akshada-raghuvanshiii/Adaptive_Retail_Companion/docs/paper/latex/figs/fig5_b1_wheel.pdf

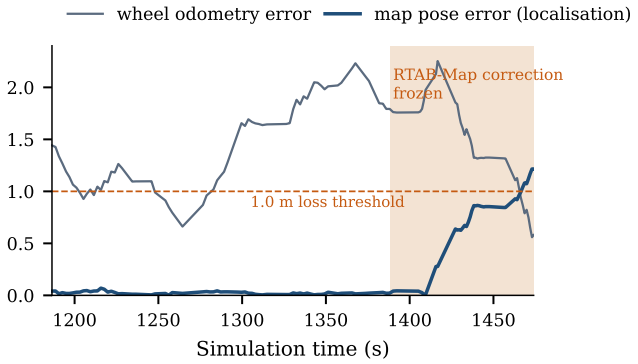
[picture p29: figure]
Simulation time (s); RTAB-Map correction frozen; 1.0 m loss threshold; wheel odometry error; map pose error (localisation)

### Error vs. truth (m)
