akshada-raghuvanshiii/Adaptive_Retail_Companion/docs/paper/latex/figs/fig2_localisation.pdf

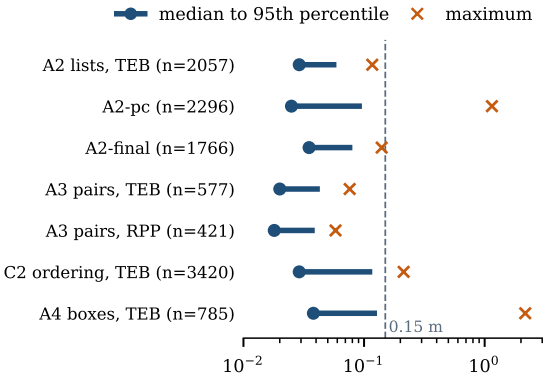
[picture p30: figure]
A4 boxes, TEB (n=785); C2 ordering, TEB (n=3420); A3 pairs, RPP (n=421); A3 pairs, TEB (n=577); A2-final (n=1766); A2 lists, TEB (n=2057); median to 95th percentile; maximum

Position error vs. truth (m, log)
