akshada-raghuvanshiii/Adaptive_Retail_Companion/docs/paper/latex/figs/fig4_c2_time.pdf

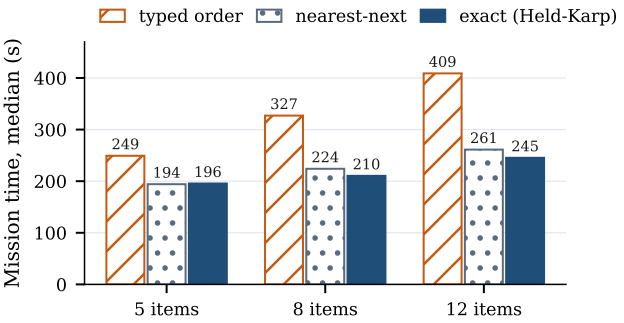
[picture p31: figure]
5 items; 8 items; 12 items; Mission time, median (s); typed order; nearest-next; exact (Held-Karp)
