akshada-raghuvanshiii/Adaptive_Retail_Companion/docs/paper/latex/figs/fig7_phase2_paired.pdf

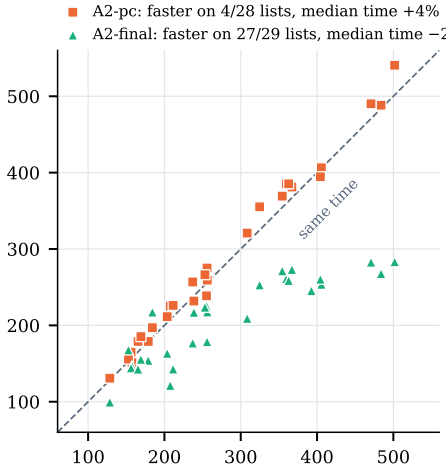
[picture p32: figure]
same time

## A2 mission time (s)

## Variant mission time (s)

points below the line were faster than A2 A2-pc: faster on 4/28 lists, median time +4% A2-final: faster on 27/29 lists, median time −23%
