akshada-raghuvanshiii/Adaptive_Retail_Companion/docs/paper/latex/figs/fig3_c1_ordering.pdf

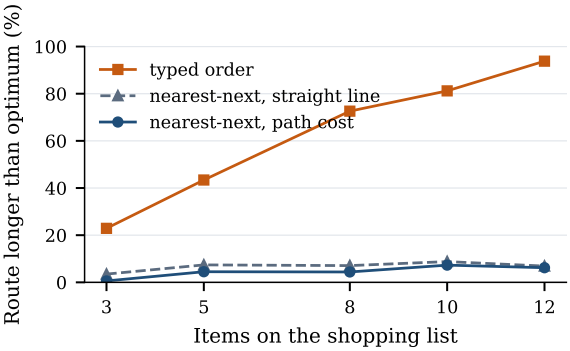
[picture p33: figure]
Items on the shopping list; Route longer than optimum (%); typed order nearest-next, straight line nearest-next, path cost
