akshada-raghuvanshiii/Adaptive_Retail_Companion/mechanical/cad/cart/motor.STEP

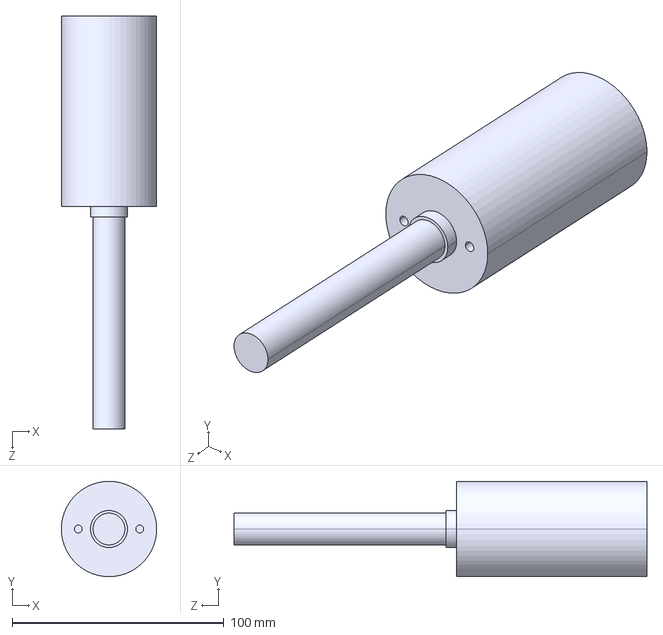
[picture p34: CAD file, 2026-10-20]
mechanical/cad/cart/motor.STEP
45.0 x 45.0 x 195.0 mm
