akshada-raghuvanshiii/Adaptive_Retail_Companion/mechanical/cad/cart/Part2.STEP

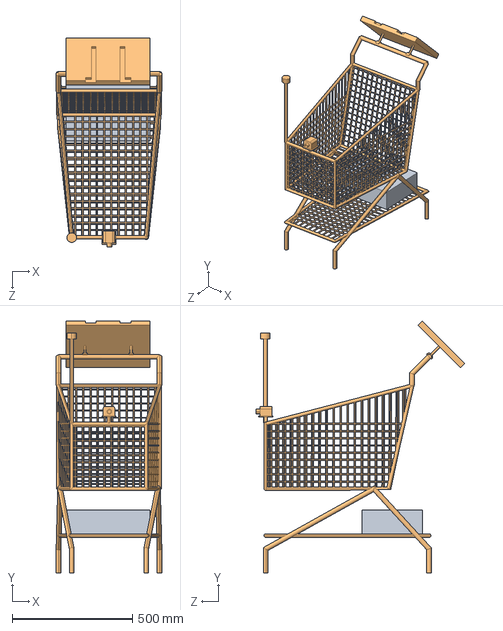
[picture p35: CAD file, 2026-10-20]
mechanical/cad/cart/Part2.STEP
440.0 x 1048.5 x 868.2 mm
