akshada-raghuvanshiii/Adaptive_Retail_Companion/mechanical/cad/cart/flange.STEP

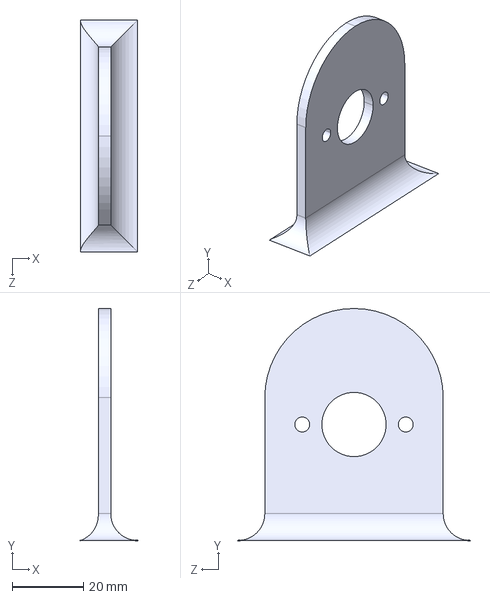
[picture p37: CAD file, 2026-10-20]
mechanical/cad/cart/flange.STEP
16.0 x 65.0 x 65.0 mm
