akshada-raghuvanshiii/Adaptive_Retail_Companion/mechanical/cad/cart/springs.STEP

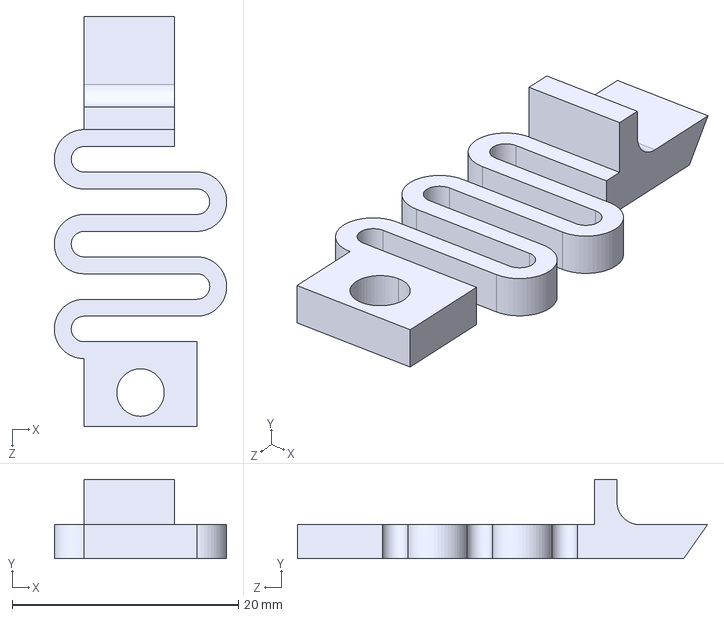
[picture p38: CAD file, 2026-10-20]
mechanical/cad/cart/springs.STEP
15.3 x 7.00 x 36.2 mm
