akshada-raghuvanshiii/Adaptive_Retail_Companion/mechanical/cad/cart/wheel mounts.STEP

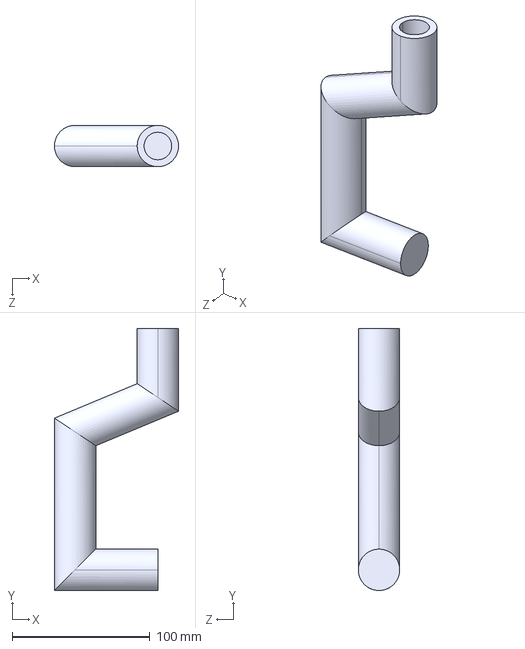
[picture p39: CAD file, 2026-10-20]
mechanical/cad/cart/wheel mounts.STEP
90.0 x 190.0 x 30.0 mm
