akshada-raghuvanshiii/Adaptive_Retail_Companion/mechanical/cad/cart/new sleeve.STEP

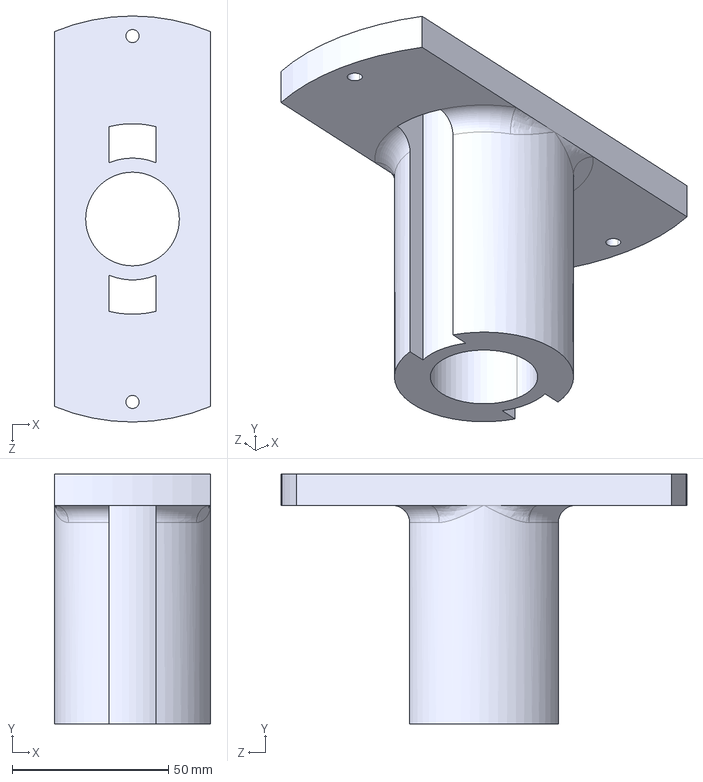
[picture p40: CAD file, 2026-10-20]
mechanical/cad/cart/new sleeve.STEP
50.0 x 80.0 x 130.0 mm
