akshada-raghuvanshiii/Adaptive_Retail_Companion/mechanical/cad/cart/extrude.STEP

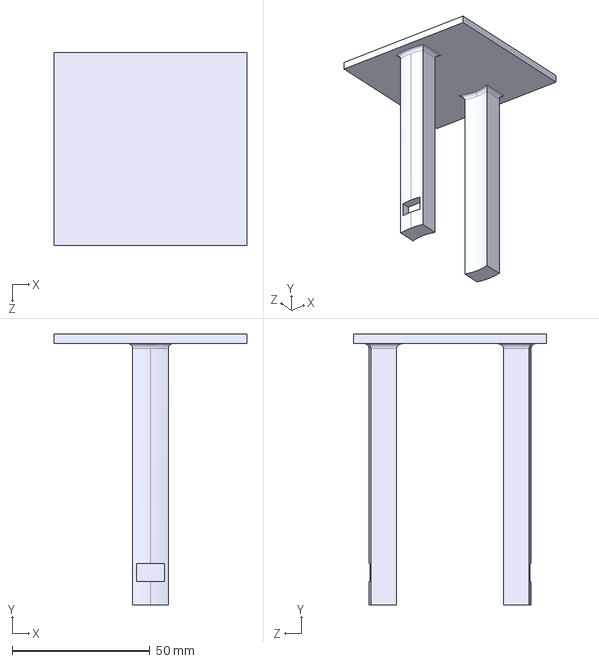
[picture p41: CAD file, 2026-10-20]
mechanical/cad/cart/extrude.STEP
70.0 x 98.5 x 70.0 mm
