akshada-raghuvanshiii/Adaptive_Retail_Companion/mechanical/cad/cart/wheel mounts for motor.STEP

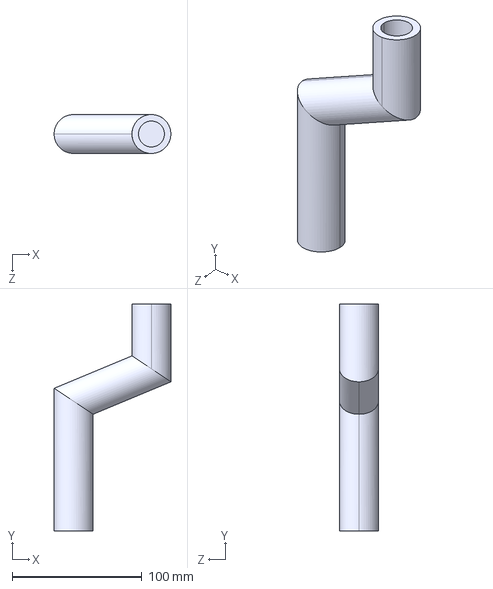
[picture p42: CAD file, 2026-10-20]
mechanical/cad/cart/wheel mounts for motor.STEP
90.0 x 175.0 x 30.0 mm
