akshada-raghuvanshiii/Adaptive_Retail_Companion/mechanical/cad/cart/wheels.STEP

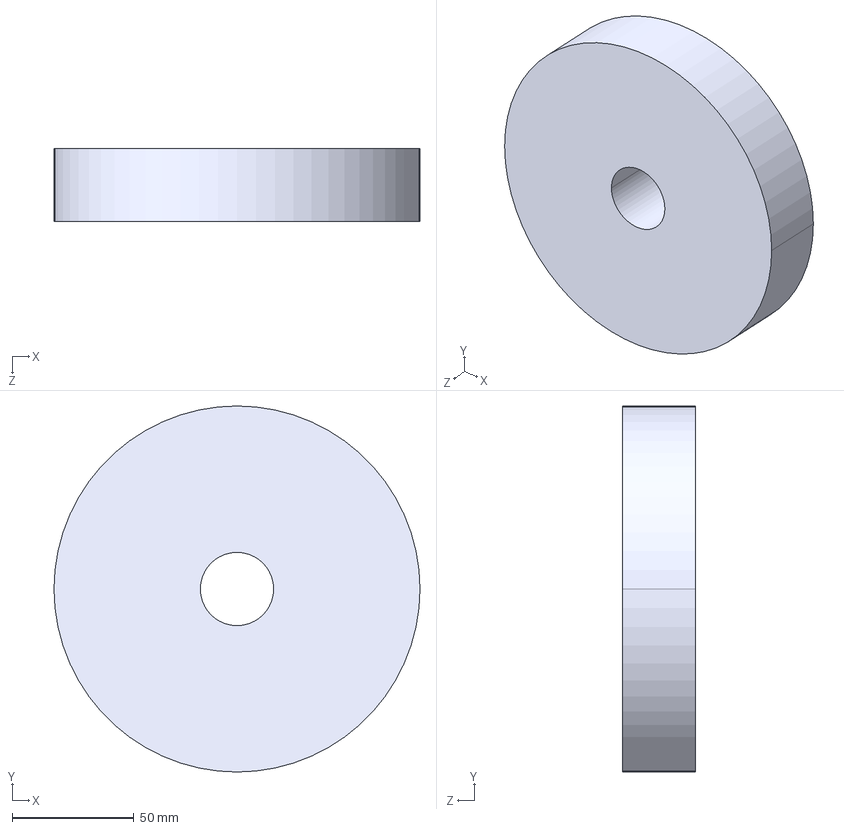
[picture p43: CAD file, 2026-10-20]
mechanical/cad/cart/wheels.STEP
150.0 x 150.0 x 30.0 mm
