akshada-raghuvanshiii/Adaptive_Retail_Companion/(list of files, cad)

Other CAD files:
mechanical/cad/Assem1.step
mechanical/cad/Assem1_v2.step
mechanical/cad/cart/Part5^modular assem.STEP
mechanical/cad/cart/Assem1.STEP
mechanical/cad/cart/Part2^Assem1.STEP
mechanical/cad/cart/Part8^modular assem.STEP
mechanical/cad/cart/Part3^Assem1.STEP
mechanical/cad/cart/Part6^modular assem.STEP
mechanical/cad/cart/Part7^modular assem.STEP
mechanical/cad/cart/Part10^modular assem.STEP
mechanical/cad/cart/modular assem.STEP
