akshada-raghuvanshiii/Adaptive_Retail_Companion/mechanical/simscale/assembly.png

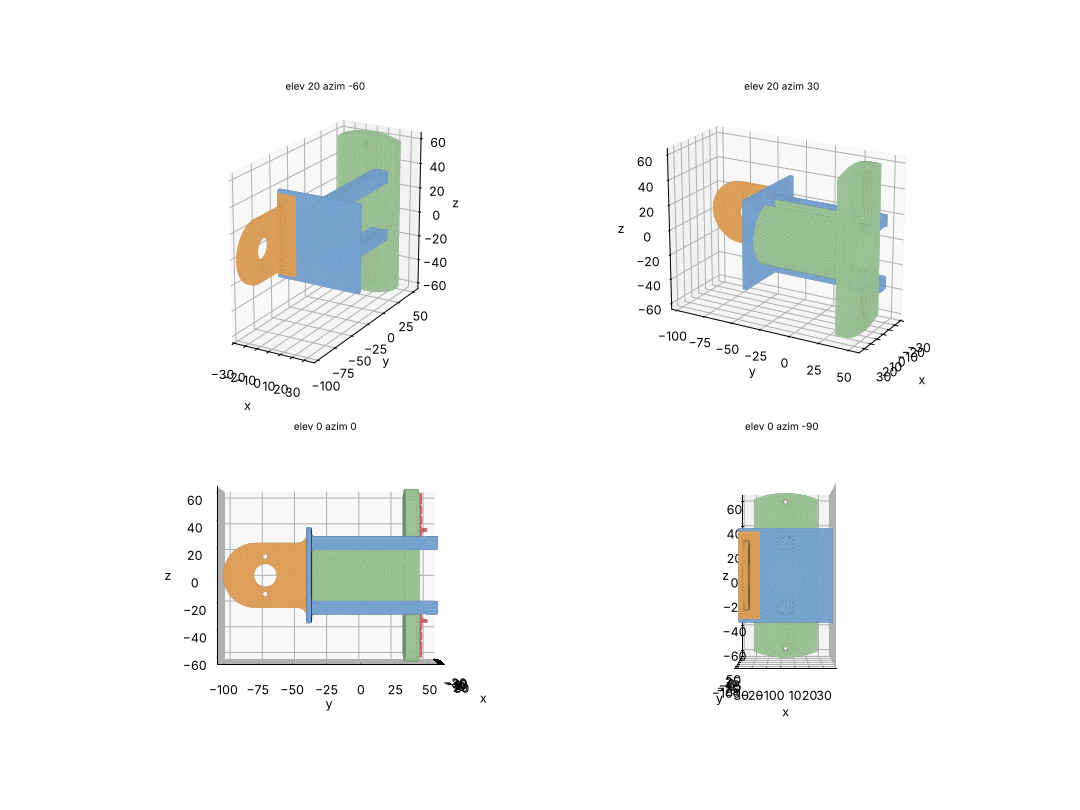
mechanical/simscale/assembly.png
