akshada-raghuvanshiii/Adaptive_Retail_Companion/mechanical/simscale/assembly_iso.png

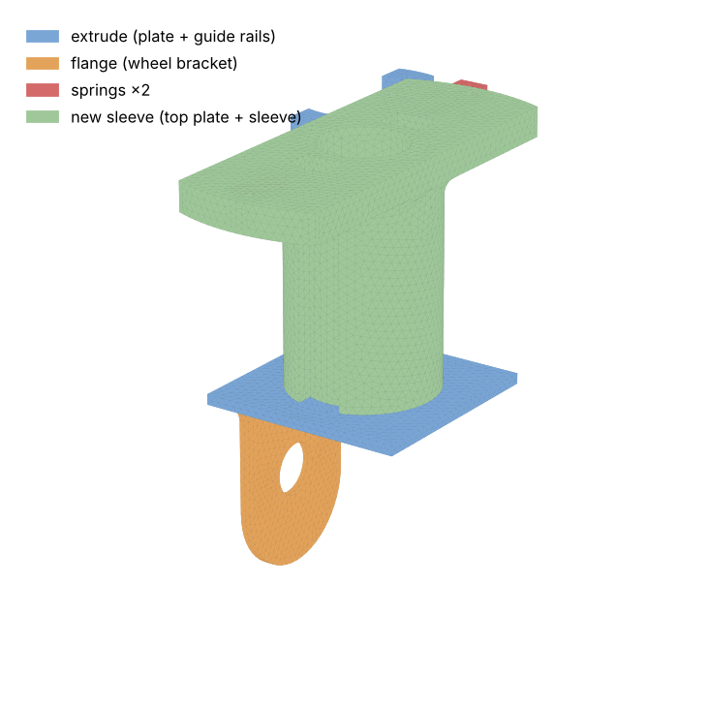
mechanical/simscale/assembly_iso.png
