akshada-raghuvanshiii/Adaptive_Retail_Companion/evaluation/results/events.csv

label | mission | leg | wall_t | sim_t | event | detail
smoke | smoke_s5_000 | -1 | 1792041810.787 | 437.140 | mission_start | pair00
smoke | smoke_s5_000 | -1 | 1792041810.789 | 437.140 | goal_sent | gondola_1_west_a (0.15, -0.40)
smoke | smoke_s5_000 | -1 | 1792041811.685 | 438.112 | path_received | 0.5328 m
smoke | smoke_s5_000 | -1 | 1792041822.475 | 448.128 | controller_aborted
smoke | smoke_s5_000 | -1 | 1792041823.480 | 449.016 | goal_resent | after controller abort
smoke | smoke_s5_000 | -1 | 1792041830.612 | 455.720 | goal_reached_msg
smoke | smoke_s5_000 | 0 | 1792041832.617 | 457.464 | goal_sent | gondola_3_a+gondola_2_east_a (3.48, -0.40)
smoke | smoke_s5_000 | 0 | 1792041837.050 | 461.688 | path_received | 4.3849 m
smoke | smoke_s5_000 | 0 | 1792041888.760 | 509.672 | goal_reached_msg
smoke | smoke_s5_000 | -1 | 1792041890.761 | 511.576 | mission_end | 1/1 legs
teb_icp | teb_icp_s7_000 | -1 | 1792041927.908 | 532.372 | mission_start | s7_r00_n8
teb_icp | teb_icp_s7_000 | -1 | 1792041927.911 | 532.372 | goal_sent | home (0.00, 0.00)
teb_icp | teb_icp_s7_000 | -1 | 1792041927.931 | 547.736 | path_received | 0 m
teb_icp | teb_icp_s7_000 | -1 | 1792041927.942 | 547.744 | goal_reached_msg
teb_icp | teb_icp_s7_000 | 0 | 1792041929.943 | 549.600 | goal_sent | gondola_1_west_a (0.15, -0.40)
teb_icp | teb_icp_s7_000 | 0 | 1792041930.265 | 549.812 | path_received | 4.8971 m
teb_icp | teb_icp_s7_000 | 0 | 1792041991.269 | 607.920 | goal_reached_msg
teb_icp | teb_icp_s7_000 | 1 | 1792041993.276 | 609.812 | goal_sent | dairy (-2.20, 2.75)
teb_icp | teb_icp_s7_000 | 1 | 1792041995.977 | 612.512 | path_received | 3.8663 m
teb_icp | teb_icp_s7_000 | 1 | 1792042044.981 | 659.236 | goal_reached_msg
teb_icp | teb_icp_s7_000 | 2 | 1792042046.987 | 661.112 | goal_sent | gondola_3_b+gondola_2_east_b (3.48, 1.40)
teb_icp | teb_icp_s7_000 | 2 | 1792042050.925 | 664.940 | path_received | 6.4556 m
teb_icp | teb_icp_s7_000 | 2 | 1792042120.431 | 730.072 | goal_reached_msg
teb_icp | teb_icp_s7_000 | 3 | 1792042122.441 | 731.888 | goal_sent | gondola_2_west_a+gondola_1_east_a (1.80, -0.40)
teb_icp | teb_icp_s7_000 | 3 | 1792042124.682 | 733.964 | path_received | 4.4763 m
teb_icp | teb_icp_s7_000 | 3 | 1792042183.106 | 788.892 | goal_reached_msg
teb_icp | teb_icp_s7_000 | -1 | 1792042185.115 | 790.800 | mission_end | 4/4 legs
teb_icp | teb_icp_s7_001 | -1 | 1792042185.115 | 790.800 | mission_start | s7_r01_n12
teb_icp | teb_icp_s7_001 | -1 | 1792042185.115 | 790.800 | goal_sent | home (0.00, 0.00)
teb_icp | teb_icp_s7_001 | -1 | 1792042188.017 | 793.452 | path_received | 3.1678 m
teb_icp | teb_icp_s7_001 | -1 | 1792042230.220 | 832.924 | controller_aborted
teb_icp | teb_icp_s7_001 | -1 | 1792042231.220 | 833.840 | goal_resent | after controller abort
teb_icp | teb_icp_s7_001 | -1 | 1792042233.209 | 835.720 | goal_reached_msg
teb_icp | teb_icp_s7_001 | 0 | 1792042235.214 | 837.628 | goal_sent | gondola_3_b+gondola_2_east_b (3.48, 1.40)
teb_icp | teb_icp_s7_001 | 0 | 1792042239.683 | 841.740 | path_received | 5.8471 m
teb_icp | teb_icp_s7_001 | 0 | 1792042304.395 | 902.880 | goal_reached_msg
teb_icp | teb_icp_s7_001 | 1 | 1792042306.405 | 904.684 | goal_sent | dairy (-2.20, 2.75)
teb_icp | teb_icp_s7_001 | 1 | 1792042311.574 | 909.484 | path_received | 6.3849 m
teb_icp | teb_icp_s7_001 | 1 | 1792042386.284 | 980.712 | goal_reached_msg
teb_icp | teb_icp_s7_001 | 2 | 1792042388.285 | 982.520 | goal_sent | gondola_3_a+gondola_2_east_a (3.48, -0.40)
teb_icp | teb_icp_s7_001 | 2 | 1792042394.295 | 988.156 | goal_resent_no_path
teb_icp | teb_icp_s7_001 | 2 | 1792042394.699 | 988.460 | path_received | 8.1849 m
teb_icp | teb_icp_s7_001 | 2 | 1792042483.102 | 1072.324 | goal_reached_msg
teb_icp | teb_icp_s7_001 | 3 | 1792042485.104 | 1074.232 | goal_sent | tea_coffee (-2.45, 0.40)
teb_icp | teb_icp_s7_001 | 3 | 1792042490.372 | 1079.252 | path_received | 7.1113 m
teb_icp | teb_icp_s7_001 | 3 | 1792042571.382 | 1156.920 | goal_reached_msg
teb_icp | teb_icp_s7_001 | 4 | 1792042573.405 | 1158.752 | goal_sent | gondola_1_west_a (0.15, -0.40)
teb_icp | teb_icp_s7_001 | 4 | 1792042576.323 | 1161.560 | path_received | 2.9314 m
teb_icp | teb_icp_s7_001 | 4 | 1792042614.219 | 1197.352 | controller_aborted
teb_icp | teb_icp_s7_001 | 4 | 1792042615.219 | 1198.360 | goal_resent | after controller abort
teb_icp | teb_icp_s7_001 | 4 | 1792042617.978 | 1201.112 | goal_reached_msg
teb_icp | teb_icp_s7_001 | 5 | 1792042619.982 | 1203.088 | goal_sent | produce (-1.40, 0.05)
teb_icp | teb_icp_s7_001 | 5 | 1792042621.995 | 1204.888 | path_received | 1.7364 m
teb_icp | teb_icp_s7_001 | 5 | 1792042649.604 | 1230.912 | goal_reached_msg
teb_icp | teb_icp_s7_001 | 6 | 1792042651.609 | 1232.824 | goal_sent | gondola_2_west_b+gondola_1_east_b (1.80, 1.40)
teb_icp | teb_icp_s7_001 | 6 | 1792042655.498 | 1236.684 | path_received | 4.7148 m
teb_icp | teb_icp_s7_001 | 6 | 1792042710.905 | 1288.912 | controller_aborted
teb_icp | teb_icp_s7_001 | 6 | 1792042711.910 | 1289.912 | goal_resent | after controller abort
teb_icp | teb_icp_s7_001 | 6 | 1792042717.114 | 1294.692 | goal_reached_msg
teb_icp | teb_icp_s7_001 | -1 | 1792042719.115 | 1296.584 | mission_end | 7/7 legs
teb_icp | teb_icp_s7_002 | -1 | 1792042719.116 | 1296.584 | mission_start | s7_r02_n3
teb_icp | teb_icp_s7_002 | -1 | 1792042719.116 | 1296.584 | goal_sent | home (0.00, 0.00)
teb_icp | teb_icp_s7_002 | -1 | 1792042723.412 | 1300.568 | path_received | 4.0678 m
teb_icp | teb_icp_s7_002 | -1 | 1792042776.116 | 1350.548 | controller_aborted
teb_icp | teb_icp_s7_002 | -1 | 1792042777.117 | 1351.452 | goal_resent | after controller abort
teb_icp | teb_icp_s7_002 | -1 | 1792042779.788 | 1353.900 | goal_reached_msg
teb_icp | teb_icp_s7_002 | 0 | 1792042781.794 | 1355.788 | goal_sent | gondola_3_b+gondola_2_east_b (3.48, 1.40)
teb_icp | teb_icp_s7_002 | 0 | 1792042786.770 | 1360.416 | path_received | 5.8471 m
teb_icp | teb_icp_s7_002 | 0 | 1792042851.272 | 1420.632 | goal_reached_msg
teb_icp | teb_icp_s7_002 | 1 | 1792042853.278 | 1422.448 | goal_sent | gondola_3_a+gondola_2_east_a (3.48, -0.40)
teb_icp | teb_icp_s7_002 | 1 | 1792042855.375 | 1424.448 | path_received | 1.8 m
teb_icp | teb_icp_s7_002 | 1 | 1792042885.390 | 1452.644 | controller_aborted
teb_icp | teb_icp_s7_002 | 1 | 1792042886.394 | 1453.508 | goal_resent | after controller abort
teb_icp | teb_icp_s7_002 | 1 | 1792042890.297 | 1457.104 | goal_reached_msg
teb_icp | teb_icp_s7_002 | 2 | 1792042892.303 | 1459.008 | goal_sent | gondola_2_west_a+gondola_1_east_a (1.80, -0.40)
teb_icp | teb_icp_s7_002 | 2 | 1792042894.123 | 1460.772 | path_received | 2.7056 m
teb_icp | teb_icp_s7_002 | 2 | 1792042937.228 | 1501.036 | goal_reached_msg
teb_icp | teb_icp_s7_002 | -1 | 1792042939.233 | 1502.848 | mission_end | 3/3 legs
teb_icp | teb_icp_s7_003 | -1 | 1792042939.233 | 1502.848 | mission_start | s7_r03_n6
teb_icp | teb_icp_s7_003 | -1 | 1792042939.233 | 1502.848 | goal_sent | home (0.00, 0.00)
teb_icp | teb_icp_s7_003 | -1 | 1792042942.076 | 1505.480 | path_received | 3.1678 m
teb_icp | teb_icp_s7_003 | -1 | 1792042983.485 | 1544.740 | controller_aborted
teb_icp | teb_icp_s7_003 | -1 | 1792042984.492 | 1545.620 | goal_resent | after controller abort
teb_icp | teb_icp_s7_003 | -1 | 1792042987.593 | 1548.500 | goal_reached_msg
teb_icp | teb_icp_s7_003 | 0 | 1792042989.598 | 1550.404 | goal_sent | gondola_3_b+gondola_2_east_b (3.48, 1.40)
teb_icp | teb_icp_s7_003 | 0 | 1792042995.599 | 1555.948 | goal_resent_no_path
teb_icp | teb_icp_s7_003 | 0 | 1792042996.103 | 1556.432 | path_received | 5.8471 m
teb_icp | teb_icp_s7_003 | 0 | 1792043062.208 | 1618.312 | goal_reached_msg
teb_icp | teb_icp_s7_003 | 1 | 1792043064.214 | 1620.316 | goal_sent | tea_coffee (-2.45, 0.40)
teb_icp | teb_icp_s7_003 | 1 | 1792043070.215 | 1625.852 | goal_resent_no_path
teb_icp | teb_icp_s7_003 | 1 | 1792043070.541 | 1626.176 | path_received | 7.4406 m
teb_icp | teb_icp_s7_003 | 1 | 1792043157.054 | 1707.652 | goal_reached_msg
teb_icp | teb_icp_s7_003 | 2 | 1792043159.060 | 1709.660 | goal_sent | gondola_3_a+gondola_2_east_a (3.48, -0.40)
teb_icp | teb_icp_s7_003 | 2 | 1792043162.695 | 1713.260 | path_received | 7.1113 m
teb_icp | teb_icp_s7_003 | 2 | 1792043219.068 | 1766.936 | sim_link_lost | no Gazebo pose for 15 s
teb_icp | teb_icp_s7_003 | 2 | 1792043219.068 | 1766.936 | leg_failed | sim_link_lost
teb_icp | teb_icp_s7_003 | 2 | 1792043219.080 | 1766.948 | runner_cancelled_follow_path
teb_icp | teb_icp_s7_003 | -1 | 1792043221.083 | 1768.848 | mission_end | 2/4 legs
teb_icp | teb_icp_s7_003 | -1 | 1792043712.068 | 2234.884 | mission_start | s7_r03_n6
teb_icp | teb_icp_s7_003 | -1 | 1792043712.070 | 2234.884 | goal_sent | home (0.00, 0.00)
teb_icp | teb_icp_s7_003 | -1 | 1792043715.212 | 2252.172 | path_received | 4.8471 m
teb_icp | teb_icp_s7_003 | -1 | 1792043777.485 | 2310.268 | goal_reached_msg
teb_icp | teb_icp_s7_003 | 0 | 1792043779.496 | 2312.040 | goal_sent | gondola_3_b+gondola_2_east_b (3.48, 1.40)
teb_icp | teb_icp_s7_003 | 0 | 1792043785.502 | 2317.704 | goal_resent_no_path
teb_icp | teb_icp_s7_003 | 0 | 1792043786.022 | 2318.128 | path_received | 5.8471 m
teb_icp | teb_icp_s7_003 | 0 | 1792043850.038 | 2379.236 | goal_reached_msg
teb_icp | teb_icp_s7_003 | 1 | 1792043852.042 | 2381.136 | goal_sent | tea_coffee (-2.45, 0.40)
teb_icp | teb_icp_s7_003 | 1 | 1792043857.284 | 2386.004 | path_received | 7.4406 m
teb_icp | teb_icp_s7_003 | 1 | 1792043943.291 | 2467.504 | goal_reached_msg
teb_icp | teb_icp_s7_003 | 2 | 1792043945.293 | 2469.380 | goal_sent | gondola_3_a+gondola_2_east_a (3.48, -0.40)
teb_icp | teb_icp_s7_003 | 2 | 1792043949.794 | 2473.756 | path_received | 7.1113 m
teb_icp | teb_icp_s7_003 | 2 | 1792044023.696 | 2544.688 | goal_reached_msg
teb_icp | teb_icp_s7_003 | 3 | 1792044025.707 | 2546.576 | goal_sent | gondola_2_west_b+gondola_1_east_b (1.80, 1.40)
teb_icp | teb_icp_s7_003 | 3 | 1792044028.848 | 2549.696 | path_received | 4.4763 m
teb_icp | teb_icp_s7_003 | 3 | 1792044085.951 | 2604.224 | goal_reached_msg
teb_icp | teb_icp_s7_003 | -1 | 1792044087.956 | 2606.032 | mission_end | 4/4 legs
teb_icp | teb_icp_s7_004 | -1 | 1792044087.956 | 2606.032 | mission_start | s7_r04_n9
teb_icp | teb_icp_s7_004 | -1 | 1792044087.957 | 2606.032 | goal_sent | home (0.00, 0.00)
teb_icp | teb_icp_s7_004 | -1 | 1792044092.054 | 2610.092 | path_received | 4.0678 m
teb_icp | teb_icp_s7_004 | -1 | 1792044144.156 | 2660.180 | controller_aborted
teb_icp | teb_icp_s7_004 | -1 | 1792044145.160 | 2661.156 | goal_resent | after controller abort
teb_icp | teb_icp_s7_004 | -1 | 1792044148.223 | 2664.108 | goal_reached_msg
teb_icp | teb_icp_s7_004 | 0 | 1792044150.225 | 2665.924 | goal_sent | gondola_3_b+gondola_2_east_b (3.48, 1.40)
teb_icp | teb_icp_s7_004 | 0 | 1792044155.052 | 2670.372 | path_received | 5.8471 m
teb_icp | teb_icp_s7_004 | 0 | 1792044228.156 | 2739.732 | controller_aborted
teb_icp | teb_icp_s7_004 | 0 | 1792044229.160 | 2740.596 | goal_resent | after controller abort
teb_icp | teb_icp_s7_004 | 0 | 1792044232.358 | 2743.692 | goal_reached_msg
teb_icp | teb_icp_s7_004 | 1 | 1792044234.363 | 2745.700 | goal_sent | gondola_3_a+gondola_2_east_a (3.48, -0.40)
teb_icp | teb_icp_s7_004 | 1 | 1792044235.023 | 2746.340 | path_received | 1.8 m
teb_icp | teb_icp_s7_004 | 1 | 1792044264.122 | 2774.688 | controller_aborted
teb_icp | teb_icp_s7_004 | 1 | 1792044265.124 | 2775.688 | goal_resent | after controller abort
teb_icp | teb_icp_s7_004 | 1 | 1792044267.549 | 2778.112 | goal_reached_msg
teb_icp | teb_icp_s7_004 | 2 | 1792044269.552 | 2780.092 | goal_sent | tea_coffee (-2.45, 0.40)
teb_icp | teb_icp_s7_004 | 2 | 1792044275.453 | 2785.780 | path_received | 7.1113 m
teb_icp | teb_icp_s7_004 | 2 | 1792044357.155 | 2863.316 | goal_reached_msg
teb_icp | teb_icp_s7_004 | 3 | 1792044359.157 | 2865.200 | goal_sent | gondola_1_west_a (0.15, -0.40)
teb_icp | teb_icp_s7_004 | 3 | 1792044361.481 | 2867.300 | path_received | 2.9314 m
teb_icp | teb_icp_s7_004 | 3 | 1792044398.976 | 2902.868 | controller_aborted
teb_icp | teb_icp_s7_004 | 3 | 1792044399.981 | 2903.852 | goal_resent | after controller abort
teb_icp | teb_icp_s7_004 | 3 | 1792044405.035 | 2908.472 | goal_reached_msg
teb_icp | teb_icp_s7_004 | 4 | 1792044407.039 | 2910.384 | goal_sent | gondola_2_west_b+gondola_1_east_b (1.80, 1.40)
teb_icp | teb_icp_s7_004 | 4 | 1792044412.341 | 2915.304 | path_received | 4.4056 m
teb_icp | teb_icp_s7_004 | 4 | 1792044469.544 | 2968.948 | controller_aborted
teb_icp | teb_icp_s7_004 | 4 | 1792044470.549 | 2969.948 | goal_resent | after controller abort
teb_icp | teb_icp_s7_004 | 4 | 1792044475.214 | 2974.276 | goal_reached_msg
teb_icp | teb_icp_s7_004 | 5 | 1792044477.218 | 2976.280 | goal_sent | produce (-1.40, 0.05)
teb_icp | teb_icp_s7_004 | 5 | 1792044481.771 | 2980.808 | path_received | 4.7148 m
teb_icp | teb_icp_s7_004 | 5 | 1792044538.776 | 3035.752 | controller_aborted
teb_icp | teb_icp_s7_004 | 5 | 1792044539.799 | 3036.676 | goal_resent | after controller abort
teb_icp | teb_icp_s7_004 | 5 | 1792044540.835 | 3037.664 | goal_reached_msg
teb_icp | teb_icp_s7_004 | -1 | 1792044542.841 | 3039.460 | mission_end | 6/6 legs
teb_icp | teb_icp_s7_005 | -1 | 1792044542.841 | 3039.460 | mission_start | s7_r05_n4
teb_icp | teb_icp_s7_005 | -1 | 1792044542.842 | 3039.460 | goal_sent | home (0.00, 0.00)
teb_icp | teb_icp_s7_005 | -1 | 1792044544.092 | 3040.696 | path_received | 1.4207 m
teb_icp | teb_icp_s7_005 | -1 | 1792044556.591 | 3052.648 | goal_reached_msg
teb_icp | teb_icp_s7_005 | 0 | 1792044558.592 | 3054.552 | goal_sent | gondola_3_a+gondola_2_east_a (3.48, -0.40)
teb_icp | teb_icp_s7_005 | 0 | 1792044564.602 | 3060.108 | goal_resent_no_path
teb_icp | teb_icp_s7_005 | 0 | 1792044564.785 | 3060.288 | path_received | 5.0006 m
teb_icp | teb_icp_s7_005 | 0 | 1792044618.188 | 3111.900 | goal_reached_msg
teb_icp | teb_icp_s7_005 | 1 | 1792044620.193 | 3113.804 | goal_sent | gondola_2_west_b+gondola_1_east_b (1.80, 1.40)
teb_icp | teb_icp_s7_005 | 1 | 1792044622.385 | 3115.864 | path_received | 4.4763 m
teb_icp | teb_icp_s7_005 | 1 | 1792044679.599 | 3170.312 | goal_reached_msg
teb_icp | teb_icp_s7_005 | 2 | 1792044681.605 | 3172.316 | goal_sent | gondola_3_b+gondola_2_east_b (3.48, 1.40)
teb_icp | teb_icp_s7_005 | 2 | 1792044684.964 | 3175.440 | path_received | 2.6763 m
teb_icp | teb_icp_s7_005 | 2 | 1792044712.868 | 3202.712 | goal_reached_msg
teb_icp | teb_icp_s7_005 | -1 | 1792044714.871 | 3204.608 | mission_end | 3/3 legs
teb_icp | teb_icp_s7_006 | -1 | 1792044714.871 | 3204.608 | mission_start | s7_r06_n5
teb_icp | teb_icp_s7_006 | -1 | 1792044714.871 | 3204.608 | goal_sent | home (0.00, 0.00)
teb_icp | teb_icp_s7_006 | -1 | 1792044719.222 | 3208.820 | path_received | 5.8471 m
teb_icp | teb_icp_s7_006 | -1 | 1792044790.833 | 3277.448 | goal_reached_msg
teb_icp | teb_icp_s7_006 | 0 | 1792044792.837 | 3279.360 | goal_sent | gondola_2_west_a+gondola_1_east_a (1.80, -0.40)
teb_icp | teb_icp_s7_006 | 0 | 1792044795.290 | 3281.768 | path_received | 3.1678 m
teb_icp | teb_icp_s7_006 | 0 | 1792044831.794 | 3316.256 | goal_reached_msg
teb_icp | teb_icp_s7_006 | 1 | 1792044833.796 | 3318.260 | goal_sent | gondola_3_a+gondola_2_east_a (3.48, -0.40)
teb_icp | teb_icp_s7_006 | 1 | 1792044836.547 | 3320.980 | path_received | 2.7056 m
teb_icp | teb_icp_s7_006 | 1 | 1792044867.154 | 3349.864 | goal_reached_msg
teb_icp | teb_icp_s7_006 | 2 | 1792044869.159 | 3351.868 | goal_sent | gondola_3_b+gondola_2_east_b (3.48, 1.40)
teb_icp | teb_icp_s7_006 | 2 | 1792044869.646 | 3352.352 | path_received | 1.8 m
teb_icp | teb_icp_s7_006 | 2 | 1792044895.354 | 3377.104 | goal_reached_msg
teb_icp | teb_icp_s7_006 | 3 | 1792044897.355 | 3378.996 | goal_sent | dairy (-2.20, 2.75)
teb_icp | teb_icp_s7_006 | 3 | 1792044902.083 | 3383.340 | path_received | 6.3349 m
teb_icp | teb_icp_s7_006 | 3 | 1792044975.092 | 3453.516 | goal_reached_msg
teb_icp | teb_icp_s7_006 | -1 | 1792044977.093 | 3455.424 | mission_end | 4/4 legs
teb_icp | teb_icp_s7_007 | -1 | 1792044977.094 | 3455.424 | mission_start | s7_r07_n4
teb_icp | teb_icp_s7_007 | -1 | 1792044977.094 | 3455.424 | goal_sent | home (0.00, 0.00)
teb_icp | teb_icp_s7_007 | -1 | 1792044979.633 | 3457.752 | path_received | 3.8663 m
teb_icp | teb_icp_s7_007 | -1 | 1792045021.862 | 3498.068 | goal_reached_msg
teb_icp | teb_icp_s7_007 | 0 | 1792045023.864 | 3499.952 | goal_sent | gondola_3_b+gondola_2_east_b (3.48, 1.40)
teb_icp | teb_icp_s7_007 | 0 | 1792045027.621 | 3503.696 | path_received | 5.8471 m
teb_icp | teb_icp_s7_007 | 0 | 1792045093.226 | 3566.464 | goal_reached_msg
teb_icp | teb_icp_s7_007 | 1 | 1792045095.228 | 3568.468 | goal_sent | gondola_1_west_a (0.15, -0.40)
teb_icp | teb_icp_s7_007 | 1 | 1792045099.922 | 3572.876 | path_received | 6.1849 m
teb_icp | teb_icp_s7_007 | 1 | 1792045172.726 | 3641.924 | controller_aborted
teb_icp | teb_icp_s7_007 | 1 | 1792045173.727 | 3642.820 | goal_resent | after controller abort
teb_icp | teb_icp_s7_007 | 1 | 1792045177.224 | 3646.080 | goal_reached_msg
teb_icp | teb_icp_s7_007 | 2 | 1792045179.226 | 3647.972 | goal_sent | gondola_3_a+gondola_2_east_a (3.48, -0.40)
teb_icp | teb_icp_s7_007 | 2 | 1792045182.864 | 3651.364 | path_received | 4.3849 m
teb_icp | teb_icp_s7_007 | 2 | 1792045198.957 | 3667.288 | truth_gap | no Gazebo pose for 15 s (gz service); A1 samples blank
teb_icp | teb_icp_s7_007 | 2 | 1792045221.746 | 3689.616 | truth_gap | no Gazebo pose for 15 s (gz service); A1 samples blank
teb_icp | teb_icp_s7_007 | 2 | 1792045229.467 | 3697.056 | goal_reached_msg
teb_icp | teb_icp_s7_007 | -1 | 1792045231.474 | 3698.944 | mission_end | 3/3 legs
teb_icp | teb_icp_s7_008 | -1 | 1792045231.474 | 3698.944 | mission_start | s7_r08_n3
teb_icp | teb_icp_s7_008 | -1 | 1792045231.474 | 3698.944 | goal_sent | home (0.00, 0.00)
teb_icp | teb_icp_s7_008 | -1 | 1792045234.701 | 3702.076 | path_received | 4.8471 m
teb_icp | teb_icp_s7_008 | -1 | 1792045295.104 | 3760.024 | goal_reached_msg
teb_icp | teb_icp_s7_008 | 0 | 1792045297.108 | 3762.028 | goal_sent | gondola_2_west_a+gondola_1_east_a (1.80, -0.40)
teb_icp | teb_icp_s7_008 | 0 | 1792045301.317 | 3765.996 | path_received | 3.1678 m
teb_icp | teb_icp_s7_008 | 0 | 1792045341.315 | 3804.324 | controller_aborted
teb_icp | teb_icp_s7_008 | 0 | 1792045342.315 | 3805.332 | goal_resent | after controller abort
teb_icp | teb_icp_s7_008 | 0 | 1792045349.317 | 3811.868 | goal_reached_msg
teb_icp | teb_icp_s7_008 | 1 | 1792045351.322 | 3813.672 | goal_sent | gondola_3_a+gondola_2_east_a (3.48, -0.40)
teb_icp | teb_icp_s7_008 | 1 | 1792045353.095 | 3815.324 | path_received | 2.7056 m
teb_icp | teb_icp_s7_008 | 1 | 1792045382.202 | 3843.488 | goal_reached_msg
teb_icp | teb_icp_s7_008 | 2 | 1792045384.210 | 3845.500 | goal_sent | tea_coffee (-2.45, 0.40)
teb_icp | teb_icp_s7_008 | 2 | 1792045390.218 | 3850.980 | goal_resent_no_path
teb_icp | teb_icp_s7_008 | 2 | 1792045390.290 | 3851.048 | path_received | 7.1113 m
teb_icp | teb_icp_s7_008 | 2 | 1792045473.904 | 3928.940 | goal_reached_msg
teb_icp | teb_icp_s7_008 | -1 | 1792045475.911 | 3930.920 | mission_end | 3/3 legs
teb_icp | teb_icp_s7_009 | -1 | 1792045475.911 | 3930.920 | mission_start | s7_r09_n11
teb_icp | teb_icp_s7_009 | -1 | 1792045475.911 | 3930.920 | goal_sent | home (0.00, 0.00)
teb_icp | teb_icp_s7_009 | -1 | 1792045478.648 | 3933.628 | path_received | 2.6157 m
teb_icp | teb_icp_s7_009 | -1 | 1792045517.153 | 3969.564 | controller_aborted
teb_icp | teb_icp_s7_009 | -1 | 1792045518.165 | 3970.576 | goal_resent | after controller abort
teb_icp | teb_icp_s7_009 | -1 | 1792045521.610 | 3973.756 | goal_reached_msg
teb_icp | teb_icp_s7_009 | 0 | 1792045523.614 | 3975.580 | goal_sent | produce (-1.40, 0.05)
teb_icp | teb_icp_s7_009 | 0 | 1792045524.687 | 3976.652 | path_received | 1.4207 m
teb_icp | teb_icp_s7_009 | 0 | 1792045535.196 | 3986.748 | controller_aborted
teb_icp | teb_icp_s7_009 | 0 | 1792045536.201 | 3987.692 | goal_resent | after controller abort
teb_icp | teb_icp_s7_009 | 0 | 1792045552.520 | 4003.524 | goal_reached_msg
teb_icp | teb_icp_s7_009 | 1 | 1792045554.526 | 4005.408 | goal_sent | gondola_2_west_b+gondola_1_east_b (1.80, 1.40)
teb_icp | teb_icp_s7_009 | 1 | 1792045560.181 | 4010.552 | path_received | 4.7148 m
teb_icp | teb_icp_s7_009 | 1 | 1792045615.218 | 4062.752 | controller_aborted
teb_icp | teb_icp_s7_009 | 1 | 1792045616.223 | 4063.756 | goal_resent | after controller abort
teb_icp | teb_icp_s7_009 | 1 | 1792045622.388 | 4069.656 | goal_reached_msg
teb_icp | teb_icp_s7_009 | 2 | 1792045624.398 | 4071.552 | goal_sent | gondola_3_a+gondola_2_east_a (3.48, -0.40)
teb_icp | teb_icp_s7_009 | 2 | 1792045629.328 | 4076.020 | path_received | 4.4763 m
teb_icp | teb_icp_s7_009 | 2 | 1792045679.123 | 4122.300 | goal_reached_msg
teb_icp | teb_icp_s7_009 | 3 | 1792045681.135 | 4124.196 | goal_sent | gondola_1_west_b (0.15, 1.40)
teb_icp | teb_icp_s7_009 | 3 | 1792045687.138 | 4130.016 | goal_resent_no_path
teb_icp | teb_icp_s7_009 | 3 | 1792045687.408 | 4130.268 | path_received | 6.1849 m
teb_icp | teb_icp_s7_009 | 3 | 1792045762.409 | 4200.468 | controller_aborted
teb_icp | teb_icp_s7_009 | 3 | 1792045763.410 | 4201.480 | goal_resent | after controller abort
teb_icp | teb_icp_s7_009 | 3 | 1792045768.561 | 4206.504 | goal_reached_msg
teb_icp | teb_icp_s7_009 | 4 | 1792045770.567 | 4208.512 | goal_sent | tea_coffee (-2.45, 0.40)
teb_icp | teb_icp_s7_009 | 4 | 1792045774.975 | 4212.656 | path_received | 3.0556 m
teb_icp | teb_icp_s7_009 | 4 | 1792045816.173 | 4252.036 | goal_reached_msg
teb_icp | teb_icp_s7_009 | 5 | 1792045818.183 | 4254.028 | goal_sent | dairy (-2.20, 2.75)
teb_icp | teb_icp_s7_009 | 5 | 1792045821.537 | 4257.236 | path_received | 2.4536 m
teb_icp | teb_icp_s7_009 | 5 | 1792045851.442 | 4285.672 | goal_reached_msg
teb_icp | teb_icp_s7_009 | 6 | 1792045853.449 | 4287.580 | goal_sent | gondola_3_b+gondola_2_east_b (3.48, 1.40)
teb_icp | teb_icp_s7_009 | 6 | 1792045858.599 | 4292.168 | path_received | 6.3849 m
teb_icp | teb_icp_s7_009 | 6 | 1792045927.306 | 4357.260 | goal_reached_msg
teb_icp | teb_icp_s7_009 | -1 | 1792045929.319 | 4359.252 | mission_end | 7/7 legs
teb_icp | teb_icp_s7_010 | -1 | 1792045929.319 | 4359.252 | mission_start | s7_r10_n4
teb_icp | teb_icp_s7_010 | -1 | 1792045929.319 | 4359.252 | goal_sent | home (0.00, 0.00)
teb_icp | teb_icp_s7_010 | -1 | 1792045933.860 | 4363.664 | path_received | 5.8471 m
teb_icp | teb_icp_s7_010 | -1 | 1792045978.662 | 4406.132 | truth_gap | no Gazebo pose for 15 s (gz service); A1 samples blank
teb_icp | teb_icp_s7_010 | -1 | 1792046006.471 | 4432.640 | goal_reached_msg
teb_icp | teb_icp_s7_010 | 0 | 1792046008.501 | 4434.652 | goal_sent | gondola_3_a+gondola_2_east_a (3.48, -0.40)
teb_icp | teb_icp_s7_010 | 0 | 1792046014.502 | 4440.176 | goal_resent_no_path
teb_icp | teb_icp_s7_010 | 0 | 1792046015.730 | 4441.276 | path_received | 4.8471 m
teb_icp | teb_icp_s7_010 | 0 | 1792046070.040 | 4492.924 | goal_reached_msg
teb_icp | teb_icp_s7_010 | 1 | 1792046072.046 | 4494.916 | goal_sent | gondola_2_west_b+gondola_1_east_b (1.80, 1.40)
teb_icp | teb_icp_s7_010 | 1 | 1792046076.071 | 4498.668 | path_received | 4.4763 m
teb_icp | teb_icp_s7_010 | 1 | 1792046133.973 | 4552.916 | goal_reached_msg
teb_icp | teb_icp_s7_010 | 2 | 1792046135.982 | 4554.748 | goal_sent | dairy (-2.20, 2.75)
teb_icp | teb_icp_s7_010 | 2 | 1792046141.816 | 4560.352 | path_received | 4.6263 m
teb_icp | teb_icp_s7_010 | 2 | 1792046199.721 | 4614.952 | controller_aborted
teb_icp | teb_icp_s7_010 | 2 | 1792046200.721 | 4615.912 | goal_resent | after controller abort
teb_icp | teb_icp_s7_010 | 2 | 1792046200.851 | 4616.000 | goal_reached_msg
teb_icp | teb_icp_s7_010 | 3 | 1792046202.859 | 4618.032 | goal_sent | tea_coffee (-2.45, 0.40)
teb_icp | teb_icp_s7_010 | 3 | 1792046205.848 | 4620.956 | path_received | 2.4828 m
teb_icp | teb_icp_s7_010 | 3 | 1792046240.955 | 4653.888 | controller_aborted
teb_icp | teb_icp_s7_010 | 3 | 1792046241.963 | 4654.800 | goal_resent | after controller abort
teb_icp | teb_icp_s7_010 | 3 | 1792046245.105 | 4657.716 | goal_reached_msg
teb_icp | teb_icp_s7_010 | -1 | 1792046247.115 | 4659.704 | mission_end | 4/4 legs
teb_icp | teb_icp_s7_011 | -1 | 1792046247.115 | 4659.704 | mission_start | s7_r11_n8
teb_icp | teb_icp_s7_011 | -1 | 1792046247.115 | 4659.704 | goal_sent | home (0.00, 0.00)
teb_icp | teb_icp_s7_011 | -1 | 1792046248.899 | 4661.392 | path_received | 2.6157 m
teb_icp | teb_icp_s7_011 | -1 | 1792046286.699 | 4697.196 | controller_aborted
teb_icp | teb_icp_s7_011 | -1 | 1792046287.708 | 4698.196 | goal_resent | after controller abort
teb_icp | teb_icp_s7_011 | -1 | 1792046291.784 | 4701.916 | goal_reached_msg
teb_icp | teb_icp_s7_011 | 0 | 1792046293.788 | 4703.816 | goal_sent | gondola_3_a+gondola_2_east_a (3.48, -0.40)
teb_icp | teb_icp_s7_011 | 0 | 1792046299.467 | 4709.344 | path_received | 4.8471 m
teb_icp | teb_icp_s7_011 | 0 | 1792046354.179 | 4760.276 | goal_reached_msg
teb_icp | teb_icp_s7_011 | 1 | 1792046356.184 | 4762.268 | goal_sent | gondola_1_west_b (0.15, 1.40)
teb_icp | teb_icp_s7_011 | 1 | 1792046362.191 | 4767.860 | goal_resent_no_path
teb_icp | teb_icp_s7_011 | 1 | 1792046362.405 | 4768.060 | path_received | 6.1849 m
teb_icp | teb_icp_s7_011 | 1 | 1792046437.015 | 4838.532 | controller_aborted
teb_icp | teb_icp_s7_011 | 1 | 1792046438.016 | 4839.460 | goal_resent | after controller abort
teb_icp | teb_icp_s7_011 | 1 | 1792046439.894 | 4841.308 | goal_reached_msg
teb_icp | teb_icp_s7_011 | 2 | 1792046441.897 | 4843.304 | goal_sent | gondola_2_west_b+gondola_1_east_b (1.80, 1.40)
teb_icp | teb_icp_s7_011 | 2 | 1792046445.089 | 4846.136 | path_received | 2.6056 m
teb_icp | teb_icp_s7_011 | 2 | 1792046479.189 | 4878.132 | controller_aborted
teb_icp | teb_icp_s7_011 | 2 | 1792046480.198 | 4879.068 | goal_resent | after controller abort
teb_icp | teb_icp_s7_011 | 2 | 1792046482.429 | 4881.168 | truth_gap | no Gazebo pose for 15 s (gz service); A1 samples blank
teb_icp | teb_icp_s7_011 | 2 | 1792046488.294 | 4886.672 | goal_reached_msg
teb_icp | teb_icp_s7_011 | 3 | 1792046490.299 | 4888.688 | goal_sent | gondola_2_west_a+gondola_1_east_a (1.80, -0.40)
teb_icp | teb_icp_s7_011 | 3 | 1792046492.343 | 4890.696 | path_received | 1.85 m
teb_icp | teb_icp_s7_011 | 3 | 1792046522.448 | 4919.000 | controller_aborted
teb_icp | teb_icp_s7_011 | 3 | 1792046523.449 | 4919.984 | goal_resent | after controller abort
teb_icp | teb_icp_s7_011 | 3 | 1792046527.103 | 4923.500 | goal_reached_msg
teb_icp | teb_icp_s7_011 | 4 | 1792046529.105 | 4925.340 | goal_sent | gondola_1_west_a (0.15, -0.40)
teb_icp | teb_icp_s7_011 | 4 | 1792046531.752 | 4927.932 | path_received | 2.7056 m
teb_icp | teb_icp_s7_011 | 4 | 1792046567.661 | 4961.688 | controller_aborted
teb_icp | teb_icp_s7_011 | 4 | 1792046568.670 | 4962.688 | goal_resent | after controller abort
teb_icp | teb_icp_s7_011 | 4 | 1792046574.738 | 4968.480 | goal_reached_msg
teb_icp | teb_icp_s7_011 | 5 | 1792046576.745 | 4970.448 | goal_sent | dairy (-2.20, 2.75)
teb_icp | teb_icp_s7_011 | 5 | 1792046582.751 | 4975.972 | goal_resent_no_path
teb_icp | teb_icp_s7_011 | 5 | 1792046583.613 | 4976.800 | path_received | 4.3284 m
teb_icp | teb_icp_s7_011 | 5 | 1792046611.969 | 5003.972 | truth_gap | no Gazebo pose for 15 s (gz service); A1 samples blank
teb_icp | teb_icp_s7_011 | 5 | 1792046635.529 | 5026.672 | goal_reached_msg
teb_icp | teb_icp_s7_011 | 6 | 1792046637.540 | 5028.676 | goal_sent | produce (-1.40, 0.05)
teb_icp | teb_icp_s7_011 | 6 | 1792046640.817 | 5031.608 | path_received | 3.1778 m
teb_icp | teb_icp_s7_011 | 6 | 1792046687.316 | 5075.544 | controller_aborted
teb_icp | teb_icp_s7_011 | 6 | 1792046688.319 | 5076.504 | goal_resent | after controller abort
teb_icp | teb_icp_s7_011 | 6 | 1792046696.176 | 5083.876 | goal_reached_msg
teb_icp | teb_icp_s7_011 | -1 | 1792046698.180 | 5085.868 | mission_end | 7/7 legs
teb_icp | teb_icp_s7_012 | -1 | 1792046698.181 | 5085.868 | mission_start | s7_r12_n5
teb_icp | teb_icp_s7_012 | -1 | 1792046698.181 | 5085.868 | goal_sent | home (0.00, 0.00)
teb_icp | teb_icp_s7_012 | -1 | 1792046699.051 | 5086.732 | path_received | 1.4207 m
teb_icp | teb_icp_s7_012 | -1 | 1792046711.364 | 5098.704 | goal_reached_msg
teb_icp | teb_icp_s7_012 | 0 | 1792046713.366 | 5100.704 | goal_sent | gondola_2_west_b+gondola_1_east_b (1.80, 1.40)
teb_icp | teb_icp_s7_012 | 0 | 1792046718.482 | 5105.356 | path_received | 4.1006 m
teb_icp | teb_icp_s7_012 | 0 | 1792046768.686 | 5153.560 | controller_aborted
teb_icp | teb_icp_s7_012 | 0 | 1792046769.687 | 5154.564 | goal_resent | after controller abort
teb_icp | teb_icp_s7_012 | 0 | 1792046777.542 | 5162.272 | goal_reached_msg
teb_icp | teb_icp_s7_012 | 1 | 1792046779.545 | 5164.168 | goal_sent | gondola_3_a+gondola_2_east_a (3.48, -0.40)
teb_icp | teb_icp_s7_012 | 1 | 1792046784.659 | 5168.936 | path_received | 4.4763 m
teb_icp | teb_icp_s7_012 | 1 | 1792046832.348 | 5215.228 | goal_reached_msg
teb_icp | teb_icp_s7_012 | 2 | 1792046834.352 | 5217.232 | goal_sent | gondola_1_west_a (0.15, -0.40)
teb_icp | teb_icp_s7_012 | 2 | 1792046837.752 | 5220.420 | path_received | 4.3849 m
teb_icp | teb_icp_s7_012 | 2 | 1792046893.557 | 5273.712 | goal_reached_msg
teb_icp | teb_icp_s7_012 | 3 | 1792046895.559 | 5275.684 | goal_sent | tea_coffee (-2.45, 0.40)
teb_icp | teb_icp_s7_012 | 3 | 1792046897.458 | 5277.576 | path_received | 2.9314 m
teb_icp | teb_icp_s7_012 | 3 | 1792046907.766 | 5287.620 | controller_aborted
teb_icp | teb_icp_s7_012 | 3 | 1792046908.776 | 5288.624 | goal_resent | after controller abort
teb_icp | teb_icp_s7_012 | 3 | 1792046928.914 | 5308.464 | truth_gap | no Gazebo pose for 15 s (gz service); A1 samples blank
teb_icp | teb_icp_s7_012 | 3 | 1792046940.614 | 5319.736 | goal_reached_msg
teb_icp | teb_icp_s7_012 | 4 | 1792046942.616 | 5321.600 | goal_sent | produce (-1.40, 0.05)
teb_icp | teb_icp_s7_012 | 4 | 1792046943.266 | 5322.248 | path_received | 1.195 m
teb_icp | teb_icp_s7_012 | 4 | 1792046964.079 | 5342.648 | controller_aborted
teb_icp | teb_icp_s7_012 | 4 | 1792046965.082 | 5343.652 | goal_resent | after controller abort
teb_icp | teb_icp_s7_012 | 4 | 1792046967.535 | 5346.108 | goal_reached_msg
teb_icp | teb_icp_s7_012 | -1 | 1792046969.543 | 5347.984 | mission_end | 5/5 legs
teb_icp | teb_icp_s7_013 | -1 | 1792046969.543 | 5347.984 | mission_start | s7_r13_n3
teb_icp | teb_icp_s7_013 | -1 | 1792046969.544 | 5347.984 | goal_sent | home (0.00, 0.00)
teb_icp | teb_icp_s7_013 | -1 | 1792046970.097 | 5348.536 | path_received | 1.4207 m
teb_icp | teb_icp_s7_013 | -1 | 1792046982.203 | 5360.480 | goal_reached_msg
teb_icp | teb_icp_s7_013 | 0 | 1792046984.204 | 5362.320 | goal_sent | gondola_2_west_b+gondola_1_east_b (1.80, 1.40)
teb_icp | teb_icp_s7_013 | 0 | 1792046989.203 | 5366.916 | path_received | 4.1006 m
teb_icp | teb_icp_s7_013 | 0 | 1792047039.399 | 5415.268 | controller_aborted
teb_icp | teb_icp_s7_013 | 0 | 1792047040.401 | 5416.268 | goal_resent | after controller abort
teb_icp | teb_icp_s7_013 | 0 | 1792047050.346 | 5425.852 | goal_reached_msg
teb_icp | teb_icp_s7_013 | 1 | 1792047052.352 | 5427.708 | goal_sent | gondola_1_west_a (0.15, -0.40)
teb_icp | teb_icp_s7_013 | 1 | 1792047055.137 | 5430.484 | path_received | 4.3349 m
teb_icp | teb_icp_s7_013 | 1 | 1792047110.656 | 5483.908 | goal_reached_msg
teb_icp | teb_icp_s7_013 | -1 | 1792047112.657 | 5485.688 | mission_end | 2/2 legs
teb_icp | teb_icp_s7_014 | -1 | 1792047112.658 | 5485.688 | mission_start | s7_r14_n11
teb_icp | teb_icp_s7_014 | -1 | 1792047112.658 | 5485.688 | goal_sent | home (0.00, 0.00)
teb_icp | teb_icp_s7_014 | -1 | 1792047113.057 | 5486.076 | path_received | 0.4621 m
teb_icp | teb_icp_s7_014 | -1 | 1792047123.454 | 5496.140 | controller_aborted
teb_icp | teb_icp_s7_014 | -1 | 1792047124.462 | 5497.148 | goal_resent | after controller abort
teb_icp | teb_icp_s7_014 | -1 | 1792047126.223 | 5498.888 | goal_reached_msg
teb_icp | teb_icp_s7_014 | 0 | 1792047128.229 | 5500.888 | goal_sent | gondola_3_a+gondola_2_east_a (3.48, -0.40)
teb_icp | teb_icp_s7_014 | 0 | 1792047133.366 | 5505.768 | path_received | 4.8471 m
teb_icp | teb_icp_s7_014 | 0 | 1792047186.681 | 5556.908 | goal_reached_msg
teb_icp | teb_icp_s7_014 | 1 | 1792047188.686 | 5558.772 | goal_sent | tea_coffee (-2.45, 0.40)
teb_icp | teb_icp_s7_014 | 1 | 1792047193.261 | 5563.340 | path_received | 7.1113 m
teb_icp | teb_icp_s7_014 | 1 | 1792047274.563 | 5640.848 | goal_reached_msg
teb_icp | teb_icp_s7_014 | 2 | 1792047276.570 | 5642.752 | goal_sent | gondola_3_b+gondola_2_east_b (3.48, 1.40)
teb_icp | teb_icp_s7_014 | 2 | 1792047281.441 | 5647.584 | path_received | 7.4406 m
teb_icp | teb_icp_s7_014 | 2 | 1792047359.849 | 5721.860 | goal_reached_msg
teb_icp | teb_icp_s7_014 | 3 | 1792047361.853 | 5723.836 | goal_sent | produce (-1.40, 0.05)
teb_icp | teb_icp_s7_014 | 3 | 1792047364.990 | 5726.968 | path_received | 6.4941 m
teb_icp | teb_icp_s7_014 | 3 | 1792047440.600 | 5800.692 | goal_reached_msg
teb_icp | teb_icp_s7_014 | 4 | 1792047442.601 | 5802.664 | goal_sent | dairy (-2.20, 2.75)
teb_icp | teb_icp_s7_014 | 4 | 1792047445.653 | 5805.708 | path_received | 3.1778 m
teb_icp | teb_icp_s7_014 | 4 | 1792047487.749 | 5845.920 | controller_aborted
teb_icp | teb_icp_s7_014 | 4 | 1792047488.751 | 5846.920 | goal_resent | after controller abort
teb_icp | teb_icp_s7_014 | 4 | 1792047493.946 | 5852.084 | goal_reached_msg
teb_icp | teb_icp_s7_014 | 5 | 1792047495.947 | 5853.888 | goal_sent | gondola_2_west_a+gondola_1_east_a (1.80, -0.40)
teb_icp | teb_icp_s7_014 | 5 | 1792047499.485 | 5857.244 | path_received | 6.4471 m
teb_icp | teb_icp_s7_014 | 5 | 1792047568.189 | 5923.256 | goal_reached_msg
teb_icp | teb_icp_s7_014 | 6 | 1792047570.191 | 5925.260 | goal_sent | gondola_1_west_b (0.15, 1.40)
teb_icp | teb_icp_s7_014 | 6 | 1792047573.629 | 5928.656 | path_received | 4.4056 m
teb_icp | teb_icp_s7_014 | 6 | 1792047627.929 | 5981.284 | goal_reached_msg
teb_icp | teb_icp_s7_014 | -1 | 1792047629.930 | 5983.288 | mission_end | 7/7 legs
teb_icp | teb_icp_s7_015 | -1 | 1792047629.930 | 5983.288 | mission_start | s7_r15_n4
teb_icp | teb_icp_s7_015 | -1 | 1792047629.930 | 5983.288 | goal_sent | home (0.00, 0.00)
teb_icp | teb_icp_s7_015 | -1 | 1792047631.026 | 5984.380 | path_received | 1.4621 m
teb_icp | teb_icp_s7_015 | -1 | 1792047652.025 | 6004.308 | goal_reached_msg
teb_icp | teb_icp_s7_015 | 0 | 1792047654.027 | 6006.316 | goal_sent | gondola_3_b+gondola_2_east_b (3.48, 1.40)
teb_icp | teb_icp_s7_015 | 0 | 1792047659.489 | 6011.748 | path_received | 5.8471 m
teb_icp | teb_icp_s7_015 | 0 | 1792047722.590 | 6072.908 | goal_reached_msg
teb_icp | teb_icp_s7_015 | 1 | 1792047724.592 | 6074.776 | goal_sent | gondola_1_west_a (0.15, -0.40)
teb_icp | teb_icp_s7_015 | 1 | 1792047728.850 | 6078.832 | path_received | 6.1849 m
teb_icp | teb_icp_s7_015 | 1 | 1792047744.148 | 6093.932 | truth_gap | no Gazebo pose for 15 s (gz service); A1 samples blank
teb_icp | teb_icp_s7_015 | 1 | 1792047799.732 | 6147.680 | truth_gap | no Gazebo pose for 15 s (gz service); A1 samples blank
teb_icp | teb_icp_s7_015 | 1 | 1792047800.162 | 6148.104 | controller_aborted
teb_icp | teb_icp_s7_015 | 1 | 1792047801.169 | 6149.008 | goal_resent | after controller abort
teb_icp | teb_icp_s7_015 | 1 | 1792047804.673 | 6152.284 | goal_reached_msg
teb_icp | teb_icp_s7_015 | 2 | 1792047806.675 | 6154.176 | goal_sent | dairy (-2.20, 2.75)
teb_icp | teb_icp_s7_015 | 2 | 1792047811.970 | 6159.200 | path_received | 4.3284 m
teb_icp | teb_icp_s7_015 | 2 | 1792047848.359 | 6194.556 | truth_gap | no Gazebo pose for 15 s (gz service); A1 samples blank
teb_icp | teb_icp_s7_015 | 2 | 1792047865.080 | 6210.508 | goal_reached_msg
teb_icp | teb_icp_s7_015 | 3 | 1792047867.093 | 6212.256 | goal_sent | tea_coffee (-2.45, 0.40)
teb_icp | teb_icp_s7_015 | 3 | 1792047869.501 | 6214.672 | path_received | 2.4828 m
teb_icp | teb_icp_s7_015 | 3 | 1792047903.708 | 6247.500 | controller_aborted
teb_icp | teb_icp_s7_015 | 3 | 1792047904.709 | 6248.484 | goal_resent | after controller abort
teb_icp | teb_icp_s7_015 | 3 | 1792047907.925 | 6251.692 | goal_reached_msg
teb_icp | teb_icp_s7_015 | -1 | 1792047909.926 | 6253.584 | mission_end | 4/4 legs
teb_icp | teb_icp_s7_016 | -1 | 1792047909.926 | 6253.584 | mission_start | s7_r16_n4
teb_icp | teb_icp_s7_016 | -1 | 1792047909.926 | 6253.584 | goal_sent | home (0.00, 0.00)
teb_icp | teb_icp_s7_016 | -1 | 1792047911.845 | 6255.372 | path_received | 2.6157 m
teb_icp | teb_icp_s7_016 | -1 | 1792047949.418 | 6291.312 | controller_aborted
teb_icp | teb_icp_s7_016 | -1 | 1792047950.420 | 6292.220 | goal_resent | after controller abort
teb_icp | teb_icp_s7_016 | -1 | 1792047953.519 | 6295.112 | goal_reached_msg
teb_icp | teb_icp_s7_016 | 0 | 1792047955.525 | 6297.000 | goal_sent | gondola_3_b+gondola_2_east_b (3.48, 1.40)
teb_icp | teb_icp_s7_016 | 0 | 1792047961.030 | 6302.272 | path_received | 5.8471 m
teb_icp | teb_icp_s7_016 | 0 | 1792047982.443 | 6323.384 | truth_gap | no Gazebo pose for 15 s (gz service); A1 samples blank
teb_icp | teb_icp_s7_016 | 0 | 1792048002.041 | 6342.620 | truth_gap | no Gazebo pose for 15 s (gz service); A1 samples blank
teb_icp | teb_icp_s7_016 | 0 | 1792048022.934 | 6363.036 | goal_reached_msg
teb_icp | teb_icp_s7_016 | 1 | 1792048024.942 | 6364.920 | goal_sent | gondola_3_a+gondola_2_east_a (3.48, -0.40)
teb_icp | teb_icp_s7_016 | 1 | 1792048026.585 | 6366.452 | path_received | 1.8 m
teb_icp | teb_icp_s7_016 | 1 | 1792048056.501 | 6394.880 | controller_aborted
teb_icp | teb_icp_s7_016 | 1 | 1792048057.508 | 6395.792 | goal_resent | after controller abort
teb_icp | teb_icp_s7_016 | 1 | 1792048059.930 | 6398.068 | goal_reached_msg
teb_icp | teb_icp_s7_016 | 2 | 1792048061.938 | 6399.972 | goal_sent | gondola_2_west_b+gondola_1_east_b (1.80, 1.40)
teb_icp | teb_icp_s7_016 | 2 | 1792048063.819 | 6401.852 | path_received | 4.4763 m
teb_icp | teb_icp_s7_016 | 2 | 1792048097.069 | 6434.608 | truth_gap | no Gazebo pose for 15 s (gz service); A1 samples blank
teb_icp | teb_icp_s7_016 | 2 | 1792048116.187 | 6453.532 | truth_gap | no Gazebo pose for 15 s (gz service); A1 samples blank
teb_icp | teb_icp_s7_016 | 2 | 1792048118.920 | 6456.240 | goal_reached_msg
teb_icp | teb_icp_s7_016 | -1 | 1792048120.933 | 6458.232 | mission_end | 3/3 legs
teb_icp | teb_icp_s7_017 | -1 | 1792048120.933 | 6458.232 | mission_start | s7_r17_n12
teb_icp | teb_icp_s7_017 | -1 | 1792048120.933 | 6458.232 | goal_sent | home (0.00, 0.00)
teb_icp | teb_icp_s7_017 | -1 | 1792048124.852 | 6462.152 | path_received | 4.0471 m
teb_icp | teb_icp_s7_017 | -1 | 1792048173.858 | 6509.836 | goal_reached_msg
teb_icp | teb_icp_s7_017 | 0 | 1792048175.861 | 6511.720 | goal_sent | gondola_2_west_b+gondola_1_east_b (1.80, 1.40)
teb_icp | teb_icp_s7_017 | 0 | 1792048179.606 | 6515.332 | path_received | 4.0678 m
teb_icp | teb_icp_s7_017 | 0 | 1792048229.299 | 6563.744 | controller_aborted
teb_icp | teb_icp_s7_017 | 0 | 1792048230.304 | 6564.748 | goal_resent | after controller abort
teb_icp | teb_icp_s7_017 | 0 | 1792048239.079 | 6573.288 | goal_reached_msg
teb_icp | teb_icp_s7_017 | 1 | 1792048241.085 | 6575.260 | goal_sent | gondola_3_b+gondola_2_east_b (3.48, 1.40)
teb_icp | teb_icp_s7_017 | 1 | 1792048242.896 | 6577.068 | path_received | 2.6471 m
teb_icp | teb_icp_s7_017 | 1 | 1792048271.211 | 6604.524 | goal_reached_msg
teb_icp | teb_icp_s7_017 | 2 | 1792048273.213 | 6606.332 | goal_sent | gondola_1_west_b (0.15, 1.40)
teb_icp | teb_icp_s7_017 | 2 | 1792048276.592 | 6609.684 | path_received | 4.3849 m
teb_icp | teb_icp_s7_017 | 2 | 1792048329.901 | 6660.640 | goal_reached_msg
teb_icp | teb_icp_s7_017 | 3 | 1792048331.907 | 6662.644 | goal_sent | dairy (-2.20, 2.75)
teb_icp | teb_icp_s7_017 | 3 | 1792048334.811 | 6665.544 | path_received | 2.9092 m
teb_icp | teb_icp_s7_017 | 3 | 1792048345.115 | 6675.580 | controller_aborted
teb_icp | teb_icp_s7_017 | 3 | 1792048346.119 | 6676.580 | goal_resent | after controller abort
teb_icp | teb_icp_s7_017 | 3 | 1792048377.891 | 6707.224 | goal_reached_msg
teb_icp | teb_icp_s7_017 | 4 | 1792048379.899 | 6709.228 | goal_sent | tea_coffee (-2.45, 0.40)
teb_icp | teb_icp_s7_017 | 4 | 1792048381.361 | 6710.588 | path_received | 2.4828 m
teb_icp | teb_icp_s7_017 | 4 | 1792048415.162 | 6743.736 | controller_aborted
teb_icp | teb_icp_s7_017 | 4 | 1792048416.162 | 6744.740 | goal_resent | after controller abort
teb_icp | teb_icp_s7_017 | 4 | 1792048419.145 | 6747.696 | goal_reached_msg
teb_icp | teb_icp_s7_017 | 5 | 1792048421.151 | 6749.700 | goal_sent | gondola_2_west_a+gondola_1_east_a (1.80, -0.40)
teb_icp | teb_icp_s7_017 | 5 | 1792048424.075 | 6752.600 | path_received | 5.432 m
teb_icp | teb_icp_s7_017 | 5 | 1792048480.189 | 6806.864 | goal_reached_msg
teb_icp | teb_icp_s7_017 | 6 | 1792048482.195 | 6808.872 | goal_sent | produce (-1.40, 0.05)
teb_icp | teb_icp_s7_017 | 6 | 1792048486.386 | 6812.800 | path_received | 4.237 m
teb_icp | teb_icp_s7_017 | 6 | 1792048519.066 | 6844.224 | truth_gap | no Gazebo pose for 15 s (gz service); A1 samples blank
teb_icp | teb_icp_s7_017 | 6 | 1792048540.897 | 6865.476 | goal_reached_msg
teb_icp | teb_icp_s7_017 | -1 | 1792048542.898 | 6867.288 | mission_end | 7/7 legs
teb_icp | teb_icp_s7_018 | -1 | 1792048542.898 | 6867.288 | mission_start | s7_r18_n12
teb_icp | teb_icp_s7_018 | -1 | 1792048542.899 | 6867.288 | goal_sent | home (0.00, 0.00)
teb_icp | teb_icp_s7_018 | -1 | 1792048544.136 | 6868.520 | path_received | 1.4207 m
teb_icp | teb_icp_s7_018 | -1 | 1792048555.836 | 6880.056 | goal_reached_msg
teb_icp | teb_icp_s7_018 | 0 | 1792048557.839 | 6882.064 | goal_sent | gondola_2_west_a+gondola_1_east_a (1.80, -0.40)
teb_icp | teb_icp_s7_018 | 0 | 1792048561.780 | 6885.864 | path_received | 3.3213 m
teb_icp | teb_icp_s7_018 | 0 | 1792048598.285 | 6920.648 | goal_reached_msg
teb_icp | teb_icp_s7_018 | 1 | 1792048600.286 | 6922.652 | goal_sent | tea_coffee (-2.45, 0.40)
teb_icp | teb_icp_s7_018 | 1 | 1792048605.017 | 6927.340 | path_received | 5.432 m
teb_icp | teb_icp_s7_018 | 1 | 1792048620.037 | 6942.208 | truth_gap | no Gazebo pose for 15 s (gz service); A1 samples blank
teb_icp | teb_icp_s7_018 | 1 | 1792048667.818 | 6988.248 | goal_reached_msg
teb_icp | teb_icp_s7_018 | 2 | 1792048669.827 | 6990.140 | goal_sent | gondola_3_b+gondola_2_east_b (3.48, 1.40)
teb_icp | teb_icp_s7_018 | 2 | 1792048675.318 | 6995.600 | path_received | 7.4406 m
teb_icp | teb_icp_s7_018 | 2 | 1792048726.450 | 7045.540 | truth_gap | no Gazebo pose for 15 s (gz service); A1 samples blank
teb_icp | teb_icp_s7_018 | 2 | 1792048751.524 | 7070.056 | goal_reached_msg
teb_icp | teb_icp_s7_018 | 3 | 1792048753.530 | 7072.064 | goal_sent | gondola_3_a+gondola_2_east_a (3.48, -0.40)
teb_icp | teb_icp_s7_018 | 3 | 1792048755.840 | 7074.272 | path_received | 1.8 m
teb_icp | teb_icp_s7_018 | 3 | 1792048784.835 | 7102.276 | controller_aborted
teb_icp | teb_icp_s7_018 | 3 | 1792048785.842 | 7103.136 | goal_resent | after controller abort
teb_icp | teb_icp_s7_018 | 3 | 1792048789.019 | 7106.112 | goal_reached_msg
teb_icp | teb_icp_s7_018 | 4 | 1792048791.024 | 7108.112 | goal_sent | gondola_2_west_b+gondola_1_east_b (1.80, 1.40)
teb_icp | teb_icp_s7_018 | 4 | 1792048794.703 | 7111.756 | path_received | 4.4763 m
teb_icp | teb_icp_s7_018 | 4 | 1792048851.708 | 7166.452 | goal_reached_msg
teb_icp | teb_icp_s7_018 | 5 | 1792048853.710 | 7168.264 | goal_sent | gondola_1_west_a (0.15, -0.40)
teb_icp | teb_icp_s7_018 | 5 | 1792048858.868 | 7173.040 | path_received | 4.3849 m
teb_icp | teb_icp_s7_018 | 5 | 1792048914.474 | 7226.864 | goal_reached_msg
teb_icp | teb_icp_s7_018 | 6 | 1792048916.480 | 7228.716 | goal_sent | dairy (-2.20, 2.75)
teb_icp | teb_icp_s7_018 | 6 | 1792048921.366 | 7233.292 | path_received | 4.3284 m
teb_icp | teb_icp_s7_018 | 6 | 1792048972.280 | 7282.652 | goal_reached_msg
teb_icp | teb_icp_s7_018 | 7 | 1792048974.285 | 7284.552 | goal_sent | produce (-1.40, 0.05)
teb_icp | teb_icp_s7_018 | 7 | 1792048976.954 | 7287.112 | path_received | 3.1778 m
teb_icp | teb_icp_s7_018 | 7 | 1792049022.359 | 7331.160 | controller_aborted
teb_icp | teb_icp_s7_018 | 7 | 1792049023.363 | 7332.168 | goal_resent | after controller abort
teb_icp | teb_icp_s7_018 | 7 | 1792049025.190 | 7333.856 | truth_gap | no Gazebo pose for 15 s (gz service); A1 samples blank
teb_icp | teb_icp_s7_018 | 7 | 1792049026.543 | 7335.104 | goal_reached_msg
teb_icp | teb_icp_s7_018 | -1 | 1792049028.553 | 7337.012 | mission_end | 8/8 legs
teb_icp | teb_icp_s7_019 | -1 | 1792049028.553 | 7337.012 | mission_start | s7_r19_n5
teb_icp | teb_icp_s7_019 | -1 | 1792049028.553 | 7337.012 | goal_sent | home (0.00, 0.00)
teb_icp | teb_icp_s7_019 | -1 | 1792049030.216 | 7338.564 | path_received | 1.4207 m
teb_icp | teb_icp_s7_019 | -1 | 1792049042.314 | 7350.476 | goal_reached_msg
teb_icp | teb_icp_s7_019 | 0 | 1792049044.322 | 7352.376 | goal_sent | gondola_1_west_b (0.15, 1.40)
teb_icp | teb_icp_s7_019 | 0 | 1792049046.463 | 7354.488 | path_received | 1.5157 m
teb_icp | teb_icp_s7_019 | 0 | 1792049065.273 | 7372.880 | goal_reached_msg
teb_icp | teb_icp_s7_019 | 1 | 1792049067.276 | 7374.656 | goal_sent | dairy (-2.20, 2.75)
teb_icp | teb_icp_s7_019 | 1 | 1792049070.822 | 7378.092 | path_received | 2.8592 m
teb_icp | teb_icp_s7_019 | 1 | 1792049086.710 | 7393.788 | truth_gap | no Gazebo pose for 15 s (gz service); A1 samples blank
teb_icp | teb_icp_s7_019 | 1 | 1792049112.625 | 7418.768 | controller_aborted
teb_icp | teb_icp_s7_019 | 1 | 1792049113.631 | 7419.752 | goal_resent | after controller abort
teb_icp | teb_icp_s7_019 | 1 | 1792049113.896 | 7420.016 | goal_reached_msg
teb_icp | teb_icp_s7_019 | 2 | 1792049115.896 | 7422.020 | goal_sent | gondola_3_b+gondola_2_east_b (3.48, 1.40)
teb_icp | teb_icp_s7_019 | 2 | 1792049120.886 | 7426.968 | path_received | 6.3849 m
teb_icp | teb_icp_s7_019 | 2 | 1792049188.585 | 7492.912 | goal_reached_msg
teb_icp | teb_icp_s7_019 | 3 | 1792049190.587 | 7494.912 | goal_sent | tea_coffee (-2.45, 0.40)
teb_icp | teb_icp_s7_019 | 3 | 1792049195.169 | 7499.452 | path_received | 7.4406 m
teb_icp | teb_icp_s7_019 | 3 | 1792049279.385 | 7580.912 | goal_reached_msg
teb_icp | teb_icp_s7_019 | -1 | 1792049281.390 | 7582.820 | mission_end | 4/4 legs
teb_icp | teb_icp_s7_020 | -1 | 1792049281.391 | 7582.820 | mission_start | s7_r20_n5
teb_icp | teb_icp_s7_020 | -1 | 1792049281.391 | 7582.820 | goal_sent | home (0.00, 0.00)
teb_icp | teb_icp_s7_020 | -1 | 1792049283.805 | 7585.012 | path_received | 2.6157 m
teb_icp | teb_icp_s7_020 | -1 | 1792049320.319 | 7620.484 | controller_aborted
teb_icp | teb_icp_s7_020 | -1 | 1792049321.320 | 7621.492 | goal_resent | after controller abort
teb_icp | teb_icp_s7_020 | -1 | 1792049324.349 | 7624.484 | goal_reached_msg
teb_icp | teb_icp_s7_020 | 0 | 1792049326.350 | 7626.492 | goal_sent | gondola_3_b+gondola_2_east_b (3.48, 1.40)
teb_icp | teb_icp_s7_020 | 0 | 1792049332.082 | 7631.944 | path_received | 5.8471 m
teb_icp | teb_icp_s7_020 | 0 | 1792049394.884 | 7692.420 | goal_reached_msg
teb_icp | teb_icp_s7_020 | 1 | 1792049396.885 | 7694.324 | goal_sent | produce (-1.40, 0.05)
teb_icp | teb_icp_s7_020 | 1 | 1792049402.020 | 7699.176 | path_received | 6.4941 m
teb_icp | teb_icp_s7_020 | 1 | 1792049424.821 | 7721.648 | truth_gap | no Gazebo pose for 15 s (gz service); A1 samples blank
teb_icp | teb_icp_s7_020 | 1 | 1792049471.663 | 7767.532 | truth_gap | no Gazebo pose for 15 s (gz service); A1 samples blank
teb_icp | teb_icp_s7_020 | 1 | 1792049476.949 | 7772.656 | goal_reached_msg
teb_icp | teb_icp_s7_020 | 2 | 1792049478.950 | 7774.668 | goal_sent | dairy (-2.20, 2.75)
teb_icp | teb_icp_s7_020 | 2 | 1792049482.843 | 7778.268 | path_received | 3.1778 m
teb_icp | teb_icp_s7_020 | 2 | 1792049502.583 | 7797.616 | truth_gap | no Gazebo pose for 15 s (gz service); A1 samples blank
teb_icp | teb_icp_s7_020 | 2 | 1792049527.938 | 7821.904 | goal_reached_msg
teb_icp | teb_icp_s7_020 | -1 | 1792049529.939 | 7823.788 | mission_end | 3/3 legs
teb_icp | teb_icp_s7_021 | -1 | 1792049529.939 | 7823.788 | mission_start | s7_r21_n9
teb_icp | teb_icp_s7_021 | -1 | 1792049529.939 | 7823.788 | goal_sent | home (0.00, 0.00)
teb_icp | teb_icp_s7_021 | -1 | 1792049531.680 | 7825.520 | path_received | 3.8663 m
teb_icp | teb_icp_s7_021 | -1 | 1792049571.873 | 7864.864 | goal_reached_msg
teb_icp | teb_icp_s7_021 | 0 | 1792049573.896 | 7866.868 | goal_sent | dairy (-2.20, 2.75)
teb_icp | teb_icp_s7_021 | 0 | 1792049577.756 | 7870.708 | path_received | 3.8663 m
teb_icp | teb_icp_s7_021 | 0 | 1792049626.358 | 7918.228 | goal_reached_msg
teb_icp | teb_icp_s7_021 | 1 | 1792049628.361 | 7920.232 | goal_sent | gondola_2_west_b+gondola_1_east_b (1.80, 1.40)
teb_icp | teb_icp_s7_021 | 1 | 1792049632.230 | 7924.064 | path_received | 4.6471 m
teb_icp | teb_icp_s7_021 | 1 | 1792049690.832 | 7980.628 | controller_aborted
teb_icp | teb_icp_s7_021 | 1 | 1792049691.836 | 7981.632 | goal_resent | after controller abort
teb_icp | teb_icp_s7_021 | 1 | 1792049702.411 | 7992.060 | controller_aborted
teb_icp | teb_icp_s7_021 | 1 | 1792049702.411 | 7992.060 | leg_failed | controller_aborted
teb_icp | teb_icp_s7_021 | 2 | 1792049704.414 | 7993.816 | goal_sent | gondola_3_a+gondola_2_east_a (3.48, -0.40)
teb_icp | teb_icp_s7_021 | 2 | 1792049708.010 | 7997.276 | path_received | 4.4763 m
teb_icp | teb_icp_s7_021 | 2 | 1792049758.315 | 8046.088 | goal_reached_msg
teb_icp | teb_icp_s7_021 | 3 | 1792049760.316 | 8047.944 | goal_sent | gondola_1_west_a (0.15, -0.40)
teb_icp | teb_icp_s7_021 | 3 | 1792049762.146 | 8049.760 | path_received | 4.3849 m
teb_icp | teb_icp_s7_021 | 3 | 1792049793.791 | 8080.784 | truth_gap | no Gazebo pose for 15 s (gz service); A1 samples blank
teb_icp | teb_icp_s7_021 | 3 | 1792049817.143 | 8103.464 | goal_reached_msg
teb_icp | teb_icp_s7_021 | 4 | 1792049819.144 | 8105.264 | goal_sent | gondola_1_west_b (0.15, 1.40)
teb_icp | teb_icp_s7_021 | 4 | 1792049820.856 | 8106.800 | path_received | 1.8 m
teb_icp | teb_icp_s7_021 | 4 | 1792049849.745 | 8134.704 | goal_reached_msg
teb_icp | teb_icp_s7_021 | 5 | 1792049851.748 | 8136.600 | goal_sent | tea_coffee (-2.45, 0.40)
teb_icp | teb_icp_s7_021 | 5 | 1792049854.895 | 8139.696 | path_received | 3.0556 m
teb_icp | teb_icp_s7_021 | 5 | 1792049893.428 | 8177.772 | truth_gap | no Gazebo pose for 15 s (gz service); A1 samples blank
teb_icp | teb_icp_s7_021 | 5 | 1792049895.091 | 8179.292 | goal_reached_msg
teb_icp | teb_icp_s7_021 | -1 | 1792049897.098 | 8181.200 | mission_end | 5/6 legs
teb_icp | teb_icp_s7_022 | -1 | 1792049897.099 | 8181.200 | mission_start | s7_r22_n6
teb_icp | teb_icp_s7_022 | -1 | 1792049897.099 | 8181.200 | goal_sent | home (0.00, 0.00)
teb_icp | teb_icp_s7_022 | -1 | 1792049898.982 | 8183.080 | path_received | 2.6157 m
teb_icp | teb_icp_s7_022 | -1 | 1792049935.888 | 8218.924 | controller_aborted
teb_icp | teb_icp_s7_022 | -1 | 1792049936.889 | 8219.924 | goal_resent | after controller abort
teb_icp | teb_icp_s7_022 | -1 | 1792049938.087 | 8221.116 | goal_reached_msg
teb_icp | teb_icp_s7_022 | 0 | 1792049940.092 | 8223.132 | goal_sent | gondola_2_west_a+gondola_1_east_a (1.80, -0.40)
teb_icp | teb_icp_s7_022 | 0 | 1792049942.905 | 8225.780 | path_received | 3.1678 m
teb_icp | teb_icp_s7_022 | 0 | 1792049978.404 | 8260.128 | goal_reached_msg
teb_icp | teb_icp_s7_022 | 1 | 1792049980.413 | 8262.028 | goal_sent | tea_coffee (-2.45, 0.40)
teb_icp | teb_icp_s7_022 | 1 | 1792049986.418 | 8267.672 | goal_resent_no_path
teb_icp | teb_icp_s7_022 | 1 | 1792049986.807 | 8268.056 | path_received | 5.432 m
teb_icp | teb_icp_s7_022 | 1 | 1792050049.912 | 8329.708 | goal_reached_msg
teb_icp | teb_icp_s7_022 | 2 | 1792050051.916 | 8331.476 | goal_sent | gondola_3_b+gondola_2_east_b (3.48, 1.40)
teb_icp | teb_icp_s7_022 | 2 | 1792050056.301 | 8335.856 | path_received | 7.4406 m
teb_icp | teb_icp_s7_022 | 2 | 1792050132.402 | 8409.840 | goal_reached_msg
teb_icp | teb_icp_s7_022 | 3 | 1792050134.406 | 8411.844 | goal_sent | gondola_3_a+gondola_2_east_a (3.48, -0.40)
teb_icp | teb_icp_s7_022 | 3 | 1792050134.930 | 8412.356 | path_received | 1.8 m
teb_icp | teb_icp_s7_022 | 3 | 1792050159.323 | 8436.188 | truth_gap | no Gazebo pose for 15 s (gz service); A1 samples blank
teb_icp | teb_icp_s7_022 | 3 | 1792050163.837 | 8440.692 | controller_aborted
teb_icp | teb_icp_s7_022 | 3 | 1792050164.838 | 8441.692 | goal_resent | after controller abort
teb_icp | teb_icp_s7_022 | 3 | 1792050167.657 | 8444.484 | goal_reached_msg
teb_icp | teb_icp_s7_022 | 4 | 1792050169.665 | 8446.488 | goal_sent | gondola_1_west_b (0.15, 1.40)
teb_icp | teb_icp_s7_022 | 4 | 1792050174.094 | 8450.876 | path_received | 6.1849 m
teb_icp | teb_icp_s7_022 | 4 | 1792050216.870 | 8492.876 | truth_gap | no Gazebo pose for 15 s (gz service); A1 samples blank
teb_icp | teb_icp_s7_022 | 4 | 1792050246.394 | 8521.500 | controller_aborted
teb_icp | teb_icp_s7_022 | 4 | 1792050247.395 | 8522.484 | goal_resent | after controller abort
teb_icp | teb_icp_s7_022 | 4 | 1792050250.026 | 8525.116 | goal_reached_msg
teb_icp | teb_icp_s7_022 | 5 | 1792050252.034 | 8527.120 | goal_sent | dairy (-2.20, 2.75)
teb_icp | teb_icp_s7_022 | 5 | 1792050254.535 | 8529.464 | path_received | 2.8885 m
teb_icp | teb_icp_s7_022 | 5 | 1792050295.841 | 8570.064 | controller_aborted
teb_icp | teb_icp_s7_022 | 5 | 1792050296.842 | 8571.064 | goal_resent | after controller abort
teb_icp | teb_icp_s7_022 | 5 | 1792050297.796 | 8572.016 | goal_reached_msg
teb_icp | teb_icp_s7_022 | -1 | 1792050299.800 | 8574.012 | mission_end | 6/6 legs
teb_icp | teb_icp_s7_023 | -1 | 1792050299.800 | 8574.012 | mission_start | s7_r23_n7
teb_icp | teb_icp_s7_023 | -1 | 1792050299.800 | 8574.012 | goal_sent | home (0.00, 0.00)
teb_icp | teb_icp_s7_023 | -1 | 1792050303.553 | 8577.744 | path_received | 3.8663 m
teb_icp | teb_icp_s7_023 | -1 | 1792050344.057 | 8617.284 | goal_reached_msg
teb_icp | teb_icp_s7_023 | 0 | 1792050346.061 | 8619.288 | goal_sent | gondola_2_west_a+gondola_1_east_a (1.80, -0.40)
teb_icp | teb_icp_s7_023 | 0 | 1792050348.814 | 8622.008 | path_received | 3.1678 m
teb_icp | teb_icp_s7_023 | 0 | 1792050363.893 | 8637.012 | truth_gap | no Gazebo pose for 15 s (gz service); A1 samples blank
teb_icp | teb_icp_s7_023 | 0 | 1792050383.119 | 8655.900 | goal_reached_msg
teb_icp | teb_icp_s7_023 | 1 | 1792050385.123 | 8657.900 | goal_sent | gondola_1_west_a (0.15, -0.40)
teb_icp | teb_icp_s7_023 | 1 | 1792050386.452 | 8659.232 | path_received | 2.7056 m
teb_icp | teb_icp_s7_023 | 1 | 1792050401.569 | 8674.248 | truth_gap | no Gazebo pose for 15 s (gz service); A1 samples blank
teb_icp | teb_icp_s7_023 | 1 | 1792050420.851 | 8693.348 | controller_aborted
teb_icp | teb_icp_s7_023 | 1 | 1792050421.852 | 8694.352 | goal_resent | after controller abort
teb_icp | teb_icp_s7_023 | 1 | 1792050426.217 | 8698.708 | goal_reached_msg
teb_icp | teb_icp_s7_023 | 2 | 1792050428.221 | 8700.688 | goal_sent | produce (-1.40, 0.05)
teb_icp | teb_icp_s7_023 | 2 | 1792050430.765 | 8703.128 | path_received | 1.7364 m
teb_icp | teb_icp_s7_023 | 2 | 1792050440.870 | 8713.172 | controller_aborted
teb_icp | teb_icp_s7_023 | 2 | 1792050441.877 | 8714.168 | goal_resent | after controller abort
teb_icp | teb_icp_s7_023 | 2 | 1792050459.001 | 8730.436 | goal_reached_msg
teb_icp | teb_icp_s7_023 | 3 | 1792050461.007 | 8732.436 | goal_sent | gondola_3_b+gondola_2_east_b (3.48, 1.40)
teb_icp | teb_icp_s7_023 | 3 | 1792050466.839 | 8738.136 | path_received | 6.4941 m
teb_icp | teb_icp_s7_023 | 3 | 1792050487.852 | 8758.720 | truth_gap | no Gazebo pose for 15 s (gz service); A1 samples blank
teb_icp | teb_icp_s7_023 | 3 | 1792050533.744 | 8803.108 | goal_reached_msg
teb_icp | teb_icp_s7_023 | 4 | 1792050535.745 | 8804.908 | goal_sent | dairy (-2.20, 2.75)
teb_icp | teb_icp_s7_023 | 4 | 1792050540.469 | 8809.476 | path_received | 6.3849 m
teb_icp | teb_icp_s7_023 | 4 | 1792050575.940 | 8844.352 | truth_gap | no Gazebo pose for 15 s (gz service); A1 samples blank
teb_icp | teb_icp_s7_023 | 4 | 1792050596.936 | 8865.000 | truth_gap | no Gazebo pose for 15 s (gz service); A1 samples blank
teb_icp | teb_icp_s7_023 | 4 | 1792050613.082 | 8880.664 | goal_reached_msg
teb_icp | teb_icp_s7_023 | 5 | 1792050615.087 | 8882.544 | goal_sent | gondola_3_a+gondola_2_east_a (3.48, -0.40)
teb_icp | teb_icp_s7_023 | 5 | 1792050621.095 | 8888.200 | goal_resent_no_path
teb_icp | teb_icp_s7_023 | 5 | 1792050621.255 | 8888.352 | path_received | 8.1849 m
teb_icp | teb_icp_s7_023 | 5 | 1792050677.495 | 8943.208 | truth_gap | no Gazebo pose for 15 s (gz service); A1 samples blank
teb_icp | teb_icp_s7_023 | 5 | 1792050706.852 | 8971.868 | goal_reached_msg
teb_icp | teb_icp_s7_023 | -1 | 1792050708.860 | 8973.776 | mission_end | 6/6 legs
teb_icp | teb_icp_s7_024 | -1 | 1792050708.860 | 8973.776 | mission_start | s7_r24_n8
teb_icp | teb_icp_s7_024 | -1 | 1792050708.860 | 8973.776 | goal_sent | home (0.00, 0.00)
teb_icp | teb_icp_s7_024 | -1 | 1792050711.292 | 8976.112 | path_received | 4.8471 m
teb_icp | teb_icp_s7_024 | -1 | 1792050727.382 | 8991.980 | truth_gap | no Gazebo pose for 15 s (gz service); A1 samples blank
teb_icp | teb_icp_s7_024 | -1 | 1792050770.992 | 9034.116 | goal_reached_msg
teb_icp | teb_icp_s7_024 | 0 | 1792050772.997 | 9036.108 | goal_sent | gondola_1_west_a (0.15, -0.40)
teb_icp | teb_icp_s7_024 | 0 | 1792050775.035 | 9038.124 | path_received | 0.4621 m
teb_icp | teb_icp_s7_024 | 0 | 1792050785.136 | 9048.196 | controller_aborted
teb_icp | teb_icp_s7_024 | 0 | 1792050786.141 | 9049.100 | goal_resent | after controller abort
teb_icp | teb_icp_s7_024 | 0 | 1792050791.997 | 9054.512 | goal_reached_msg
teb_icp | teb_icp_s7_024 | 1 | 1792050794.003 | 9056.472 | goal_sent | gondola_3_b+gondola_2_east_b (3.48, 1.40)
teb_icp | teb_icp_s7_024 | 1 | 1792050799.489 | 9061.968 | path_received | 6.1849 m
teb_icp | teb_icp_s7_024 | 1 | 1792050865.390 | 9125.908 | goal_reached_msg
teb_icp | teb_icp_s7_024 | 2 | 1792050867.391 | 9127.816 | goal_sent | dairy (-2.20, 2.75)
teb_icp | teb_icp_s7_024 | 2 | 1792050870.565 | 9130.932 | path_received | 6.3849 m
teb_icp | teb_icp_s7_024 | 2 | 1792050930.056 | 9188.840 | truth_gap | no Gazebo pose for 15 s (gz service); A1 samples blank
teb_icp | teb_icp_s7_024 | 2 | 1792050942.764 | 9201.488 | goal_reached_msg
teb_icp | teb_icp_s7_024 | 3 | 1792050944.765 | 9203.492 | goal_sent | gondola_2_west_a+gondola_1_east_a (1.80, -0.40)
teb_icp | teb_icp_s7_024 | 3 | 1792050948.550 | 9207.152 | path_received | 6.4471 m
teb_icp | teb_icp_s7_024 | 3 | 1792050964.015 | 9222.400 | truth_gap | no Gazebo pose for 15 s (gz service); A1 samples blank
teb_icp | teb_icp_s7_024 | 3 | 1792051017.363 | 9273.680 | goal_reached_msg
teb_icp | teb_icp_s7_024 | 4 | 1792051019.366 | 9275.664 | goal_sent | gondola_2_west_b+gondola_1_east_b (1.80, 1.40)
teb_icp | teb_icp_s7_024 | 4 | 1792051020.115 | 9276.408 | path_received | 1.8 m
teb_icp | teb_icp_s7_024 | 4 | 1792051049.426 | 9304.964 | controller_aborted
teb_icp | teb_icp_s7_024 | 4 | 1792051050.432 | 9305.972 | goal_resent | after controller abort
teb_icp | teb_icp_s7_024 | 4 | 1792051051.977 | 9307.488 | goal_reached_msg
teb_icp | teb_icp_s7_024 | 5 | 1792051053.981 | 9309.492 | goal_sent | gondola_1_west_b (0.15, 1.40)
teb_icp | teb_icp_s7_024 | 5 | 1792051055.639 | 9311.036 | path_received | 2.6056 m
teb_icp | teb_icp_s7_024 | 5 | 1792051091.340 | 9345.552 | controller_aborted
teb_icp | teb_icp_s7_024 | 5 | 1792051092.342 | 9346.536 | goal_resent | after controller abort
teb_icp | teb_icp_s7_024 | 5 | 1792051095.743 | 9349.920 | goal_reached_msg
teb_icp | teb_icp_s7_024 | -1 | 1792051097.747 | 9351.920 | mission_end | 6/6 legs
teb_icp | teb_icp_s7_025 | -1 | 1792051097.747 | 9351.920 | mission_start | s7_r25_n11
teb_icp | teb_icp_s7_025 | -1 | 1792051097.747 | 9351.920 | goal_sent | home (0.00, 0.00)
teb_icp | teb_icp_s7_025 | -1 | 1792051098.233 | 9352.400 | path_received | 1.4621 m
teb_icp | teb_icp_s7_025 | -1 | 1792051118.947 | 9372.636 | goal_reached_msg
teb_icp | teb_icp_s7_025 | 0 | 1792051120.948 | 9374.508 | goal_sent | dairy (-2.20, 2.75)
teb_icp | teb_icp_s7_025 | 0 | 1792051125.104 | 9378.664 | path_received | 3.8663 m
teb_icp | teb_icp_s7_025 | 0 | 1792051171.905 | 9424.088 | goal_reached_msg
teb_icp | teb_icp_s7_025 | 1 | 1792051173.909 | 9426.064 | goal_sent | tea_coffee (-2.45, 0.40)
teb_icp | teb_icp_s7_025 | 1 | 1792051176.547 | 9428.696 | path_received | 2.5036 m
teb_icp | teb_icp_s7_025 | 1 | 1792051191.584 | 9443.672 | truth_gap | no Gazebo pose for 15 s (gz service); A1 samples blank
teb_icp | teb_icp_s7_025 | 1 | 1792051210.149 | 9461.544 | controller_aborted
teb_icp | teb_icp_s7_025 | 1 | 1792051211.151 | 9462.548 | goal_resent | after controller abort
teb_icp | teb_icp_s7_025 | 1 | 1792051214.512 | 9465.880 | goal_reached_msg
teb_icp | teb_icp_s7_025 | 2 | 1792051216.513 | 9467.884 | goal_sent | produce (-1.40, 0.05)
teb_icp | teb_icp_s7_025 | 2 | 1792051216.882 | 9468.244 | path_received | 1.195 m
teb_icp | teb_icp_s7_025 | 2 | 1792051237.878 | 9488.752 | controller_aborted
teb_icp | teb_icp_s7_025 | 2 | 1792051238.881 | 9489.752 | goal_resent | after controller abort
teb_icp | teb_icp_s7_025 | 2 | 1792051241.444 | 9492.280 | goal_reached_msg
teb_icp | teb_icp_s7_025 | 3 | 1792051243.445 | 9494.280 | goal_sent | gondola_3_b+gondola_2_east_b (3.48, 1.40)
teb_icp | teb_icp_s7_025 | 3 | 1792051249.086 | 9499.768 | path_received | 6.4941 m
teb_icp | teb_icp_s7_025 | 3 | 1792051316.390 | 9564.676 | goal_reached_msg
teb_icp | teb_icp_s7_025 | 4 | 1792051318.396 | 9566.684 | goal_sent | gondola_2_west_a+gondola_1_east_a (1.80, -0.40)
teb_icp | teb_icp_s7_025 | 4 | 1792051321.531 | 9569.812 | path_received | 4.4763 m
teb_icp | teb_icp_s7_025 | 4 | 1792051367.944 | 9615.516 | truth_gap | no Gazebo pose for 15 s (gz service); A1 samples blank
teb_icp | teb_icp_s7_025 | 4 | 1792051377.931 | 9625.092 | goal_reached_msg
teb_icp | teb_icp_s7_025 | 5 | 1792051379.933 | 9627.100 | goal_sent | gondola_3_a+gondola_2_east_a (3.48, -0.40)
teb_icp | teb_icp_s7_025 | 5 | 1792051381.947 | 9629.104 | path_received | 2.7056 m
teb_icp | teb_icp_s7_025 | 5 | 1792051407.693 | 9654.372 | truth_gap | no Gazebo pose for 15 s (gz service); A1 samples blank
teb_icp | teb_icp_s7_025 | 5 | 1792051413.161 | 9659.480 | goal_reached_msg
teb_icp | teb_icp_s7_025 | 6 | 1792051415.165 | 9661.384 | goal_sent | gondola_1_west_a (0.15, -0.40)
teb_icp | teb_icp_s7_025 | 6 | 1792051418.030 | 9663.988 | path_received | 4.4349 m
teb_icp | teb_icp_s7_025 | 6 | 1792051461.221 | 9706.268 | truth_gap | no Gazebo pose for 15 s (gz service); A1 samples blank
teb_icp | teb_icp_s7_025 | 6 | 1792051473.337 | 9718.116 | goal_reached_msg
teb_icp | teb_icp_s7_025 | -1 | 1792051475.356 | 9720.124 | mission_end | 7/7 legs
teb_icp | teb_icp_s7_026 | -1 | 1792051475.356 | 9720.124 | mission_start | s7_r26_n6
teb_icp | teb_icp_s7_026 | -1 | 1792051475.356 | 9720.124 | goal_sent | home (0.00, 0.00)
teb_icp | teb_icp_s7_026 | -1 | 1792051477.292 | 9722.072 | path_received | 0.4621 m
teb_icp | teb_icp_s7_026 | -1 | 1792051487.502 | 9732.112 | controller_aborted
teb_icp | teb_icp_s7_026 | -1 | 1792051488.506 | 9733.120 | goal_resent | after controller abort
teb_icp | teb_icp_s7_026 | -1 | 1792051496.509 | 9741.088 | goal_reached_msg
teb_icp | teb_icp_s7_026 | 0 | 1792051498.511 | 9742.960 | goal_sent | gondola_1_west_b (0.15, 1.40)
teb_icp | teb_icp_s7_026 | 0 | 1792051500.268 | 9744.596 | path_received | 1.4621 m
teb_icp | teb_icp_s7_026 | 0 | 1792051520.673 | 9764.284 | goal_reached_msg
teb_icp | teb_icp_s7_026 | 1 | 1792051522.673 | 9766.092 | goal_sent | gondola_2_west_a+gondola_1_east_a (1.80, -0.40)
teb_icp | teb_icp_s7_026 | 1 | 1792051527.697 | 9771.068 | path_received | 4.4056 m
teb_icp | teb_icp_s7_026 | 1 | 1792051582.500 | 9824.516 | controller_aborted
teb_icp | teb_icp_s7_026 | 1 | 1792051583.507 | 9825.524 | goal_resent | after controller abort
teb_icp | teb_icp_s7_026 | 1 | 1792051587.696 | 9829.676 | goal_reached_msg
teb_icp | teb_icp_s7_026 | 2 | 1792051589.701 | 9831.576 | goal_sent | gondola_3_a+gondola_2_east_a (3.48, -0.40)
teb_icp | teb_icp_s7_026 | 2 | 1792051591.455 | 9833.208 | path_received | 2.7056 m
teb_icp | teb_icp_s7_026 | 2 | 1792051611.191 | 9852.636 | truth_gap | no Gazebo pose for 15 s (gz service); A1 samples blank
teb_icp | teb_icp_s7_026 | 2 | 1792051620.458 | 9861.832 | goal_reached_msg
teb_icp | teb_icp_s7_026 | 3 | 1792051622.467 | 9863.836 | goal_sent | gondola_3_b+gondola_2_east_b (3.48, 1.40)
teb_icp | teb_icp_s7_026 | 3 | 1792051623.021 | 9864.388 | path_received | 1.8 m
teb_icp | teb_icp_s7_026 | 3 | 1792051649.354 | 9889.428 | goal_reached_msg
teb_icp | teb_icp_s7_026 | -1 | 1792051651.364 | 9891.360 | mission_end | 4/4 legs
teb_icp | teb_icp_s7_027 | -1 | 1792051651.364 | 9891.360 | mission_start | s7_r27_n4
teb_icp | teb_icp_s7_027 | -1 | 1792051651.365 | 9891.360 | goal_sent | home (0.00, 0.00)
teb_icp | teb_icp_s7_027 | -1 | 1792051654.590 | 9894.540 | path_received | 5.8471 m
teb_icp | teb_icp_s7_027 | -1 | 1792051715.741 | 9954.192 | truth_gap | no Gazebo pose for 15 s (gz service); A1 samples blank
teb_icp | teb_icp_s7_027 | -1 | 1792051721.990 | 9960.320 | controller_aborted
teb_icp | teb_icp_s7_027 | -1 | 1792051722.993 | 9961.312 | goal_resent | after controller abort
teb_icp | teb_icp_s7_027 | -1 | 1792051726.592 | 9964.916 | goal_reached_msg
teb_icp | teb_icp_s7_027 | 0 | 1792051728.593 | 9966.896 | goal_sent | gondola_2_west_a+gondola_1_east_a (1.80, -0.40)
teb_icp | teb_icp_s7_027 | 0 | 1792051732.047 | 9970.088 | path_received | 3.1678 m
teb_icp | teb_icp_s7_027 | 0 | 1792051767.548 | 10004.496 | goal_reached_msg
teb_icp | teb_icp_s7_027 | 1 | 1792051769.553 | 10006.388 | goal_sent | gondola_3_a+gondola_2_east_a (3.48, -0.40)
teb_icp | teb_icp_s7_027 | 1 | 1792051772.715 | 10009.308 | path_received | 2.7056 m
teb_icp | teb_icp_s7_027 | 1 | 1792051789.440 | 10025.852 | truth_gap | no Gazebo pose for 15 s (gz service); A1 samples blank
teb_icp | teb_icp_s7_027 | 1 | 1792051801.710 | 10038.028 | goal_reached_msg
teb_icp | teb_icp_s7_027 | 2 | 1792051803.714 | 10040.020 | goal_sent | gondola_1_west_a (0.15, -0.40)
teb_icp | teb_icp_s7_027 | 2 | 1792051807.502 | 10043.800 | path_received | 4.3849 m
teb_icp | teb_icp_s7_027 | 2 | 1792051862.708 | 10097.688 | goal_reached_msg
teb_icp | teb_icp_s7_027 | 3 | 1792051864.714 | 10099.664 | goal_sent | gondola_3_b+gondola_2_east_b (3.48, 1.40)
teb_icp | teb_icp_s7_027 | 3 | 1792051868.984 | 10103.932 | path_received | 6.1849 m
teb_icp | teb_icp_s7_027 | 3 | 1792051924.472 | 10157.948 | truth_gap | no Gazebo pose for 15 s (gz service); A1 samples blank
teb_icp | teb_icp_s7_027 | 3 | 1792051937.993 | 10171.268 | goal_reached_msg
teb_icp | teb_icp_s7_027 | -1 | 1792051939.994 | 10173.048 | mission_end | 4/4 legs
teb_icp | teb_icp_s7_028 | -1 | 1792051939.994 | 10173.048 | mission_start | s7_r28_n4
teb_icp | teb_icp_s7_028 | -1 | 1792051939.994 | 10173.048 | goal_sent | home (0.00, 0.00)
teb_icp | teb_icp_s7_028 | -1 | 1792051943.625 | 10176.668 | path_received | 5.8471 m
teb_icp | teb_icp_s7_028 | -1 | 1792051987.394 | 10219.664 | truth_gap | no Gazebo pose for 15 s (gz service); A1 samples blank
teb_icp | teb_icp_s7_028 | -1 | 1792052013.731 | 10245.680 | goal_reached_msg
teb_icp | teb_icp_s7_028 | 0 | 1792052015.734 | 10247.680 | goal_sent | dairy (-2.20, 2.75)
teb_icp | teb_icp_s7_028 | 0 | 1792052018.734 | 10250.648 | path_received | 3.8663 m
teb_icp | teb_icp_s7_028 | 0 | 1792052033.797 | 10265.520 | truth_gap | no Gazebo pose for 15 s (gz service); A1 samples blank
teb_icp | teb_icp_s7_028 | 0 | 1792052068.239 | 10298.896 | goal_reached_msg
teb_icp | teb_icp_s7_028 | 1 | 1792052070.243 | 10300.796 | goal_sent | gondola_2_west_a+gondola_1_east_a (1.80, -0.40)
teb_icp | teb_icp_s7_028 | 1 | 1792052074.535 | 10305.044 | path_received | 6.4471 m
teb_icp | teb_icp_s7_028 | 1 | 1792052093.926 | 10324.200 | truth_gap | no Gazebo pose for 15 s (gz service); A1 samples blank
teb_icp | teb_icp_s7_028 | 1 | 1792052142.443 | 10371.636 | goal_reached_msg
teb_icp | teb_icp_s7_028 | 2 | 1792052144.447 | 10373.544 | goal_sent | gondola_1_west_a (0.15, -0.40)
teb_icp | teb_icp_s7_028 | 2 | 1792052146.052 | 10375.144 | path_received | 2.7056 m
teb_icp | teb_icp_s7_028 | 2 | 1792052180.951 | 10408.916 | controller_aborted
teb_icp | teb_icp_s7_028 | 2 | 1792052181.955 | 10409.784 | goal_resent | after controller abort
teb_icp | teb_icp_s7_028 | 2 | 1792052182.904 | 10410.708 | goal_reached_msg
teb_icp | teb_icp_s7_028 | -1 | 1792052184.905 | 10412.512 | mission_end | 3/3 legs
teb_icp | teb_icp_s7_029 | -1 | 1792052184.905 | 10412.512 | mission_start | s7_r29_n6
teb_icp | teb_icp_s7_029 | -1 | 1792052184.906 | 10412.512 | goal_sent | home (0.00, 0.00)
teb_icp | teb_icp_s7_029 | -1 | 1792052186.595 | 10414.088 | path_received | 0.4621 m
teb_icp | teb_icp_s7_029 | -1 | 1792052196.789 | 10424.092 | controller_aborted
teb_icp | teb_icp_s7_029 | -1 | 1792052197.790 | 10425.092 | goal_resent | after controller abort
teb_icp | teb_icp_s7_029 | -1 | 1792052204.010 | 10431.280 | goal_reached_msg
teb_icp | teb_icp_s7_029 | 0 | 1792052206.015 | 10433.284 | goal_sent | gondola_2_west_a+gondola_1_east_a (1.80, -0.40)
teb_icp | teb_icp_s7_029 | 0 | 1792052208.580 | 10435.816 | path_received | 3.1678 m
teb_icp | teb_icp_s7_029 | 0 | 1792052228.590 | 10455.516 | truth_gap | no Gazebo pose for 15 s (gz service); A1 samples blank
teb_icp | teb_icp_s7_029 | 0 | 1792052243.083 | 10469.460 | goal_reached_msg
teb_icp | teb_icp_s7_029 | 1 | 1792052245.084 | 10471.468 | goal_sent | dairy (-2.20, 2.75)
teb_icp | teb_icp_s7_029 | 1 | 1792052249.420 | 10475.752 | path_received | 6.4471 m
teb_icp | teb_icp_s7_029 | 1 | 1792052287.757 | 10513.328 | truth_gap | no Gazebo pose for 15 s (gz service); A1 samples blank
teb_icp | teb_icp_s7_029 | 1 | 1792052322.425 | 10547.304 | goal_reached_msg
teb_icp | teb_icp_s7_029 | 2 | 1792052324.432 | 10549.284 | goal_sent | gondola_1_west_a (0.15, -0.40)
teb_icp | teb_icp_s7_029 | 2 | 1792052327.155 | 10551.996 | path_received | 4.3284 m
teb_icp | teb_icp_s7_029 | 2 | 1792052350.768 | 10575.248 | truth_gap | no Gazebo pose for 15 s (gz service); A1 samples blank
teb_icp | teb_icp_s7_029 | 2 | 1792052380.046 | 10603.740 | controller_aborted
teb_icp | teb_icp_s7_029 | 2 | 1792052381.050 | 10604.744 | goal_resent | after controller abort
teb_icp | teb_icp_s7_029 | 2 | 1792052383.017 | 10606.664 | goal_reached_msg
teb_icp | teb_icp_s7_029 | 3 | 1792052385.032 | 10608.460 | goal_sent | gondola_3_b+gondola_2_east_b (3.48, 1.40)
teb_icp | teb_icp_s7_029 | 3 | 1792052390.506 | 10613.904 | path_received | 6.1849 m
teb_icp | teb_icp_s7_029 | 3 | 1792052457.121 | 10678.024 | goal_reached_msg
teb_icp | teb_icp_s7_029 | -1 | 1792052459.122 | 10680.000 | mission_end | 4/4 legs
teb_icp_pairs | teb_icp_pairs_s5_000 | -1 | 1792064900.924 | 22954.708 | mission_start | pair00
teb_icp_pairs | teb_icp_pairs_s5_000 | -1 | 1792064900.927 | 22954.708 | goal_sent | gondola_1_west_a (0.15, -0.40)
teb_icp_pairs | teb_icp_pairs_s5_000 | -1 | 1792064905.418 | 22963.072 | path_received | 6.1849 m
teb_icp_pairs | teb_icp_pairs_s5_000 | -1 | 1792064920.538 | 22978.024 | truth_gap | no Gazebo pose for 15 s (gz service); A1 samples blank
teb_icp_pairs | teb_icp_pairs_s5_000 | -1 | 1792064976.418 | 23032.652 | controller_aborted
teb_icp_pairs | teb_icp_pairs_s5_000 | -1 | 1792064977.425 | 23033.644 | goal_resent | after controller abort
teb_icp_pairs | teb_icp_pairs_s5_000 | -1 | 1792064981.497 | 23037.296 | goal_reached_msg
teb_icp_pairs | teb_icp_pairs_s5_000 | 0 | 1792064983.498 | 23039.208 | goal_sent | gondola_3_a+gondola_2_east_a (3.48, -0.40)
teb_icp_pairs | teb_icp_pairs_s5_000 | 0 | 1792064988.108 | 23043.632 | path_received | 4.3849 m
teb_icp_pairs | teb_icp_pairs_s5_000 | 0 | 1792065035.218 | 23089.052 | goal_reached_msg
teb_icp_pairs | teb_icp_pairs_s5_000 | -1 | 1792065037.224 | 23091.060 | mission_end | 1/1 legs
teb_icp_pairs | teb_icp_pairs_s5_001 | -1 | 1792065037.224 | 23091.060 | mission_start | pair01
teb_icp_pairs | teb_icp_pairs_s5_001 | -1 | 1792065037.225 | 23091.060 | goal_sent | tea_coffee (-2.45, 0.40)
teb_icp_pairs | teb_icp_pairs_s5_001 | -1 | 1792065042.368 | 23096.036 | path_received | 7.1113 m
teb_icp_pairs | teb_icp_pairs_s5_001 | -1 | 1792065063.325 | 23116.732 | truth_gap | no Gazebo pose for 15 s (gz service); A1 samples blank
teb_icp_pairs | teb_icp_pairs_s5_001 | -1 | 1792065093.687 | 23146.512 | truth_gap | no Gazebo pose for 15 s (gz service); A1 samples blank
teb_icp_pairs | teb_icp_pairs_s5_001 | -1 | 1792065121.664 | 23173.660 | goal_reached_msg
teb_icp_pairs | teb_icp_pairs_s5_001 | 0 | 1792065123.668 | 23175.652 | goal_sent | gondola_3_a+gondola_2_east_a (3.48, -0.40)
teb_icp_pairs | teb_icp_pairs_s5_001 | 0 | 1792065127.932 | 23179.904 | path_received | 7.1113 m
teb_icp_pairs | teb_icp_pairs_s5_001 | 0 | 1792065150.161 | 23201.636 | truth_gap | no Gazebo pose for 15 s (gz service); A1 samples blank
teb_icp_pairs | teb_icp_pairs_s5_001 | 0 | 1792065191.688 | 23241.808 | truth_gap | no Gazebo pose for 15 s (gz service); A1 samples blank
teb_icp_pairs | teb_icp_pairs_s5_001 | 0 | 1792065200.849 | 23250.872 | goal_reached_msg
teb_icp_pairs | teb_icp_pairs_s5_001 | -1 | 1792065202.868 | 23252.856 | mission_end | 1/1 legs
teb_icp_pairs | teb_icp_pairs_s5_002 | -1 | 1792065202.868 | 23252.856 | mission_start | pair02
teb_icp_pairs | teb_icp_pairs_s5_002 | -1 | 1792065202.869 | 23252.856 | goal_sent | produce (-1.40, 0.05)
teb_icp_pairs | teb_icp_pairs_s5_002 | -1 | 1792065207.738 | 23257.608 | path_received | 5.9163 m
teb_icp_pairs | teb_icp_pairs_s5_002 | -1 | 1792065229.117 | 23278.256 | truth_gap | no Gazebo pose for 15 s (gz service); A1 samples blank
teb_icp_pairs | teb_icp_pairs_s5_002 | -1 | 1792065277.442 | 23324.092 | goal_reached_msg
teb_icp_pairs | teb_icp_pairs_s5_002 | 0 | 1792065279.451 | 23326.052 | goal_sent | dairy (-2.20, 2.75)
teb_icp_pairs | teb_icp_pairs_s5_002 | 0 | 1792065284.358 | 23330.652 | path_received | 3.1778 m
teb_icp_pairs | teb_icp_pairs_s5_002 | 0 | 1792065325.870 | 23370.940 | controller_aborted
teb_icp_pairs | teb_icp_pairs_s5_002 | 0 | 1792065326.870 | 23371.876 | goal_resent | after controller abort
teb_icp_pairs | teb_icp_pairs_s5_002 | 0 | 1792065332.584 | 23377.288 | goal_reached_msg
teb_icp_pairs | teb_icp_pairs_s5_002 | -1 | 1792065334.588 | 23379.248 | mission_end | 1/1 legs
teb_icp_pairs | teb_icp_pairs_s5_003 | -1 | 1792065334.588 | 23379.248 | mission_start | pair03
teb_icp_pairs | teb_icp_pairs_s5_003 | -1 | 1792065334.589 | 23379.248 | goal_sent | tea_coffee (-2.45, 0.40)
teb_icp_pairs | teb_icp_pairs_s5_003 | -1 | 1792065336.190 | 23380.828 | path_received | 2.4536 m
teb_icp_pairs | teb_icp_pairs_s5_003 | -1 | 1792065361.865 | 23405.800 | truth_gap | no Gazebo pose for 15 s (gz service); A1 samples blank
teb_icp_pairs | teb_icp_pairs_s5_003 | -1 | 1792065370.170 | 23413.920 | controller_aborted
teb_icp_pairs | teb_icp_pairs_s5_003 | -1 | 1792065371.173 | 23414.924 | goal_resent | after controller abort
teb_icp_pairs | teb_icp_pairs_s5_003 | -1 | 1792065373.067 | 23416.692 | goal_reached_msg
teb_icp_pairs | teb_icp_pairs_s5_003 | 0 | 1792065375.070 | 23418.656 | goal_sent | gondola_1_west_a (0.15, -0.40)
teb_icp_pairs | teb_icp_pairs_s5_003 | 0 | 1792065378.151 | 23421.708 | path_received | 2.9314 m
teb_icp_pairs | teb_icp_pairs_s5_003 | 0 | 1792065415.456 | 23457.544 | controller_aborted
teb_icp_pairs | teb_icp_pairs_s5_003 | 0 | 1792065416.465 | 23458.496 | goal_resent | after controller abort
teb_icp_pairs | teb_icp_pairs_s5_003 | 0 | 1792065423.793 | 23465.680 | goal_reached_msg
teb_icp_pairs | teb_icp_pairs_s5_003 | -1 | 1792065425.799 | 23467.688 | mission_end | 1/1 legs
teb_icp_pairs | teb_icp_pairs_s5_004 | -1 | 1792065425.800 | 23467.688 | mission_start | pair04
teb_icp_pairs | teb_icp_pairs_s5_004 | -1 | 1792065425.800 | 23467.688 | goal_sent | gondola_1_west_a (0.15, -0.40)
teb_icp_pairs | teb_icp_pairs_s5_004 | -1 | 1792065426.125 | 23468.012 | path_received | 0 m
teb_icp_pairs | teb_icp_pairs_s5_004 | -1 | 1792065426.137 | 23468.024 | goal_reached_msg
teb_icp_pairs | teb_icp_pairs_s5_004 | 0 | 1792065428.138 | 23470.020 | goal_sent | gondola_2_west_b+gondola_1_east_b (1.80, 1.40)
teb_icp_pairs | teb_icp_pairs_s5_004 | 0 | 1792065434.139 | 23475.864 | goal_resent_no_path
teb_icp_pairs | teb_icp_pairs_s5_004 | 0 | 1792065434.283 | 23476.004 | path_received | 4.4056 m
teb_icp_pairs | teb_icp_pairs_s5_004 | 0 | 1792065489.990 | 23529.384 | controller_aborted
teb_icp_pairs | teb_icp_pairs_s5_004 | 0 | 1792065490.995 | 23530.244 | goal_resent | after controller abort
teb_icp_pairs | teb_icp_pairs_s5_004 | 0 | 1792065499.108 | 23538.132 | goal_reached_msg
teb_icp_pairs | teb_icp_pairs_s5_004 | -1 | 1792065501.112 | 23540.144 | mission_end | 1/1 legs
teb_icp_pairs | teb_icp_pairs_s5_005 | -1 | 1792065501.112 | 23540.144 | mission_start | pair05
teb_icp_pairs | teb_icp_pairs_s5_005 | -1 | 1792065501.112 | 23540.144 | goal_sent | gondola_3_b+gondola_2_east_b (3.48, 1.40)
teb_icp_pairs | teb_icp_pairs_s5_005 | -1 | 1792065504.164 | 23543.164 | path_received | 2.6263 m
teb_icp_pairs | teb_icp_pairs_s5_005 | -1 | 1792065532.371 | 23570.496 | goal_reached_msg
teb_icp_pairs | teb_icp_pairs_s5_005 | 0 | 1792065534.377 | 23572.496 | goal_sent | gondola_1_west_a (0.15, -0.40)
teb_icp_pairs | teb_icp_pairs_s5_005 | 0 | 1792065539.132 | 23577.172 | path_received | 6.1849 m
teb_icp_pairs | teb_icp_pairs_s5_005 | 0 | 1792065561.602 | 23599.152 | truth_gap | no Gazebo pose for 15 s (gz service); A1 samples blank
teb_icp_pairs | teb_icp_pairs_s5_005 | 0 | 1792065611.440 | 23646.848 | controller_aborted
teb_icp_pairs | teb_icp_pairs_s5_005 | 0 | 1792065612.447 | 23647.744 | goal_resent | after controller abort
teb_icp_pairs | teb_icp_pairs_s5_005 | 0 | 1792065614.626 | 23649.872 | goal_reached_msg
teb_icp_pairs | teb_icp_pairs_s5_005 | -1 | 1792065616.630 | 23651.880 | mission_end | 1/1 legs
teb_icp_pairs | teb_icp_pairs_s5_006 | -1 | 1792065616.630 | 23651.880 | mission_start | pair06
teb_icp_pairs | teb_icp_pairs_s5_006 | -1 | 1792065616.630 | 23651.880 | goal_sent | gondola_2_west_b+gondola_1_east_b (1.80, 1.40)
teb_icp_pairs | teb_icp_pairs_s5_006 | -1 | 1792065620.636 | 23655.716 | path_received | 4.4056 m
teb_icp_pairs | teb_icp_pairs_s5_006 | -1 | 1792065636.820 | 23671.640 | truth_gap | no Gazebo pose for 15 s (gz service); A1 samples blank
teb_icp_pairs | teb_icp_pairs_s5_006 | -1 | 1792065675.661 | 23709.244 | truth_gap | no Gazebo pose for 15 s (gz service); A1 samples blank
teb_icp_pairs | teb_icp_pairs_s5_006 | -1 | 1792065676.159 | 23709.736 | controller_aborted
teb_icp_pairs | teb_icp_pairs_s5_006 | -1 | 1792065677.160 | 23710.664 | goal_resent | after controller abort
teb_icp_pairs | teb_icp_pairs_s5_006 | -1 | 1792065682.646 | 23716.064 | goal_reached_msg
teb_icp_pairs | teb_icp_pairs_s5_006 | 0 | 1792065684.654 | 23718.080 | goal_sent | gondola_3_a+gondola_2_east_a (3.48, -0.40)
teb_icp_pairs | teb_icp_pairs_s5_006 | 0 | 1792065689.849 | 23723.084 | path_received | 4.4763 m
teb_icp_pairs | teb_icp_pairs_s5_006 | 0 | 1792065723.760 | 23756.028 | truth_gap | no Gazebo pose for 15 s (gz service); A1 samples blank
teb_icp_pairs | teb_icp_pairs_s5_006 | 0 | 1792065737.358 | 23769.116 | goal_reached_msg
teb_icp_pairs | teb_icp_pairs_s5_006 | -1 | 1792065739.359 | 23771.128 | mission_end | 1/1 legs
teb_icp_pairs | teb_icp_pairs_s5_007 | -1 | 1792065739.360 | 23771.128 | mission_start | pair07
teb_icp_pairs | teb_icp_pairs_s5_007 | -1 | 1792065739.360 | 23771.128 | goal_sent | dairy (-2.20, 2.75)
teb_icp_pairs | teb_icp_pairs_s5_007 | -1 | 1792065744.503 | 23776.220 | path_received | 8.1849 m
teb_icp_pairs | teb_icp_pairs_s5_007 | -1 | 1792065765.732 | 23797.084 | truth_gap | no Gazebo pose for 15 s (gz service); A1 samples blank
teb_icp_pairs | teb_icp_pairs_s5_007 | -1 | 1792065837.118 | 23865.848 | goal_reached_msg
teb_icp_pairs | teb_icp_pairs_s5_007 | 0 | 1792065839.121 | 23867.820 | goal_sent | gondola_1_west_a (0.15, -0.40)
teb_icp_pairs | teb_icp_pairs_s5_007 | 0 | 1792065841.570 | 23870.264 | path_received | 4.3784 m
teb_icp_pairs | teb_icp_pairs_s5_007 | 0 | 1792065882.574 | 23910.192 | truth_gap | no Gazebo pose for 15 s (gz service); A1 samples blank
teb_icp_pairs | teb_icp_pairs_s5_007 | 0 | 1792065894.368 | 23921.708 | controller_aborted
teb_icp_pairs | teb_icp_pairs_s5_007 | 0 | 1792065895.370 | 23922.708 | goal_resent | after controller abort
teb_icp_pairs | teb_icp_pairs_s5_007 | 0 | 1792065897.476 | 23924.720 | goal_reached_msg
teb_icp_pairs | teb_icp_pairs_s5_007 | -1 | 1792065899.478 | 23926.680 | mission_end | 1/1 legs
teb_icp_pairs | teb_icp_pairs_s5_008 | -1 | 1792065899.478 | 23926.680 | mission_start | pair08
teb_icp_pairs | teb_icp_pairs_s5_008 | -1 | 1792065899.478 | 23926.680 | goal_sent | gondola_3_a+gondola_2_east_a (3.48, -0.40)
teb_icp_pairs | teb_icp_pairs_s5_008 | -1 | 1792065904.397 | 23931.564 | path_received | 4.3849 m
teb_icp_pairs | teb_icp_pairs_s5_008 | -1 | 1792065951.418 | 23977.240 | goal_reached_msg
teb_icp_pairs | teb_icp_pairs_s5_008 | 0 | 1792065953.420 | 23979.064 | goal_sent | home (0.00, 0.00)
teb_icp_pairs | teb_icp_pairs_s5_008 | 0 | 1792065956.969 | 23982.472 | path_received | 4.8471 m
teb_icp_pairs | teb_icp_pairs_s5_008 | 0 | 1792065989.006 | 24013.704 | truth_gap | no Gazebo pose for 15 s (gz service); A1 samples blank
teb_icp_pairs | teb_icp_pairs_s5_008 | 0 | 1792066017.572 | 24041.032 | goal_reached_msg
teb_icp_pairs | teb_icp_pairs_s5_008 | -1 | 1792066019.583 | 24042.932 | mission_end | 1/1 legs
teb_icp_pairs | teb_icp_pairs_s5_009 | -1 | 1792066019.583 | 24042.932 | mission_start | pair09
teb_icp_pairs | teb_icp_pairs_s5_009 | -1 | 1792066019.583 | 24042.932 | goal_sent | dairy (-2.20, 2.75)
teb_icp_pairs | teb_icp_pairs_s5_009 | -1 | 1792066023.729 | 24046.992 | path_received | 3.8663 m
teb_icp_pairs | teb_icp_pairs_s5_009 | -1 | 1792066072.233 | 24094.420 | goal_reached_msg
teb_icp_pairs | teb_icp_pairs_s5_009 | 0 | 1792066074.236 | 24096.416 | goal_sent | gondola_1_west_b (0.15, 1.40)
teb_icp_pairs | teb_icp_pairs_s5_009 | 0 | 1792066077.158 | 24099.264 | path_received | 2.9799 m
teb_icp_pairs | teb_icp_pairs_s5_009 | 0 | 1792066113.943 | 24135.348 | controller_aborted
teb_icp_pairs | teb_icp_pairs_s5_009 | 0 | 1792066114.950 | 24136.348 | goal_resent | after controller abort
teb_icp_pairs | teb_icp_pairs_s5_009 | 0 | 1792066117.186 | 24138.552 | truth_gap | no Gazebo pose for 15 s (gz service); A1 samples blank
teb_icp_pairs | teb_icp_pairs_s5_009 | 0 | 1792066120.946 | 24142.312 | goal_reached_msg
teb_icp_pairs | teb_icp_pairs_s5_009 | -1 | 1792066122.947 | 24144.284 | mission_end | 1/1 legs
teb_icp_pairs | teb_icp_pairs_s5_010 | -1 | 1792066122.947 | 24144.284 | mission_start | pair10
teb_icp_pairs | teb_icp_pairs_s5_010 | -1 | 1792066122.948 | 24144.284 | goal_sent | produce (-1.40, 0.05)
teb_icp_pairs | teb_icp_pairs_s5_010 | -1 | 1792066125.578 | 24146.908 | path_received | 2.1092 m
teb_icp_pairs | teb_icp_pairs_s5_010 | -1 | 1792066157.388 | 24178.072 | goal_reached_msg
teb_icp_pairs | teb_icp_pairs_s5_010 | 0 | 1792066159.394 | 24180.076 | goal_sent | gondola_2_west_b+gondola_1_east_b (1.80, 1.40)
teb_icp_pairs | teb_icp_pairs_s5_010 | 0 | 1792066164.807 | 24185.348 | path_received | 4.7148 m
teb_icp_pairs | teb_icp_pairs_s5_010 | 0 | 1792066179.948 | 24200.408 | truth_gap | no Gazebo pose for 15 s (gz service); A1 samples blank
teb_icp_pairs | teb_icp_pairs_s5_010 | 0 | 1792066210.912 | 24230.844 | truth_gap | no Gazebo pose for 15 s (gz service); A1 samples blank
teb_icp_pairs | teb_icp_pairs_s5_010 | 0 | 1792066217.420 | 24237.200 | controller_aborted
teb_icp_pairs | teb_icp_pairs_s5_010 | 0 | 1792066218.420 | 24238.116 | goal_resent | after controller abort
teb_icp_pairs | teb_icp_pairs_s5_010 | 0 | 1792066228.733 | 24248.076 | controller_aborted
teb_icp_pairs | teb_icp_pairs_s5_010 | 0 | 1792066228.733 | 24248.076 | leg_failed | controller_aborted
teb_icp_pairs | teb_icp_pairs_s5_010 | -1 | 1792066230.741 | 24250.052 | mission_end | 0/1 legs
teb_icp_pairs | teb_icp_pairs_s5_011 | -1 | 1792066230.742 | 24250.052 | mission_start | pair11
teb_icp_pairs | teb_icp_pairs_s5_011 | -1 | 1792066230.742 | 24250.052 | goal_sent | gondola_3_a+gondola_2_east_a (3.48, -0.40)
teb_icp_pairs | teb_icp_pairs_s5_011 | -1 | 1792066235.588 | 24254.892 | path_received | 4.4263 m
teb_icp_pairs | teb_icp_pairs_s5_011 | -1 | 1792066250.652 | 24269.828 | truth_gap | no Gazebo pose for 15 s (gz service); A1 samples blank
teb_icp_pairs | teb_icp_pairs_s5_011 | -1 | 1792066280.777 | 24299.156 | truth_gap | no Gazebo pose for 15 s (gz service); A1 samples blank
teb_icp_pairs | teb_icp_pairs_s5_011 | -1 | 1792066282.904 | 24301.280 | goal_reached_msg
teb_icp_pairs | teb_icp_pairs_s5_011 | 0 | 1792066284.921 | 24303.240 | goal_sent | dairy (-2.20, 2.75)
teb_icp_pairs | teb_icp_pairs_s5_011 | 0 | 1792066289.879 | 24308.116 | path_received | 8.1849 m
teb_icp_pairs | teb_icp_pairs_s5_011 | 0 | 1792066305.809 | 24323.848 | truth_gap | no Gazebo pose for 15 s (gz service); A1 samples blank
teb_icp_pairs | teb_icp_pairs_s5_011 | 0 | 1792066337.150 | 24339.700 | sim_link_lost | /clock frozen for 15 s
teb_icp_pairs | teb_icp_pairs_s5_011 | 0 | 1792066337.150 | 24339.700 | leg_failed | sim_link_lost
teb_icp_pairs | teb_icp_pairs_s5_011 | 0 | 1792066340.156 | 24339.700 | runner_cancelled_follow_path
teb_icp_pairs | teb_icp_pairs_s5_011 | -1 | 1792066342.167 | 24339.700 | mission_end | 0/1 legs
teb_icp_pairs | teb_icp_pairs_s5_011 | -1 | 1792068110.714 | 529.268 | mission_start | pair11
teb_icp_pairs | teb_icp_pairs_s5_011 | -1 | 1792068110.716 | 529.268 | goal_sent | gondola_3_a+gondola_2_east_a (3.48, -0.40)
teb_icp_pairs | teb_icp_pairs_s5_011 | -1 | 1792068114.033 | 534.588 | path_received | 4.8971 m
teb_icp_pairs | teb_icp_pairs_s5_011 | -1 | 1792068166.446 | 584.068 | goal_reached_msg
teb_icp_pairs | teb_icp_pairs_s5_011 | 0 | 1792068168.452 | 586.080 | goal_sent | dairy (-2.20, 2.75)
teb_icp_pairs | teb_icp_pairs_s5_011 | 0 | 1792068174.460 | 591.840 | goal_resent_no_path
teb_icp_pairs | teb_icp_pairs_s5_011 | 0 | 1792068174.468 | 591.840 | path_received | 8.1849 m
teb_icp_pairs | teb_icp_pairs_s5_011 | 0 | 1792068268.580 | 679.656 | goal_reached_msg
teb_icp_pairs | teb_icp_pairs_s5_011 | -1 | 1792068270.582 | 681.508 | mission_end | 1/1 legs
teb_icp_pairs | teb_icp_pairs_s5_012 | -1 | 1792068270.582 | 681.508 | mission_start | pair12
teb_icp_pairs | teb_icp_pairs_s5_012 | -1 | 1792068270.582 | 681.508 | goal_sent | gondola_2_west_a+gondola_1_east_a (1.80, -0.40)
teb_icp_pairs | teb_icp_pairs_s5_012 | -1 | 1792068275.147 | 685.768 | path_received | 6.5056 m
teb_icp_pairs | teb_icp_pairs_s5_012 | -1 | 1792068352.351 | 757.788 | controller_aborted
teb_icp_pairs | teb_icp_pairs_s5_012 | -1 | 1792068353.354 | 758.792 | goal_resent | after controller abort
teb_icp_pairs | teb_icp_pairs_s5_012 | -1 | 1792068357.369 | 762.468 | goal_reached_msg
teb_icp_pairs | teb_icp_pairs_s5_012 | 0 | 1792068359.378 | 764.368 | goal_sent | produce (-1.40, 0.05)
teb_icp_pairs | teb_icp_pairs_s5_012 | 0 | 1792068364.199 | 768.828 | path_received | 4.237 m
teb_icp_pairs | teb_icp_pairs_s5_012 | 0 | 1792068415.986 | 817.660 | goal_reached_msg
teb_icp_pairs | teb_icp_pairs_s5_012 | -1 | 1792068417.993 | 819.504 | mission_end | 1/1 legs
teb_icp_pairs | teb_icp_pairs_s5_013 | -1 | 1792068417.993 | 819.504 | mission_start | pair13
teb_icp_pairs | teb_icp_pairs_s5_013 | -1 | 1792068417.994 | 819.504 | goal_sent | gondola_2_west_b+gondola_1_east_b (1.80, 1.40)
teb_icp_pairs | teb_icp_pairs_s5_013 | -1 | 1792068422.451 | 823.640 | path_received | 4.8441 m
teb_icp_pairs | teb_icp_pairs_s5_013 | -1 | 1792068478.055 | 875.964 | controller_aborted
teb_icp_pairs | teb_icp_pairs_s5_013 | -1 | 1792068479.060 | 876.864 | goal_resent | after controller abort
teb_icp_pairs | teb_icp_pairs_s5_013 | -1 | 1792068485.735 | 883.080 | goal_reached_msg
teb_icp_pairs | teb_icp_pairs_s5_013 | 0 | 1792068487.745 | 884.988 | goal_sent | produce (-1.40, 0.05)
teb_icp_pairs | teb_icp_pairs_s5_013 | 0 | 1792068492.187 | 889.092 | path_received | 4.8441 m
teb_icp_pairs | teb_icp_pairs_s5_013 | 0 | 1792068553.094 | 946.064 | goal_reached_msg
teb_icp_pairs | teb_icp_pairs_s5_013 | -1 | 1792068555.100 | 948.076 | mission_end | 1/1 legs
teb_icp_pairs | teb_icp_pairs_s5_014 | -1 | 1792068555.100 | 948.076 | mission_start | pair14
teb_icp_pairs | teb_icp_pairs_s5_014 | -1 | 1792068555.100 | 948.076 | goal_sent | gondola_3_b+gondola_2_east_b (3.48, 1.40)
teb_icp_pairs | teb_icp_pairs_s5_014 | -1 | 1792068561.103 | 953.944 | goal_resent_no_path
teb_icp_pairs | teb_icp_pairs_s5_014 | -1 | 1792068561.301 | 954.144 | path_received | 6.5234 m
teb_icp_pairs | teb_icp_pairs_s5_014 | -1 | 1792068638.406 | 1026.124 | controller_aborted
teb_icp_pairs | teb_icp_pairs_s5_014 | -1 | 1792068639.410 | 1027.132 | goal_resent | after controller abort
teb_icp_pairs | teb_icp_pairs_s5_014 | -1 | 1792068641.987 | 1029.712 | goal_reached_msg
teb_icp_pairs | teb_icp_pairs_s5_014 | 0 | 1792068643.991 | 1031.568 | goal_sent | tea_coffee (-2.45, 0.40)
teb_icp_pairs | teb_icp_pairs_s5_014 | 0 | 1792068648.189 | 1035.560 | path_received | 7.4698 m
teb_icp_pairs | teb_icp_pairs_s5_014 | 0 | 1792068734.178 | 1116.456 | goal_reached_msg
teb_icp_pairs | teb_icp_pairs_s5_014 | -1 | 1792068736.182 | 1118.348 | mission_end | 1/1 legs
teb_icp_pairs | teb_icp_pairs_s5_015 | -1 | 1792068736.182 | 1118.348 | mission_start | pair15
teb_icp_pairs | teb_icp_pairs_s5_015 | -1 | 1792068736.182 | 1118.348 | goal_sent | gondola_2_west_a+gondola_1_east_a (1.80, -0.40)
teb_icp_pairs | teb_icp_pairs_s5_015 | -1 | 1792068740.805 | 1122.648 | path_received | 5.432 m
teb_icp_pairs | teb_icp_pairs_s5_015 | -1 | 1792068801.714 | 1180.316 | goal_reached_msg
teb_icp_pairs | teb_icp_pairs_s5_015 | 0 | 1792068803.725 | 1182.108 | goal_sent | tea_coffee (-2.45, 0.40)
teb_icp_pairs | teb_icp_pairs_s5_015 | 0 | 1792068809.648 | 1187.652 | path_received | 5.482 m
teb_icp_pairs | teb_icp_pairs_s5_015 | 0 | 1792068877.276 | 1251.924 | controller_aborted
teb_icp_pairs | teb_icp_pairs_s5_015 | 0 | 1792068878.277 | 1252.832 | goal_resent | after controller abort
teb_icp_pairs | teb_icp_pairs_s5_015 | 0 | 1792068881.161 | 1255.472 | goal_reached_msg
teb_icp_pairs | teb_icp_pairs_s5_015 | -1 | 1792068883.164 | 1257.380 | mission_end | 1/1 legs
teb_icp_pairs | teb_icp_pairs_s5_016 | -1 | 1792068883.164 | 1257.380 | mission_start | pair16
teb_icp_pairs | teb_icp_pairs_s5_016 | -1 | 1792068883.164 | 1257.380 | goal_sent | produce (-1.40, 0.05)
teb_icp_pairs | teb_icp_pairs_s5_016 | -1 | 1792068884.132 | 1258.240 | path_received | 1.195 m
teb_icp_pairs | teb_icp_pairs_s5_016 | -1 | 1792068906.236 | 1278.704 | controller_aborted
teb_icp_pairs | teb_icp_pairs_s5_016 | -1 | 1792068907.238 | 1279.716 | goal_resent | after controller abort
teb_icp_pairs | teb_icp_pairs_s5_016 | -1 | 1792068909.434 | 1281.668 | goal_reached_msg
teb_icp_pairs | teb_icp_pairs_s5_016 | 0 | 1792068911.437 | 1283.676 | goal_sent | gondola_3_b+gondola_2_east_b (3.48, 1.40)
teb_icp_pairs | teb_icp_pairs_s5_016 | 0 | 1792068915.676 | 1287.900 | path_received | 6.5234 m
teb_icp_pairs | teb_icp_pairs_s5_016 | 0 | 1792068985.587 | 1354.056 | goal_reached_msg
teb_icp_pairs | teb_icp_pairs_s5_016 | -1 | 1792068987.589 | 1356.052 | mission_end | 1/1 legs
teb_icp_pairs | teb_icp_pairs_s5_017 | -1 | 1792068987.589 | 1356.052 | mission_start | pair17
teb_icp_pairs | teb_icp_pairs_s5_017 | -1 | 1792068987.589 | 1356.052 | goal_sent | gondola_2_west_a+gondola_1_east_a (1.80, -0.40)
teb_icp_pairs | teb_icp_pairs_s5_017 | -1 | 1792068991.633 | 1359.884 | path_received | 4.4349 m
teb_icp_pairs | teb_icp_pairs_s5_017 | -1 | 1792069049.441 | 1414.232 | goal_reached_msg
teb_icp_pairs | teb_icp_pairs_s5_017 | 0 | 1792069051.446 | 1416.136 | goal_sent | gondola_3_b+gondola_2_east_b (3.48, 1.40)
teb_icp_pairs | teb_icp_pairs_s5_017 | 0 | 1792069056.149 | 1420.792 | path_received | 4.4349 m
teb_icp_pairs | teb_icp_pairs_s5_017 | 0 | 1792069105.054 | 1467.696 | goal_reached_msg
teb_icp_pairs | teb_icp_pairs_s5_017 | -1 | 1792069107.062 | 1469.600 | mission_end | 1/1 legs
teb_icp_pairs | teb_icp_pairs_s5_018 | -1 | 1792069107.062 | 1469.600 | mission_start | pair18
teb_icp_pairs | teb_icp_pairs_s5_018 | -1 | 1792069107.062 | 1469.600 | goal_sent | produce (-1.40, 0.05)
teb_icp_pairs | teb_icp_pairs_s5_018 | -1 | 1792069110.750 | 1472.984 | path_received | 6.5234 m
teb_icp_pairs | teb_icp_pairs_s5_018 | -1 | 1792069189.960 | 1548.112 | goal_reached_msg
teb_icp_pairs | teb_icp_pairs_s5_018 | 0 | 1792069191.963 | 1550.108 | goal_sent | gondola_1_west_b (0.15, 1.40)
teb_icp_pairs | teb_icp_pairs_s5_018 | 0 | 1792069194.991 | 1552.900 | path_received | 2.1385 m
teb_icp_pairs | teb_icp_pairs_s5_018 | 0 | 1792069219.290 | 1575.508 | goal_reached_msg
teb_icp_pairs | teb_icp_pairs_s5_018 | -1 | 1792069221.292 | 1577.416 | mission_end | 1/1 legs
teb_icp_pairs | teb_icp_pairs_s5_019 | -1 | 1792069221.292 | 1577.416 | mission_start | pair19
teb_icp_pairs | teb_icp_pairs_s5_019 | -1 | 1792069221.292 | 1577.416 | goal_sent | dairy (-2.20, 2.75)
teb_icp_pairs | teb_icp_pairs_s5_019 | -1 | 1792069223.491 | 1579.580 | path_received | 2.9092 m
teb_icp_pairs | teb_icp_pairs_s5_019 | -1 | 1792069234.110 | 1589.620 | controller_aborted
teb_icp_pairs | teb_icp_pairs_s5_019 | -1 | 1792069235.121 | 1590.528 | goal_resent | after controller abort
teb_icp_pairs | teb_icp_pairs_s5_019 | -1 | 1792069268.315 | 1621.976 | controller_aborted
teb_icp_pairs | teb_icp_pairs_s5_019 | -1 | 1792069268.315 | 1621.976 | leg_failed | controller_aborted
teb_icp_pairs | teb_icp_pairs_s5_019 | -1 | 1792069270.320 | 1623.964 | start_not_reached | controller_aborted
teb_icp_pairs | teb_icp_pairs_s5_019 | 0 | 1792069270.320 | 1623.964 | goal_sent | gondola_3_a+gondola_2_east_a (3.48, -0.40)
teb_icp_pairs | teb_icp_pairs_s5_019 | 0 | 1792069274.924 | 1628.208 | path_received | 8.1849 m
teb_icp_pairs | teb_icp_pairs_s5_019 | 0 | 1792069362.426 | 1712.064 | goal_reached_msg
teb_icp_pairs | teb_icp_pairs_s5_019 | -1 | 1792069364.427 | 1714.072 | mission_end | 1/1 legs
rpp_icp_pairs | rpp_icp_pairs_s5_000 | -1 | 1792069588.467 | 1930.816 | mission_start | pair00
rpp_icp_pairs | rpp_icp_pairs_s5_000 | -1 | 1792069588.472 | 1930.816 | goal_sent | gondola_1_west_a (0.15, -0.40)
rpp_icp_pairs | rpp_icp_pairs_s5_000 | -1 | 1792069592.320 | 1937.944 | path_received | 4.3849 m
rpp_icp_pairs | rpp_icp_pairs_s5_000 | -1 | 1792069641.321 | 1984.704 | goal_reached_msg
rpp_icp_pairs | rpp_icp_pairs_s5_000 | 0 | 1792069643.344 | 1986.648 | goal_sent | gondola_3_a+gondola_2_east_a (3.48, -0.40)
rpp_icp_pairs | rpp_icp_pairs_s5_000 | 0 | 1792069648.053 | 1991.064 | path_received | 4.1435 m
rpp_icp_pairs | rpp_icp_pairs_s5_000 | 0 | 1792069654.066 | 1996.716 | controller_aborted
rpp_icp_pairs | rpp_icp_pairs_s5_000 | 0 | 1792069655.067 | 1997.728 | goal_resent | after controller abort
rpp_icp_pairs | rpp_icp_pairs_s5_000 | 0 | 1792069655.873 | 1998.532 | controller_aborted
rpp_icp_pairs | rpp_icp_pairs_s5_000 | 0 | 1792069655.873 | 1998.532 | leg_failed | controller_aborted
rpp_icp_pairs | rpp_icp_pairs_s5_000 | -1 | 1792069657.882 | 2000.524 | mission_end | 0/1 legs
rpp_icp_pairs | rpp_icp_pairs_s5_001 | -1 | 1792069657.883 | 2000.524 | mission_start | pair01
rpp_icp_pairs | rpp_icp_pairs_s5_001 | -1 | 1792069657.883 | 2000.524 | goal_sent | tea_coffee (-2.45, 0.40)
rpp_icp_pairs | rpp_icp_pairs_s5_001 | -1 | 1792069658.161 | 2000.788 | path_received | 3.8107 m
rpp_icp_pairs | rpp_icp_pairs_s5_001 | -1 | 1792069658.171 | 2000.800 | controller_aborted
rpp_icp_pairs | rpp_icp_pairs_s5_001 | -1 | 1792069659.175 | 2001.784 | goal_resent | after controller abort
rpp_icp_pairs | rpp_icp_pairs_s5_001 | -1 | 1792069703.984 | 2044.284 | goal_reached_msg
rpp_icp_pairs | rpp_icp_pairs_s5_001 | 0 | 1792069705.989 | 2046.184 | goal_sent | gondola_3_a+gondola_2_east_a (3.48, -0.40)
rpp_icp_pairs | rpp_icp_pairs_s5_001 | 0 | 1792069711.312 | 2051.404 | path_received | 6.8991 m
rpp_icp_pairs | rpp_icp_pairs_s5_001 | 0 | 1792069772.130 | 2108.932 | controller_aborted
rpp_icp_pairs | rpp_icp_pairs_s5_001 | 0 | 1792069773.132 | 2109.936 | goal_resent | after controller abort
rpp_icp_pairs | rpp_icp_pairs_s5_001 | 0 | 1792069782.214 | 2118.660 | goal_reached_msg
rpp_icp_pairs | rpp_icp_pairs_s5_001 | -1 | 1792069784.215 | 2120.628 | mission_end | 1/1 legs
rpp_icp_pairs | rpp_icp_pairs_s5_002 | -1 | 1792069784.215 | 2120.628 | mission_start | pair02
rpp_icp_pairs | rpp_icp_pairs_s5_002 | -1 | 1792069784.216 | 2120.628 | goal_sent | produce (-1.40, 0.05)
rpp_icp_pairs | rpp_icp_pairs_s5_002 | -1 | 1792069788.181 | 2124.576 | path_received | 5.6542 m
rpp_icp_pairs | rpp_icp_pairs_s5_002 | -1 | 1792069852.501 | 2185.640 | goal_reached_msg
rpp_icp_pairs | rpp_icp_pairs_s5_002 | 0 | 1792069854.503 | 2187.528 | goal_sent | dairy (-2.20, 2.75)
rpp_icp_pairs | rpp_icp_pairs_s5_002 | 0 | 1792069857.856 | 2190.668 | path_received | 3.3899 m
rpp_icp_pairs | rpp_icp_pairs_s5_002 | 0 | 1792069898.457 | 2229.104 | goal_reached_msg
rpp_icp_pairs | rpp_icp_pairs_s5_002 | -1 | 1792069900.466 | 2231.008 | mission_end | 1/1 legs
rpp_icp_pairs | rpp_icp_pairs_s5_003 | -1 | 1792069900.466 | 2231.008 | mission_start | pair03
rpp_icp_pairs | rpp_icp_pairs_s5_003 | -1 | 1792069900.466 | 2231.008 | goal_sent | tea_coffee (-2.45, 0.40)
rpp_icp_pairs | rpp_icp_pairs_s5_003 | -1 | 1792069902.118 | 2232.632 | path_received | 2.2743 m
rpp_icp_pairs | rpp_icp_pairs_s5_003 | -1 | 1792069929.735 | 2259.116 | goal_reached_msg
rpp_icp_pairs | rpp_icp_pairs_s5_003 | 0 | 1792069931.742 | 2261.012 | goal_sent | gondola_1_west_a (0.15, -0.40)
rpp_icp_pairs | rpp_icp_pairs_s5_003 | 0 | 1792069934.510 | 2263.580 | path_received | 2.8642 m
rpp_icp_pairs | rpp_icp_pairs_s5_003 | 0 | 1792069937.109 | 2265.932 | controller_aborted
rpp_icp_pairs | rpp_icp_pairs_s5_003 | 0 | 1792069938.109 | 2266.932 | goal_resent | after controller abort
rpp_icp_pairs | rpp_icp_pairs_s5_003 | 0 | 1792069939.002 | 2267.728 | controller_aborted
rpp_icp_pairs | rpp_icp_pairs_s5_003 | 0 | 1792069939.002 | 2267.728 | leg_failed | controller_aborted
rpp_icp_pairs | rpp_icp_pairs_s5_003 | -1 | 1792069941.006 | 2269.628 | mission_end | 0/1 legs
rpp_icp_pairs | rpp_icp_pairs_s5_004 | -1 | 1792069941.006 | 2269.628 | mission_start | pair04
rpp_icp_pairs | rpp_icp_pairs_s5_004 | -1 | 1792069941.006 | 2269.628 | wait_controller_idle
rpp_icp_pairs | rpp_icp_pairs_s5_004 | -1 | 1792069941.047 | 2269.676 | goal_sent | gondola_1_west_a (0.15, -0.40)
rpp_icp_pairs | rpp_icp_pairs_s5_004 | -1 | 1792069942.686 | 2271.200 | path_received | 2.6228 m
rpp_icp_pairs | rpp_icp_pairs_s5_004 | -1 | 1792069942.699 | 2271.200 | controller_aborted
rpp_icp_pairs | rpp_icp_pairs_s5_004 | -1 | 1792069943.703 | 2272.200 | goal_resent | after controller abort
rpp_icp_pairs | rpp_icp_pairs_s5_004 | -1 | 1792069944.622 | 2273.116 | controller_aborted
rpp_icp_pairs | rpp_icp_pairs_s5_004 | -1 | 1792069944.622 | 2273.116 | leg_failed | controller_aborted
rpp_icp_pairs | rpp_icp_pairs_s5_004 | -1 | 1792069946.627 | 2275.128 | start_not_reached | controller_aborted
rpp_icp_pairs | rpp_icp_pairs_s5_004 | 0 | 1792069946.628 | 2275.128 | goal_sent | gondola_2_west_b+gondola_1_east_b (1.80, 1.40)
rpp_icp_pairs | rpp_icp_pairs_s5_004 | 0 | 1792069946.638 | 2275.136 | path_received | 2.5521 m
rpp_icp_pairs | rpp_icp_pairs_s5_004 | 0 | 1792069947.641 | 2276.140 | controller_aborted
rpp_icp_pairs | rpp_icp_pairs_s5_004 | 0 | 1792069948.645 | 2277.132 | goal_resent | after controller abort
rpp_icp_pairs | rpp_icp_pairs_s5_004 | 0 | 1792069950.350 | 2278.800 | controller_aborted
rpp_icp_pairs | rpp_icp_pairs_s5_004 | 0 | 1792069950.350 | 2278.800 | leg_failed | controller_aborted
rpp_icp_pairs | rpp_icp_pairs_s5_004 | -1 | 1792069952.356 | 2280.816 | mission_end | 0/1 legs
rpp_icp_pairs | rpp_icp_pairs_s5_005 | -1 | 1792069952.356 | 2280.816 | mission_start | pair05
rpp_icp_pairs | rpp_icp_pairs_s5_005 | -1 | 1792069952.356 | 2280.816 | goal_sent | gondola_3_b+gondola_2_east_b (3.48, 1.40)
rpp_icp_pairs | rpp_icp_pairs_s5_005 | -1 | 1792069953.240 | 2281.692 | path_received | 5.2906 m
rpp_icp_pairs | rpp_icp_pairs_s5_005 | -1 | 1792069953.250 | 2281.704 | controller_aborted
rpp_icp_pairs | rpp_icp_pairs_s5_005 | -1 | 1792069954.258 | 2282.612 | goal_resent | after controller abort
rpp_icp_pairs | rpp_icp_pairs_s5_005 | -1 | 1792069957.918 | 2286.000 | controller_aborted
rpp_icp_pairs | rpp_icp_pairs_s5_005 | -1 | 1792069957.918 | 2286.000 | leg_failed | controller_aborted
rpp_icp_pairs | rpp_icp_pairs_s5_005 | -1 | 1792069959.927 | 2288.024 | start_not_reached | controller_aborted
rpp_icp_pairs | rpp_icp_pairs_s5_005 | 0 | 1792069959.927 | 2288.024 | goal_sent | gondola_1_west_a (0.15, -0.40)
rpp_icp_pairs | rpp_icp_pairs_s5_005 | 0 | 1792069961.797 | 2289.888 | path_received | 6.9698 m
rpp_icp_pairs | rpp_icp_pairs_s5_005 | 0 | 1792069961.807 | 2289.908 | controller_aborted
rpp_icp_pairs | rpp_icp_pairs_s5_005 | 0 | 1792069962.810 | 2290.900 | goal_resent | after controller abort
rpp_icp_pairs | rpp_icp_pairs_s5_005 | 0 | 1792069963.308 | 2291.384 | controller_aborted
rpp_icp_pairs | rpp_icp_pairs_s5_005 | 0 | 1792069963.308 | 2291.384 | leg_failed | controller_aborted
rpp_icp_pairs | rpp_icp_pairs_s5_005 | -1 | 1792069965.309 | 2293.376 | mission_end | 0/1 legs
rpp_icp_pairs | rpp_icp_pairs_s5_006 | -1 | 1792069965.309 | 2293.376 | mission_start | pair06
rpp_icp_pairs | rpp_icp_pairs_s5_006 | -1 | 1792069965.309 | 2293.376 | goal_sent | gondola_2_west_b+gondola_1_east_b (1.80, 1.40)
rpp_icp_pairs | rpp_icp_pairs_s5_006 | -1 | 1792069968.805 | 2296.856 | path_received | 5.2906 m
rpp_icp_pairs | rpp_icp_pairs_s5_006 | -1 | 1792069968.818 | 2296.872 | controller_aborted
rpp_icp_pairs | rpp_icp_pairs_s5_006 | -1 | 1792069969.830 | 2297.748 | goal_resent | after controller abort
rpp_icp_pairs | rpp_icp_pairs_s5_006 | -1 | 1792069973.246 | 2301.144 | controller_aborted
rpp_icp_pairs | rpp_icp_pairs_s5_006 | -1 | 1792069973.246 | 2301.144 | leg_failed | controller_aborted
rpp_icp_pairs | rpp_icp_pairs_s5_006 | -1 | 1792069975.254 | 2303.136 | start_not_reached | controller_aborted
rpp_icp_pairs | rpp_icp_pairs_s5_006 | 0 | 1792069975.254 | 2303.136 | goal_sent | gondola_3_a+gondola_2_east_a (3.48, -0.40)
rpp_icp_pairs | rpp_icp_pairs_s5_006 | 0 | 1792069981.268 | 2308.760 | goal_resent_no_path
rpp_icp_pairs | rpp_icp_pairs_s5_006 | 0 | 1792069982.546 | 2309.964 | path_received | 6.6113 m
rpp_icp_pairs | rpp_icp_pairs_s5_006 | 0 | 1792070053.456 | 2373.928 | goal_reached_msg
rpp_icp_pairs | rpp_icp_pairs_s5_006 | -1 | 1792070055.468 | 2375.768 | mission_end | 1/1 legs
rpp_icp_pairs | rpp_icp_pairs_s5_007 | -1 | 1792070055.468 | 2375.768 | mission_start | pair07
rpp_icp_pairs | rpp_icp_pairs_s5_007 | -1 | 1792070055.469 | 2375.768 | goal_sent | dairy (-2.20, 2.75)
rpp_icp_pairs | rpp_icp_pairs_s5_007 | -1 | 1792070061.484 | 2381.376 | goal_resent_no_path
rpp_icp_pairs | rpp_icp_pairs_s5_007 | -1 | 1792070063.190 | 2383.028 | path_received | 8.3435 m
rpp_icp_pairs | rpp_icp_pairs_s5_007 | -1 | 1792070156.886 | 2472.244 | goal_reached_msg
rpp_icp_pairs | rpp_icp_pairs_s5_007 | 0 | 1792070158.890 | 2474.248 | goal_sent | gondola_1_west_a (0.15, -0.40)
rpp_icp_pairs | rpp_icp_pairs_s5_007 | 0 | 1792070162.431 | 2477.752 | path_received | 4.1577 m
rpp_icp_pairs | rpp_icp_pairs_s5_007 | 0 | 1792070204.438 | 2517.688 | goal_reached_msg
rpp_icp_pairs | rpp_icp_pairs_s5_007 | -1 | 1792070206.441 | 2519.692 | mission_end | 1/1 legs
rpp_icp_pairs | rpp_icp_pairs_s5_008 | -1 | 1792070206.441 | 2519.692 | mission_start | pair08
rpp_icp_pairs | rpp_icp_pairs_s5_008 | -1 | 1792070206.441 | 2519.692 | goal_sent | gondola_3_a+gondola_2_east_a (3.48, -0.40)
rpp_icp_pairs | rpp_icp_pairs_s5_008 | -1 | 1792070210.315 | 2523.424 | path_received | 4.5971 m
rpp_icp_pairs | rpp_icp_pairs_s5_008 | -1 | 1792070258.223 | 2568.648 | goal_reached_msg
rpp_icp_pairs | rpp_icp_pairs_s5_008 | 0 | 1792070260.227 | 2570.544 | goal_sent | home (0.00, 0.00)
rpp_icp_pairs | rpp_icp_pairs_s5_008 | 0 | 1792070263.899 | 2574.120 | path_received | 4.5849 m
rpp_icp_pairs | rpp_icp_pairs_s5_008 | 0 | 1792070315.584 | 2623.700 | goal_reached_msg
rpp_icp_pairs | rpp_icp_pairs_s5_008 | -1 | 1792070317.591 | 2625.560 | mission_end | 1/1 legs
rpp_icp_pairs | rpp_icp_pairs_s5_009 | -1 | 1792070317.591 | 2625.560 | mission_start | pair09
rpp_icp_pairs | rpp_icp_pairs_s5_009 | -1 | 1792070317.592 | 2625.560 | goal_sent | dairy (-2.20, 2.75)
rpp_icp_pairs | rpp_icp_pairs_s5_009 | -1 | 1792070321.311 | 2629.168 | path_received | 4.1077 m
rpp_icp_pairs | rpp_icp_pairs_s5_009 | -1 | 1792070368.316 | 2674.036 | goal_reached_msg
rpp_icp_pairs | rpp_icp_pairs_s5_009 | 0 | 1792070370.323 | 2676.028 | goal_sent | gondola_1_west_b (0.15, 1.40)
rpp_icp_pairs | rpp_icp_pairs_s5_009 | 0 | 1792070373.618 | 2679.204 | path_received | 2.6971 m
rpp_icp_pairs | rpp_icp_pairs_s5_009 | 0 | 1792070400.213 | 2704.468 | goal_reached_msg
rpp_icp_pairs | rpp_icp_pairs_s5_009 | -1 | 1792070402.224 | 2706.364 | mission_end | 1/1 legs
rpp_icp_pairs | rpp_icp_pairs_s5_010 | -1 | 1792070402.225 | 2706.364 | mission_start | pair10
rpp_icp_pairs | rpp_icp_pairs_s5_010 | -1 | 1792070402.225 | 2706.364 | goal_sent | produce (-1.40, 0.05)
rpp_icp_pairs | rpp_icp_pairs_s5_010 | -1 | 1792070405.369 | 2709.332 | path_received | 2.2263 m
rpp_icp_pairs | rpp_icp_pairs_s5_010 | -1 | 1792070433.485 | 2736.056 | goal_reached_msg
rpp_icp_pairs | rpp_icp_pairs_s5_010 | 0 | 1792070435.487 | 2737.968 | goal_sent | gondola_2_west_b+gondola_1_east_b (1.80, 1.40)
rpp_icp_pairs | rpp_icp_pairs_s5_010 | 0 | 1792070439.178 | 2741.392 | path_received | 4.582 m
rpp_icp_pairs | rpp_icp_pairs_s5_010 | 0 | 1792070485.089 | 2785.056 | goal_reached_msg
rpp_icp_pairs | rpp_icp_pairs_s5_010 | -1 | 1792070487.090 | 2787.024 | mission_end | 1/1 legs
rpp_icp_pairs | rpp_icp_pairs_s5_011 | -1 | 1792070487.090 | 2787.024 | mission_start | pair11
rpp_icp_pairs | rpp_icp_pairs_s5_011 | -1 | 1792070487.090 | 2787.024 | goal_sent | gondola_3_a+gondola_2_east_a (3.48, -0.40)
rpp_icp_pairs | rpp_icp_pairs_s5_011 | -1 | 1792070490.496 | 2790.424 | path_received | 4.3556 m
rpp_icp_pairs | rpp_icp_pairs_s5_011 | -1 | 1792070497.508 | 2797.008 | controller_aborted
rpp_icp_pairs | rpp_icp_pairs_s5_011 | -1 | 1792070498.514 | 2797.900 | goal_resent | after controller abort
rpp_icp_pairs | rpp_icp_pairs_s5_011 | -1 | 1792070498.714 | 2798.096 | controller_aborted
rpp_icp_pairs | rpp_icp_pairs_s5_011 | -1 | 1792070498.714 | 2798.096 | leg_failed | controller_aborted
rpp_icp_pairs | rpp_icp_pairs_s5_011 | -1 | 1792070500.714 | 2799.956 | start_not_reached | controller_aborted
rpp_icp_pairs | rpp_icp_pairs_s5_011 | 0 | 1792070500.715 | 2799.956 | goal_sent | dairy (-2.20, 2.75)
rpp_icp_pairs | rpp_icp_pairs_s5_011 | 0 | 1792070500.860 | 2800.076 | path_received | 3.8607 m
rpp_icp_pairs | rpp_icp_pairs_s5_011 | 0 | 1792070500.877 | 2800.096 | controller_aborted
rpp_icp_pairs | rpp_icp_pairs_s5_011 | 0 | 1792070501.883 | 2801.004 | goal_resent | after controller abort
rpp_icp_pairs | rpp_icp_pairs_s5_011 | 0 | 1792070558.436 | 2854.888 | goal_reached_msg
rpp_icp_pairs | rpp_icp_pairs_s5_011 | -1 | 1792070560.437 | 2856.692 | mission_end | 1/1 legs
rpp_icp_pairs | rpp_icp_pairs_s5_012 | -1 | 1792070560.438 | 2856.692 | mission_start | pair12
rpp_icp_pairs | rpp_icp_pairs_s5_012 | -1 | 1792070560.438 | 2856.692 | goal_sent | gondola_2_west_a+gondola_1_east_a (1.80, -0.40)
rpp_icp_pairs | rpp_icp_pairs_s5_012 | -1 | 1792070564.996 | 2861.080 | path_received | 6.2935 m
rpp_icp_pairs | rpp_icp_pairs_s5_012 | -1 | 1792070628.795 | 2922.680 | goal_reached_msg
rpp_icp_pairs | rpp_icp_pairs_s5_012 | 0 | 1792070630.798 | 2924.668 | goal_sent | produce (-1.40, 0.05)
rpp_icp_pairs | rpp_icp_pairs_s5_012 | 0 | 1792070634.747 | 2928.600 | path_received | 4.3042 m
rpp_icp_pairs | rpp_icp_pairs_s5_012 | 0 | 1792070684.061 | 2975.728 | goal_reached_msg
rpp_icp_pairs | rpp_icp_pairs_s5_012 | -1 | 1792070686.063 | 2977.496 | mission_end | 1/1 legs
rpp_icp_pairs | rpp_icp_pairs_s5_013 | -1 | 1792070686.063 | 2977.496 | mission_start | pair13
rpp_icp_pairs | rpp_icp_pairs_s5_013 | -1 | 1792070686.063 | 2977.496 | goal_sent | gondola_2_west_b+gondola_1_east_b (1.80, 1.40)
rpp_icp_pairs | rpp_icp_pairs_s5_013 | -1 | 1792070689.982 | 2981.180 | path_received | 4.7855 m
rpp_icp_pairs | rpp_icp_pairs_s5_013 | -1 | 1792070718.270 | 3008.808 | truth_gap | no Gazebo pose for 15 s (gz service); A1 samples blank
rpp_icp_pairs | rpp_icp_pairs_s5_013 | -1 | 1792070737.884 | 3027.484 | goal_reached_msg
rpp_icp_pairs | rpp_icp_pairs_s5_013 | 0 | 1792070739.889 | 3029.484 | goal_sent | produce (-1.40, 0.05)
rpp_icp_pairs | rpp_icp_pairs_s5_013 | 0 | 1792070743.113 | 3032.572 | path_received | 4.582 m
rpp_icp_pairs | rpp_icp_pairs_s5_013 | 0 | 1792070761.813 | 3050.076 | controller_aborted
rpp_icp_pairs | rpp_icp_pairs_s5_013 | 0 | 1792070762.817 | 3051.064 | goal_resent | after controller abort
rpp_icp_pairs | rpp_icp_pairs_s5_013 | 0 | 1792070797.310 | 3083.896 | goal_reached_msg
rpp_icp_pairs | rpp_icp_pairs_s5_013 | -1 | 1792070799.321 | 3085.800 | mission_end | 1/1 legs
rpp_icp_pairs | rpp_icp_pairs_s5_014 | -1 | 1792070799.322 | 3085.800 | mission_start | pair14
rpp_icp_pairs | rpp_icp_pairs_s5_014 | -1 | 1792070799.322 | 3085.800 | goal_sent | gondola_3_b+gondola_2_east_b (3.48, 1.40)
rpp_icp_pairs | rpp_icp_pairs_s5_014 | -1 | 1792070803.282 | 3089.740 | path_received | 6.2613 m
rpp_icp_pairs | rpp_icp_pairs_s5_014 | -1 | 1792070864.987 | 3149.920 | goal_reached_msg
rpp_icp_pairs | rpp_icp_pairs_s5_014 | 0 | 1792070866.993 | 3151.928 | goal_sent | tea_coffee (-2.45, 0.40)
rpp_icp_pairs | rpp_icp_pairs_s5_014 | 0 | 1792070871.086 | 3155.692 | path_received | 7.2077 m
rpp_icp_pairs | rpp_icp_pairs_s5_014 | 0 | 1792070905.890 | 3189.244 | controller_aborted
rpp_icp_pairs | rpp_icp_pairs_s5_014 | 0 | 1792070906.898 | 3190.252 | goal_resent | after controller abort
rpp_icp_pairs | rpp_icp_pairs_s5_014 | 0 | 1792070909.331 | 3192.680 | controller_aborted
rpp_icp_pairs | rpp_icp_pairs_s5_014 | 0 | 1792070909.331 | 3192.680 | leg_failed | controller_aborted
rpp_icp_pairs | rpp_icp_pairs_s5_014 | -1 | 1792070911.333 | 3194.556 | mission_end | 0/1 legs
rpp_icp_pairs | rpp_icp_pairs_s5_015 | -1 | 1792070911.333 | 3194.556 | mission_start | pair15
rpp_icp_pairs | rpp_icp_pairs_s5_015 | -1 | 1792070911.334 | 3194.556 | goal_sent | gondola_2_west_a+gondola_1_east_a (1.80, -0.40)
rpp_icp_pairs | rpp_icp_pairs_s5_015 | -1 | 1792070912.154 | 3195.248 | path_received | 4.1213 m
rpp_icp_pairs | rpp_icp_pairs_s5_015 | -1 | 1792070912.666 | 3195.728 | controller_aborted
rpp_icp_pairs | rpp_icp_pairs_s5_015 | -1 | 1792070913.671 | 3196.632 | goal_resent | after controller abort
rpp_icp_pairs | rpp_icp_pairs_s5_015 | -1 | 1792070914.541 | 3197.496 | controller_aborted
rpp_icp_pairs | rpp_icp_pairs_s5_015 | -1 | 1792070914.541 | 3197.496 | leg_failed | controller_aborted
rpp_icp_pairs | rpp_icp_pairs_s5_015 | -1 | 1792070916.548 | 3199.404 | start_not_reached | controller_aborted
rpp_icp_pairs | rpp_icp_pairs_s5_015 | 0 | 1792070916.549 | 3199.404 | goal_sent | tea_coffee (-2.45, 0.40)
rpp_icp_pairs | rpp_icp_pairs_s5_015 | 0 | 1792070916.840 | 3199.584 | path_received | 3.4692 m
rpp_icp_pairs | rpp_icp_pairs_s5_015 | 0 | 1792070916.855 | 3199.600 | controller_aborted
rpp_icp_pairs | rpp_icp_pairs_s5_015 | 0 | 1792070917.862 | 3200.604 | goal_resent | after controller abort
rpp_icp_pairs | rpp_icp_pairs_s5_015 | 0 | 1792070919.861 | 3202.408 | controller_aborted
rpp_icp_pairs | rpp_icp_pairs_s5_015 | 0 | 1792070919.861 | 3202.408 | leg_failed | controller_aborted
rpp_icp_pairs | rpp_icp_pairs_s5_015 | -1 | 1792070921.864 | 3204.272 | mission_end | 0/1 legs
rpp_icp_pairs | rpp_icp_pairs_s5_016 | -1 | 1792070921.864 | 3204.272 | mission_start | pair16
rpp_icp_pairs | rpp_icp_pairs_s5_016 | -1 | 1792070921.865 | 3204.272 | goal_sent | produce (-1.40, 0.05)
rpp_icp_pairs | rpp_icp_pairs_s5_016 | -1 | 1792070922.913 | 3205.296 | path_received | 4.1213 m
rpp_icp_pairs | rpp_icp_pairs_s5_016 | -1 | 1792070923.324 | 3205.636 | controller_aborted
rpp_icp_pairs | rpp_icp_pairs_s5_016 | -1 | 1792070924.330 | 3206.636 | goal_resent | after controller abort
rpp_icp_pairs | rpp_icp_pairs_s5_016 | -1 | 1792070958.956 | 3239.664 | goal_reached_msg
rpp_icp_pairs | rpp_icp_pairs_s5_016 | 0 | 1792070960.962 | 3241.540 | goal_sent | gondola_3_b+gondola_2_east_b (3.48, 1.40)
rpp_icp_pairs | rpp_icp_pairs_s5_016 | 0 | 1792070965.119 | 3245.684 | path_received | 6.2613 m
rpp_icp_pairs | rpp_icp_pairs_s5_016 | 0 | 1792071027.626 | 3306.292 | goal_reached_msg
rpp_icp_pairs | rpp_icp_pairs_s5_016 | -1 | 1792071029.627 | 3308.152 | mission_end | 1/1 legs
rpp_icp_pairs | rpp_icp_pairs_s5_017 | -1 | 1792071029.627 | 3308.152 | mission_start | pair17
rpp_icp_pairs | rpp_icp_pairs_s5_017 | -1 | 1792071029.628 | 3308.152 | goal_sent | gondola_2_west_a+gondola_1_east_a (1.80, -0.40)
rpp_icp_pairs | rpp_icp_pairs_s5_017 | -1 | 1792071033.726 | 3312.048 | path_received | 4.1728 m
rpp_icp_pairs | rpp_icp_pairs_s5_017 | -1 | 1792071082.332 | 3358.532 | goal_reached_msg
rpp_icp_pairs | rpp_icp_pairs_s5_017 | 0 | 1792071084.334 | 3360.400 | wait_controller_idle
rpp_icp_pairs | rpp_icp_pairs_s5_017 | 0 | 1792071091.447 | 3367.044 | goal_sent | gondola_3_b+gondola_2_east_b (3.48, 1.40)
rpp_icp_pairs | rpp_icp_pairs_s5_017 | 0 | 1792071095.028 | 3370.612 | path_received | 4.1521 m
rpp_icp_pairs | rpp_icp_pairs_s5_017 | 0 | 1792071139.231 | 3413.104 | goal_reached_msg
rpp_icp_pairs | rpp_icp_pairs_s5_017 | -1 | 1792071141.232 | 3414.988 | mission_end | 1/1 legs
rpp_icp_pairs | rpp_icp_pairs_s5_018 | -1 | 1792071141.232 | 3414.988 | mission_start | pair18
rpp_icp_pairs | rpp_icp_pairs_s5_018 | -1 | 1792071141.232 | 3414.988 | goal_sent | produce (-1.40, 0.05)
rpp_icp_pairs | rpp_icp_pairs_s5_018 | -1 | 1792071145.904 | 3419.412 | path_received | 6.2613 m
rpp_icp_pairs | rpp_icp_pairs_s5_018 | -1 | 1792071161.563 | 3434.880 | truth_gap | no Gazebo pose for 15 s (gz service); A1 samples blank
rpp_icp_pairs | rpp_icp_pairs_s5_018 | -1 | 1792071180.817 | 3453.472 | controller_aborted
rpp_icp_pairs | rpp_icp_pairs_s5_018 | -1 | 1792071181.820 | 3454.384 | goal_resent | after controller abort
rpp_icp_pairs | rpp_icp_pairs_s5_018 | -1 | 1792071181.821 | 3454.392 | controller_aborted
rpp_icp_pairs | rpp_icp_pairs_s5_018 | -1 | 1792071181.821 | 3454.392 | leg_failed | controller_aborted
rpp_icp_pairs | rpp_icp_pairs_s5_018 | -1 | 1792071183.828 | 3456.392 | start_not_reached | controller_aborted
rpp_icp_pairs | rpp_icp_pairs_s5_018 | 0 | 1792071183.828 | 3456.392 | goal_sent | gondola_1_west_b (0.15, 1.40)
rpp_icp_pairs | rpp_icp_pairs_s5_018 | 0 | 1792071185.015 | 3457.560 | path_received | 3.0542 m
rpp_icp_pairs | rpp_icp_pairs_s5_018 | 0 | 1792071218.005 | 3489.352 | truth_gap | no Gazebo pose for 15 s (gz service); A1 samples blank
rpp_icp_pairs | rpp_icp_pairs_s5_018 | 0 | 1792071218.308 | 3489.656 | goal_reached_msg
rpp_icp_pairs | rpp_icp_pairs_s5_018 | -1 | 1792071220.314 | 3491.560 | mission_end | 1/1 legs
rpp_icp_pairs | rpp_icp_pairs_s5_019 | -1 | 1792071220.314 | 3491.560 | mission_start | pair19
rpp_icp_pairs | rpp_icp_pairs_s5_019 | -1 | 1792071220.314 | 3491.560 | goal_sent | dairy (-2.20, 2.75)
rpp_icp_pairs | rpp_icp_pairs_s5_019 | -1 | 1792071222.988 | 3493.968 | path_received | 3.3157 m
rpp_icp_pairs | rpp_icp_pairs_s5_019 | -1 | 1792071233.386 | 3504.004 | controller_aborted
rpp_icp_pairs | rpp_icp_pairs_s5_019 | -1 | 1792071234.386 | 3504.896 | goal_resent | after controller abort
rpp_icp_pairs | rpp_icp_pairs_s5_019 | -1 | 1792071237.861 | 3508.088 | controller_aborted
rpp_icp_pairs | rpp_icp_pairs_s5_019 | -1 | 1792071237.861 | 3508.088 | leg_failed | controller_aborted
rpp_icp_pairs | rpp_icp_pairs_s5_019 | -1 | 1792071239.865 | 3509.996 | start_not_reached | controller_aborted
rpp_icp_pairs | rpp_icp_pairs_s5_019 | 0 | 1792071239.865 | 3509.996 | wait_controller_idle
rpp_icp_pairs | rpp_icp_pairs_s5_019 | 0 | 1792071259.873 | 3529.284 | controller_still_busy | cancelling FollowPath
rpp_icp_pairs | rpp_icp_pairs_s5_019 | 0 | 1792071259.970 | 3529.360 | goal_sent | gondola_3_a+gondola_2_east_a (3.48, -0.40)
rpp_icp_pairs | rpp_icp_pairs_s5_019 | 0 | 1792071264.193 | 3533.564 | path_received | 7.9692 m
rpp_icp_pairs | rpp_icp_pairs_s5_019 | 0 | 1792071349.923 | 3614.840 | goal_reached_msg
rpp_icp_pairs | rpp_icp_pairs_s5_019 | -1 | 1792071351.927 | 3616.856 | mission_end | 1/1 legs
teb_icp_boxes | teb_icp_boxes_s9_000 | -1 | 1792076228.711 | 2446.244 | mission_start | pair00
teb_icp_boxes | teb_icp_boxes_s9_000 | -1 | 1792076229.564 | 2446.244 | goal_sent | tea_coffee (-2.45, 0.40)
teb_icp_boxes | teb_icp_boxes_s9_000 | -1 | 1792076231.767 | 2451.616 | path_received | 2.5657 m
teb_icp_boxes | teb_icp_boxes_s9_000 | -1 | 1792076271.665 | 2489.056 | goal_reached_msg
teb_icp_boxes | teb_icp_boxes_s9_000 | 0 | 1792076274.605 | 2490.944 | goal_sent | gondola_3_b+gondola_2_east_b (3.48, 1.40)
teb_icp_boxes | teb_icp_boxes_s9_000 | 0 | 1792076279.422 | 2496.160 | path_received | 7.6113 m
teb_icp_boxes | teb_icp_boxes_s9_000 | 0 | 1792076280.484 | 2496.160 | box_spawned | arc_test_box_1 (-0.00, 1.79)
teb_icp_boxes | teb_icp_boxes_s9_000 | 0 | 1792076280.484 | 2496.160 | box_spawned | arc_test_box_2 (1.75, 2.04)
teb_icp_boxes | teb_icp_boxes_s9_000 | 0 | 1792076280.484 | 2496.160 | box_spawned | arc_test_box_3 (-0.80, 0.84)
teb_icp_boxes | teb_icp_boxes_s9_000 | 0 | 1792076341.430 | 2554.136 | controller_aborted
teb_icp_boxes | teb_icp_boxes_s9_000 | 0 | 1792076342.432 | 2555.000 | goal_resent | after controller abort
teb_icp_boxes | teb_icp_boxes_s9_000 | 0 | 1792076350.587 | 2562.580 | stall | no motion for 8 s
teb_icp_boxes | teb_icp_boxes_s9_000 | 0 | 1792076355.545 | 2567.228 | controller_aborted
teb_icp_boxes | teb_icp_boxes_s9_000 | 0 | 1792076355.545 | 2567.228 | leg_failed | controller_aborted
teb_icp_boxes | teb_icp_boxes_s9_000 | 0 | 1792076357.580 | 2567.228 | box_removed | arc_test_box_1
teb_icp_boxes | teb_icp_boxes_s9_000 | 0 | 1792076359.778 | 2567.228 | box_removed | arc_test_box_2
teb_icp_boxes | teb_icp_boxes_s9_000 | 0 | 1792076361.646 | 2567.228 | box_removed | arc_test_box_3
teb_icp_boxes | teb_icp_boxes_s9_000 | -1 | 1792076363.649 | 2574.104 | mission_end | 0/1 legs
teb_icp_boxes | teb_icp_boxes_s9_001 | -1 | 1792076363.650 | 2574.104 | mission_start | pair01
teb_icp_boxes | teb_icp_boxes_s9_001 | -1 | 1792076364.696 | 2574.104 | goal_sent | gondola_2_west_b+gondola_1_east_b (1.80, 1.40)
teb_icp_boxes | teb_icp_boxes_s9_001 | -1 | 1792076366.180 | 2576.260 | path_received | 0.8414 m
teb_icp_boxes | teb_icp_boxes_s9_001 | -1 | 1792076378.386 | 2587.700 | goal_reached_msg
teb_icp_boxes | teb_icp_boxes_s9_001 | 0 | 1792076381.366 | 2589.544 | goal_sent | tea_coffee (-2.45, 0.40)
teb_icp_boxes | teb_icp_boxes_s9_001 | 0 | 1792076381.374 | 2590.428 | path_received | 0.0707 m
teb_icp_boxes | teb_icp_boxes_s9_001 | 0 | 1792076381.383 | 2590.436 | goal_reached_msg
teb_icp_boxes | teb_icp_boxes_s9_001 | -1 | 1792076383.386 | 2592.440 | mission_end | 1/1 legs
teb_icp_boxes | teb_icp_boxes_s9_002 | -1 | 1792076383.386 | 2592.440 | mission_start | pair02
teb_icp_boxes | teb_icp_boxes_s9_002 | -1 | 1792076388.553 | 2592.440 | goal_sent | dairy (-2.20, 2.75)
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
