akshada-raghuvanshiii/Adaptive_Retail_Companion/evaluation/results/hil_20261016_181250.csv

t | bt_mode | cmd_v | cmd_w | target_l_mm_s | target_r_mm_s | meas_l_mm_s | meas_r_mm_s | pwm_l | pwm_r | enc_l | enc_r | estop_open
2.602 |  | 0.0000 | 0.0000 | 0.0 | 0.0 | 0.0 | 0.0 | 0 | 0 | 0 | 0 | 0
3.602 |  | 0.0000 | 0.0000 | 0.0 | 0.0 | 0.0 | 0.0 | 0 | 0 | 0 | 0 | 0
4.602 | WAIT | 0.0000 | 0.0000 | 0.0 | 0.0 | 0.0 | 0.0 | 0 | 0 | 0 | 0 | 0
5.652 | WAIT | 0.0000 | 0.0000 | 0.0 | 0.0 | 0.0 | 0.0 | 0 | 0 | 0 | 0 | 0
6.651 | WAIT | 0.0000 | 0.0000 | 0.0 | 0.0 | 0.0 | 0.0 | 0 | 0 | 0 | 0 | 0
7.652 | WAIT | 0.0000 | 0.0000 | 0.0 | 0.0 | 0.0 | 0.0 | 0 | 0 | 0 | 0 | 0
8.652 | WAIT | 0.0000 | 0.0000 | 0.0 | 0.0 | 0.0 | 0.0 | 0 | 0 | 0 | 0 | 0
9.652 | WAIT | 0.0000 | 0.0000 | 0.0 | 0.0 | 0.0 | 0.0 | 0 | 0 | 0 | 0 | 0
10.651 | WAIT | 0.0000 | 0.0000 | 0.0 | 0.0 | 0.0 | 0.0 | 0 | 0 | 0 | 0 | 0
11.652 | WAIT | 0.0000 | 0.0000 | 0.0 | 0.0 | 0.0 | 0.0 | 0 | 0 | 0 | 0 | 0
12.652 | WAIT | 0.0000 | 0.0000 | 0.0 | 0.0 | 0.0 | 0.0 | 0 | 0 | 0 | 0 | 0
13.652 | WAIT | 0.0000 | 0.0000 | 0.0 | 0.0 | 0.0 | 0.0 | 0 | 0 | 0 | 0 | 0
14.652 | WAIT | 0.0000 | 0.0000 | 0.0 | 0.0 | 0.0 | 0.0 | 0 | 0 | 0 | 0 | 0
15.652 | WAIT | 0.0000 | 0.0000 | 0.0 | 0.0 | 0.0 | 0.0 | 0 | 0 | 0 | 0 | 0
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
