akshada-raghuvanshiii/Adaptive_Retail_Companion/evaluation/results/legs.csv

label | mission | strategy | n_items | n_stops | leg | stop_id | goal_x | goal_y | planned_len | paths_received | driven_len_true | driven_len_map | time_s | success | reason | reached_msg | final_dist | ctrl_aborts | resends | stall_events | n_obstacles | min_obstacle_clearance | min_static_clearance | max_pos_err | w_sign_changes | mean_abs_wdot | reverse_s | idle_wait_s | cmd_msgs
smoke | smoke_s5_000 | pair | 0 | 1 | -1 | gondola_1_west_a | 0.15 | -0.4 | 0.5328 | 5 | 0.5446 | 0.6829 | 19.83 | 1 | arrived | 1 | 0.021 | 1 | 1 | 0 | 0 |  | 0.422 | 0.0219 | 7 | 0.7072 | 0.0 | 0.0 | 172
smoke | smoke_s5_000 | pair | 0 | 1 | 0 | gondola_3_a+gondola_2_east_a | 3.475 | -0.4 | 4.3849 | 20 | 4.2884 | 4.4801 | 56.14 | 1 | arrived | 1 | 0.008 | 0 | 0 | 0 | 0 |  | 0.104 | 0.0418 | 8 | 0.229 | 0.0 | 0.0 | 518
teb_icp | teb_icp_s7_000 | as_entered | 8 | 4 | -1 | home | 0.0 | 0.0 | 0 | 2 | 0.0 | 0.0 | 0.03 | 1 | arrived | 1 | 3.507 | 0 | 0 | 0 | 0 |  | 0.431 | 0.0273 | 0 | 62.5 | 0.0 | 0.0 | 2
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
