akshada-raghuvanshiii/Adaptive_Retail_Companion/evaluation/results/run_logs/auto_map_FAILED_2129.csv

waypoint | label | event | map_x | map_y | map_yaw_deg | odom_x | odom_y | odom_yaw_deg | gz_x | gz_y | gz_yaw_deg | map_err_m | map_err_deg | odom_err_m | odom_err_deg
1 | south of start | reached | 0.002 | -1.435 | -92.3 | -0.065 | -1.437 | -94.3 | -0.015 | -1.447 | -92.7 | 0.02 | 0.3 | 0.05 | 1.7
2 | south end of aisle 1-2 | reached | 1.724 | -1.495 | -3.7 | 1.665 | -1.518 | -3.8 | 1.708 | -1.517 | -3.9 | 0.03 | 0.2 | 0.04 | 0.1
3 | north end of aisle 1-2 | reached | 1.794 | 2.628 | 91.1 | 1.662 | 2.709 | 91.9 | 1.808 | 2.701 | 90.8 | 0.07 | 0.3 | 0.15 | 1.0
4 | north end of aisle 2-3 | reached | 3.408 | 2.696 | 2.0 | 3.279 | 2.737 | 1.1 | 3.433 | 2.760 | 1.8 | 0.07 | 0.2 | 0.16 | 0.7
5 | south end of aisle 2-3 | reached | 3.492 | -1.429 | -88.8 | 3.114 | -1.751 | -92.7 | 3.474 | -1.740 | -89.2 | 0.31 | 0.4 | 0.36 | 3.5
6 | back west along the south side | reached | 0.076 | -1.499 | -179.3 | -0.292 | -1.481 | 175.4 | 0.049 | -1.798 | -179.3 | 0.30 | 0.0 | 0.46 | 5.3
7 | in front of the checkout | reached | -2.432 | -1.211 | 172.7 | -2.754 | -0.927 | 166.3 | -2.459 | -1.498 | 172.2 | 0.29 | 0.5 | 0.64 | 5.9
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
