akshada-raghuvanshiii/Adaptive_Retail_Companion/evaluation/arc_compact_store_kit/output/layout_preview.png

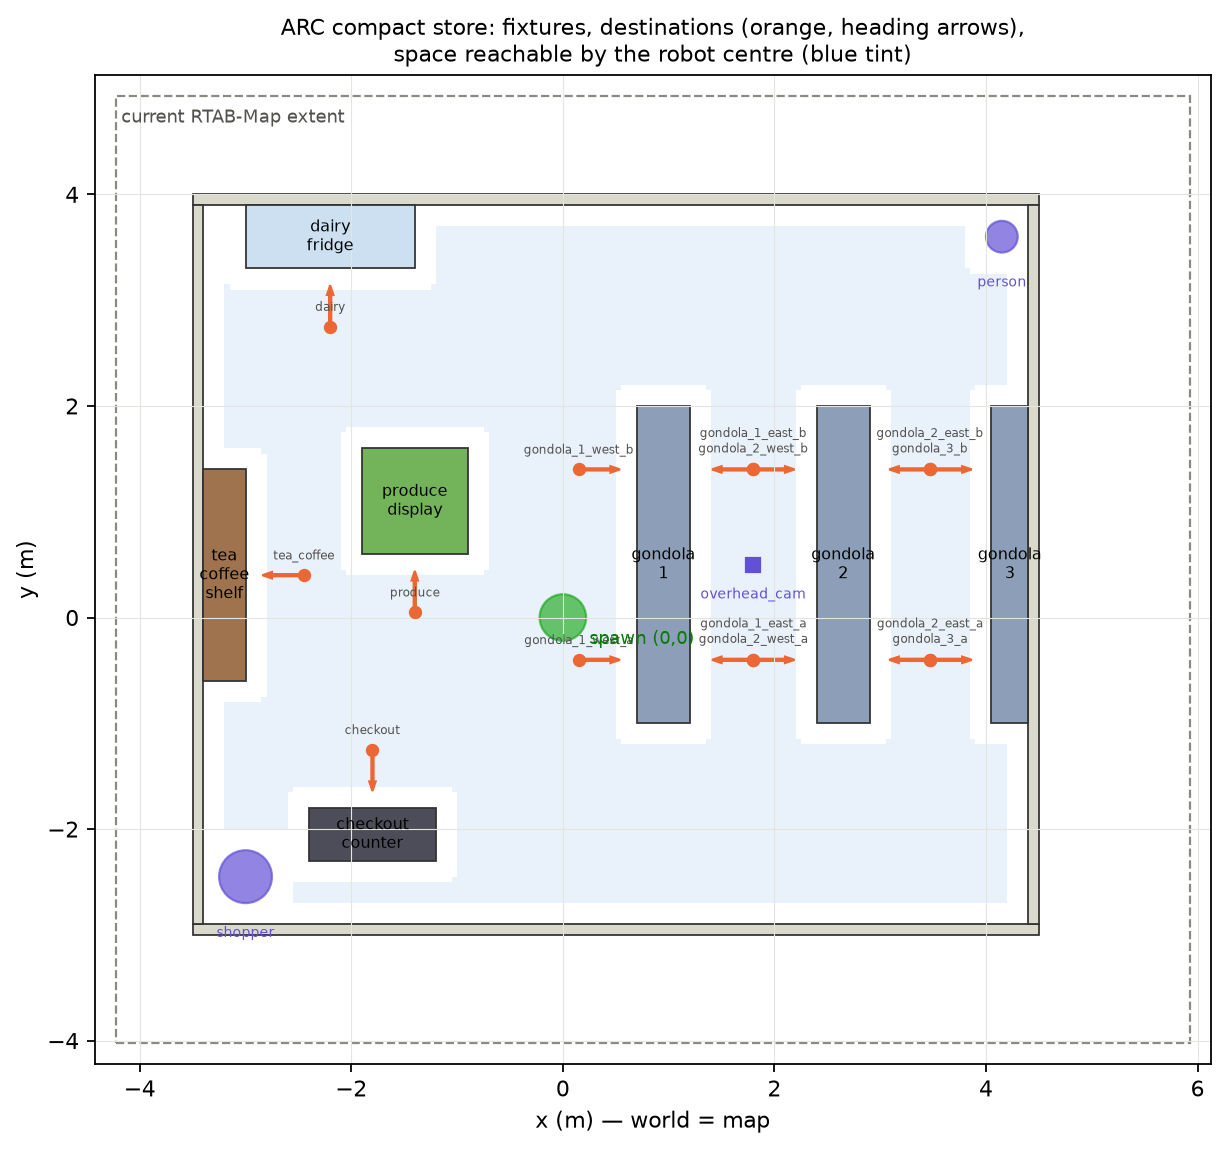
evaluation/arc_compact_store_kit/output/layout_preview.png
