akshada-raghuvanshiii/Adaptive_Retail_Companion/evaluation/arc_compact_store_kit/output/world_3d_preview.png

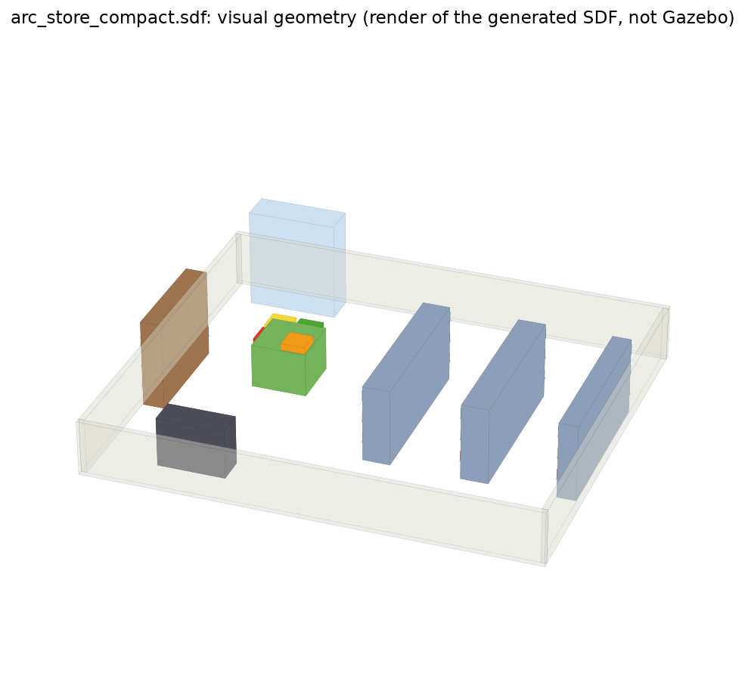
evaluation/arc_compact_store_kit/output/world_3d_preview.png
