akshada-raghuvanshiii/Adaptive_Retail_Companion/docs/paper/latex/figs/fig1_architecture.pdf

/scan, /odom | /odom_icp | map pose (TF), map | /planned_path

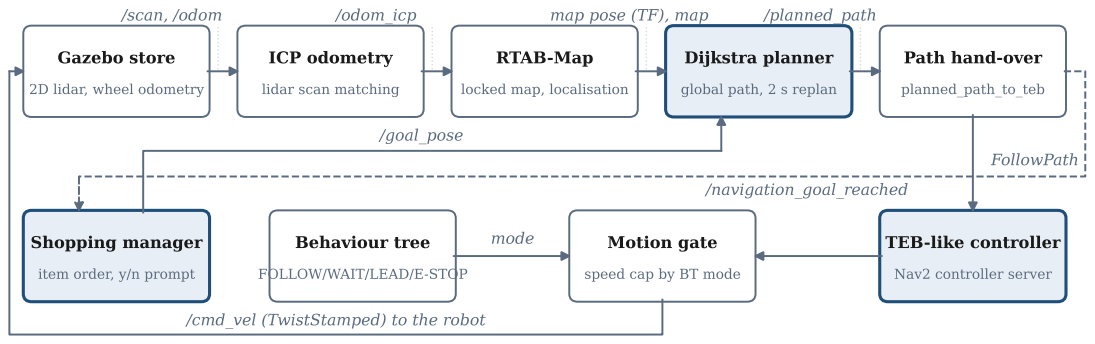
[picture p52: page 1]
Gazebo store; ICP odometry; RTAB-Map; Dijkstra planner; planned_path_to_teb; Shopping manager; Behaviour tree; Motion gate; Nav2 controller server; FollowPath; mode; /goal_pose; /navigation_goal_reached

Path hand-over

2D lidar, wheel odometry

lidar scan matching

locked map, localisation

global path, 2 s replan

TEB-like controller

item order, y/n prompt

FOLLOW/WAIT/LEAD/E-STOP

speed cap by BT mode

/cmd_vel (TwistStamped) to the robot
