akshada-raghuvanshiii/Adaptive_Retail_Companion/docs/paper/latex/figs/fig8_hil_timeline.pdf

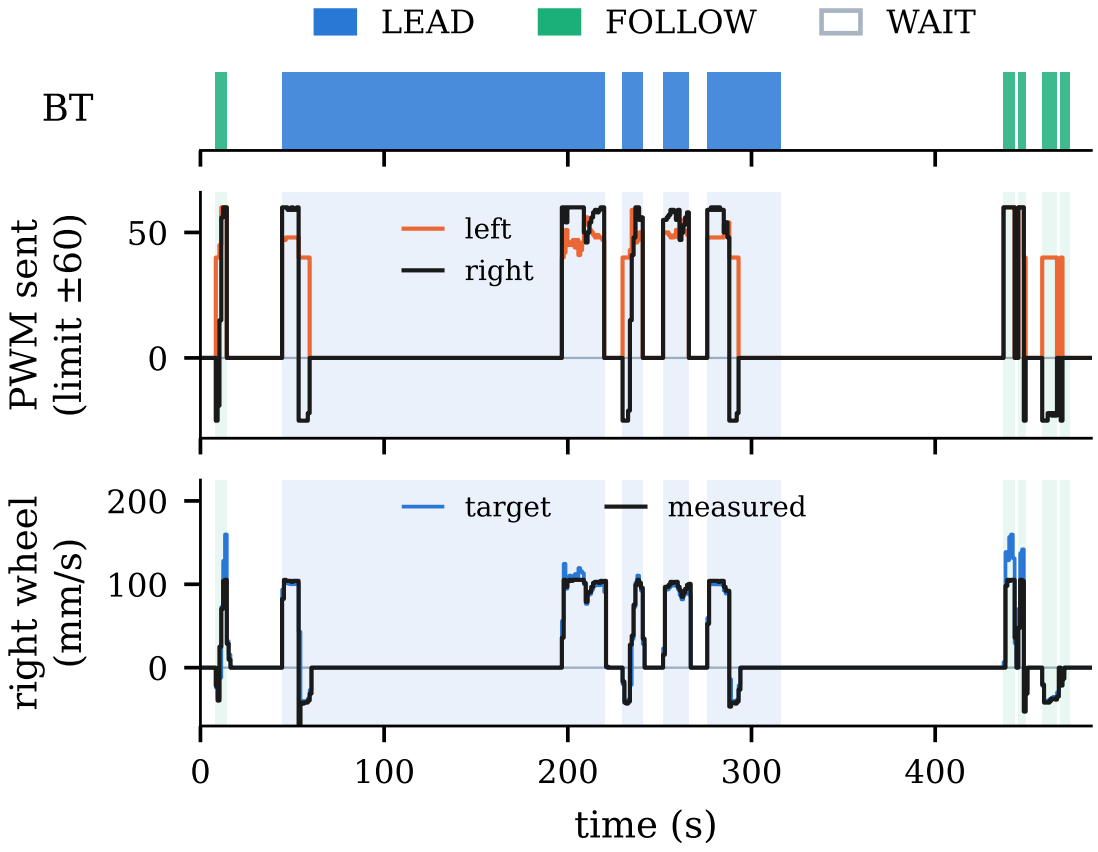
[picture p53: page 1]
LEAD; FOLLOW; WAIT; PWM sent; (limit ±60); left; right; time (s); right wheel; target; measured
