akshada-raghuvanshiii/Adaptive_Retail_Companion/docs/paper/latex/figs/fig6_phase2.pdf

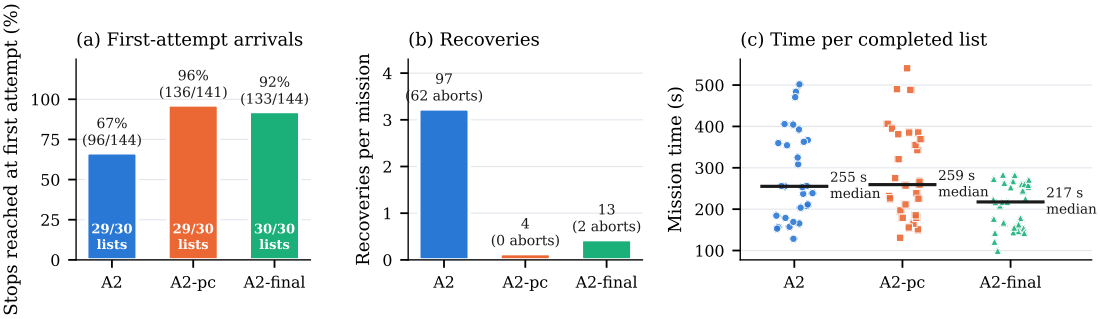
[picture p54: page 1]
A2-final; first attempt (%); 29/30 lists; 30/30 lists; Recoveries per mission; 97 (62 aborts); 4 (0 aborts); 13 (2 aborts); (b) Recoveries; Mission time (s); 255 s median; median

(a) First-attempt arrivals

(c) Time per completed list

Stops reached at
