akshada-raghuvanshiii/Adaptive_Retail_Companion/(commit log)

2026-10-20 Add full ARC project: ROS 2 workspace, perception, hardware, evaluation, mechanical and docs
    - ros2_ws/src: arc_planner, teb_local_planner (TEB-like), arc_behavior_tree,
    arc_store_sim, arc_person_follower, autonomous_tb3, arc_ui_bridge, arc_hw_bridge
    - perception: YOLOv8n + ByteTrack target lock on the Pi, UDP relay
    - hardware: Arduino firmware and bench tools, Raspberry Pi HIL scripts
    - evaluation: test kit, compact-store kit, phase-2 fixes, raw results
    - mechanical: STEP CAD, geometry and FEA scripts, SimScale results
    - docs: capstone report, IEEE paper and LaTeX source, figures, run sheets
    Claude-Session: https://claude.ai/code/se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
2026-10-20 Blur camera feed in perception figure; update report
    Claude-Session: https://claude.ai/code/session_01LhqczA3XyArN7G3ozoPL2x
2026-10-20 UI: store wayfinding look (aisle colours, bundled fonts, sentence-case labels)
    Every item, list entry and route stop now carries its aisle colour, matching
    the RViz store markers. Atkinson Hyperlegible and Barlow Condensed are bundled
    so the page works with Wi-Fi off. Inline styles moved into style.css.
    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
2026-10-20 UI: friendlier look and easier flow
    Rounded Fredoka headings, a small cart mascot, a 3-step guide (add items,
    choose a route, follow ARC), a 'what to do now' card that shows only the
    button that makes sense, a start bar that follows you on phones, and robot
    diagnostics folded into 'Robot details'. Aisle colours unchanged.
    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
2026-10-20 Demo: perception on a second laptop instead of the Pi
    arc_demo.sh gains PERC=<IP>: no Pi ssh window, the relay accepts only that
    address, any shared network works. perception/second_laptop holds setup and
    start scripts for Linux and Windows. Default behaviour unchanged.
    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
2026-10-20 Demo: rehearsal without webcam or motors
    arc_demo.sh gains NO_MOTORS=1 (no Uno check, no ARC_motors window).
    run_perception.sh/.bat pass extra options, so a recorded clip with --loop
    can stand in for the webcam. Run sheet gains a rehearse-tonight section.
    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
2026-10-20 Perception laptop: quote the camera path on Windows, add VS Code tasks
    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
